Gmj080305/Tdk/README.md

# Tdk

contains all important files i created/used for my 6 weeks internship at TDK Electronics Nashik
Current Projects:
1] new avenues for film capacitors due to new tech advancements
2] implementing ESL measurement on an assembly line
