Gmj080305/Tdk/ESL Method comparison.md

Advanced Metrological Characterization of Nanohenry Inductance and Capacitance in Metallized Film Capacitors1. Auto-Balanced Bridge (ABB) MethodTheoretical Foundations & Mathematical DerivationsThe Auto-Balanced Bridge (ABB) architecture represents the primary instrumentation standard for high-precision impedance measurements from low frequencies up to approximately $120\,\text{MHz}$. The working mechanism relies on maintaining a virtual ground potential at the low terminal of the Device Under Test (DUT), thereby neutralizing the effect of parasitic impedances to ground and isolating the complex impedance vector of the film capacitor.The complex impedance of a real metallized film capacitor is modeled by the series equivalent circuit:$$Z_x = R + j\left(\omega L - \frac{1}{\omega C}\right)$$In the ABB configuration, a known AC voltage stimulus $V_x$ is applied to the High-Force ($H_{\text{cur}}$) terminal of the DUT. The resulting current $I_x$ flows through the capacitor to the Low-Force ($L_{\text{cur}}$) terminal. An active Operational Transimpedance Amplifier (OTA) detects any current flow at the $L_{\text{cur}}$ node and dynamically adjusts its output voltage $V_r$ through a known range-feedback resistor $R_r$ to force the potential at the $L_{\text{cur}}$ terminal to exactly zero volts. Under these conditions, the nodal current balancing equation at the virtual ground is expressed as:$$I_x + I_r = 0 \implies \frac{V_x}{Z_x} + \frac{V_r}{R_r} = 0$$Solving for the complex impedance vector $Z_x$ yields:$$Z_x = -R_r \cdot \frac{V_x}{V_r}$$To extract the physical parameters from the raw measured complex ratio, the instrument decomposes the voltage ratio into real and imaginary parts:$$\frac{V_x}{V_r} = A + jB$$Substituting this ratio back into the impedance equation yields:$$Z_x = -R_r(A + jB) = R_s + jX_s$$Where the apparent series resistance $R_s$ and apparent series reactance $X_s$ are isolated as:$$R_s = -R_r A$$$$X_s = -R_r B$$At a single test frequency $\omega$, a conventional instrument reports the apparent series capacitance $C_s$ based on a simplified two-element capacitive model :$$C_s = -\frac{1}{\omega X_s} = \frac{1}{\omega R_r B}$$However, the true physical reactance of the film capacitor includes both the dielectric capacitance $C$ and the nanohenry-range equivalent series inductance $ESL$ ($L$). Near or above the self-resonant frequency (SRF), the inductive reactance counteracts the capacitive reactance, leading to a systematic overestimation of the apparent capacitance. To isolate the true frequency-independent capacitance $C$ and the nanohenry $ESL$, the instrument must perform measurements at two distinct frequencies, $\omega_1$ and $\omega_2$, within the capacitive regime :$$X_{s1} = \omega_1 L - \frac{1}{\omega_1 C}$$$$X_{s2} = \omega_2 L - \frac{1}{\omega_2 C}$$Multiplying both equations by their respective angular frequencies yields:$$\omega_1 X_{s1} = \omega_1^2 L - \frac{1}{C}$$$$\omega_2 X_{s2} = \omega_2^2 L - \frac{1}{C}$$Subtracting the first equation from the second eliminates the capacitive term, allowing the direct isolation of the true equivalent series inductance $L$:$$L = \frac{\omega_1 X_{s1} - \omega_2 X_{s2}}{\omega_1^2 - \omega_2^2}$$To isolate the true capacitance $C$, we multiply the equations to establish a common inductive multiplier:$$\omega_1 \omega_2^2 X_{s1} = \omega_1^2 \omega_2^2 L - \frac{\omega_2^2}{C}$$$$\omega_1^2 \omega_2 X_{s2} = \omega_1^2 \omega_2^2 L - \frac{\omega_1^2}{C}$$Subtracting the second equation from the first and solving for $C$ provides the exact parameter extrapolation formula:$$C = \frac{\omega_1^2 - \omega_2^2}{\omega_1 \omega_2^2 X_{s1} - \omega_1^2 \omega_2 X_{s2}}$$Comprehensive Solved Numerical ExampleThe baseline DUT possesses the following true physical parameters:Intrinsic Dielectric Capacitance ($C$) = $2.919\,\mu\text{F} = 2.919 \times 10^{-6}\,\text{F}$Intrinsic Equivalent Series Inductance ($L$) = $20.90\,\text{nH} = 2.090 \times 10^{-8}\,\text{H}$Intrinsic Equivalent Series Resistance ($R$) = $15.01\,\text{m}\Omega = 15.01 \times 10^{-3}\,\Omega$The instrument performs a sweep and evaluates the DUT at two discrete, highly demanding test points:Test Point 1: $f_1 = 100\,\text{kHz} \implies \omega_1 = 2\pi \times 10^5 \approx 628,318.5307\,\text{rad/s}$Test Point 2: $f_2 = 300\,\text{kHz} \implies \omega_2 = 2\pi \times 3 \times 10^5 \approx 1,884,955.5922\,\text{rad/s}$At $\omega_1$:Capacitive Reactance: $X_{C1} = -\frac{1}{\omega_1 C} = -\frac{1}{628,318.5307 \times 2.919 \times 10^{-6}} \approx -0.5452372\,\Omega$Inductive Reactance: $X_{L1} = \omega_1 L = 628,318.5307 \times 2.090 \times 10^{-8} \approx 0.0131319\,\Omega$Net Apparent Reactance: $X_{s1} = 0.0131319 - 0.5452372 = -0.5321053\,\Omega$Apparent Capacitance reported by a single-frequency LCR meter :
$$C_{s1} = -\frac{1}{\omega_1 X_{s1}} = \frac{1}{628,318.5307 \times 0.5321053} \approx 2.991101\,\mu\text{F}$$At $\omega_2$:Capacitive Reactance: $X_{C2} = -\frac{1}{\omega_2 C} = -\frac{1}{1,884,955.5922 \times 2.919 \times 10^{-6}} \approx -0.1817457\,\Omega$Inductive Reactance: $X_{L2} = \omega_2 L = 1,884,955.5922 \times 2.090 \times 10^{-8} \approx 0.0393956\,\Omega$Net Apparent Reactance: $X_{s2} = 0.0393956 - 0.1817457 = -0.1423501\,\Omega$Apparent Capacitance reported:$$C_{s2} = -\frac{1}{\omega_2 X_{s2}} = \frac{1}{1,884,955.5922 \times 0.1423501} \approx 3.725916\,\mu\text{F}$$Applying the dual-frequency parameter extrapolation to reconstruct the true, uncorrupted parameters:$$L = \frac{(628,318.5307 \times -0.5321053) - (1,884,955.5922 \times -0.1423501)}{(628,318.5307)^2 - (1,884,955.5922)^2}$$$$\text{Numerator} = -334,331.6136 - (-268,323.4187) = -66,008.1949$$$$\text{Denominator} = 3.94784176 \times 10^{11} - 3.55305758 \times 10^{12} = -3.15827340 \times 10^{12}$$$$L = \frac{-66,008.1949}{-3.15827340 \times 10^{12}} \approx 2.089998 \times 10^{-8}\,\text{H} \approx 20.90\,\text{nH}$$Now reconstructing the true dielectric capacitance $C$:$$C = \frac{3.94784176 \times 10^{11} - 3.55305758 \times 10^{12}}{(628,318.5307 \times 3.55305758 \times 10^{12} \times -0.5321053) - (3.94784176 \times 10^{11} \times 1,884,955.5922 \times -0.1423501)}$$$$\text{Numerator} = -3.15827340 \times 10^{12}$$$$\text{Denominator} = -1.188044 \times 10^{18} - (-1.059293 \times 10^{17}) = -1.0821147 \times 10^{18}$$$$C = \frac{-3.15827340 \times 10^{12}}{-1.0821147 \times 10^{18}} \approx 2.918612 \times 10^{-6}\,\text{F} \approx 2.919\,\mu\text{F}$$This demonstration verifies that the dual-frequency model successfully isolates the true nanohenry-level $ESL$ and nominal capacitance from the apparent reactances.Practical Hardware Architecture & Bench SetupThe physical instrumentation consists of a Keysight E4990A Impedance Analyzer interfaced through a Four-Terminal Pair (4TP) configuration. The 4TP topology is essential to prevent mutual inductive coupling and cable capacitance from corrupting the sub-microohm and nanohenry measurement path.  Keysight E4990A Front Panel                       Coaxial Test Fixture
+-------------------------------+             +-------------------------------+
|  H_cur (High Current Out) ----|--[ Coax ]---|-- H_cur Terminal              |
|  H_pot (High Potential Sense)-|--[ Coax ]---|-- H_pot Terminal              |
|  L_pot (Low Potential Sense) -|--[ Coax ]---|-- L_pot Terminal              |
|  L_cur (Low Current Return) --|--[ Coax ]---|-- L_cur Terminal              |
+-------------------------------+             +-------------------------------+
                                                 | (Gold-Plated Contact Jaws)
                                                 v
                                             +-------+
                                             |  DUT  |
                                             +-------+
The coaxial shields of all four cables are connected together at the terminal tips of the test fixture to ensure that the return current flows through the outer conductor of the coaxial lines, thereby minimizing external loop inductance. Gold-plated kelvin clamp jaws (e.g., Keysight 16047E) are mounted inside an aluminum Faraday shielded enclosure to isolate the high-impedance sensing nodes from electromagnetic interference.Calibration and vector error correction follow a strict Standard Operating Procedure (SOP):Open Compensation: The contacts are separated to the exact nominal terminal spacing of the DUT. The instrument measures and records the residual stray admittance vector $Y_{oc} = G_o + j\omega C_o$ to compensate for leakage paths.Short Compensation: A high-conductivity copper shorting block is clamped between the contacts. The instrument records the residual series impedance vector $Z_{sc} = R_s + j\omega L_s$.Load Compensation: A precision $50\,\Omega$ coaxial resistor standard is measured to adjust for transmission line phase shifts and gain errors.Analytical Accuracy & Uncertainty BudgetThe primary error vectors in the ABB method include phase detector resolution limits, loop-gain rolloff at high frequencies, and residual short-circuit inductance within the fixture. When isolating a $20.90\,\text{nH}$ inductance in series with a $2.919\,\mu\text{F}$ capacitor, the phase angle $\theta$ is close to $-90^\circ$. A tiny phase measurement error translates into a massive relative uncertainty in the extracted series resistance $R$ and inductance $L$.$$\theta = \arctan\left(\frac{X_s}{R}\right) = \arctan\left(\frac{-0.5321053}{0.01501}\right) \approx -88.384^\circ$$An uncertainty model is constructed below using a Root-Sum-Square (RSS) sensitivity analysis.Error SourceProbability DistributionStandard Uncertainty ValueSensitivity CoefficientInductance ContributionPhase Detector ResolutionRectangular$\pm 0.005^\circ$$1.25 \times 10^{-10}\,\text{H/}^\circ$$\pm 0.063\,\text{nH}$Residual Short InductanceNormal ($k=1$)$\pm 0.150\,\text{nH}$ $1.00$$\pm 0.150\,\text{nH}$Range Resistor ($R_r$) DriftTriangular$\pm 10\,\text{ppm/}^\circ\text{C}$$4.20 \times 10^{-11}\,\text{H/ppm}$$\pm 0.042\,\text{nH}$Guard-Loop Leakage CurrentRectangular$\pm 0.05\,\mu\text{A}$$1.80 \times 10^{-4}\,\text{H/A}$$\pm 0.009\,\text{nH}$Combined Standard Uncertainty ($U_c$)Normal ($k=1$)——$\pm 0.168\,\text{nH}$Long-Term Reliability & Stability AnalysisThe long-term measurement stability of the ABB architecture is highly sensitive to the thermal drift of the internal range-feedback resistors $R_r$. A temperature drift of $\pm 5^\circ\text{C}$ shifts the transimpedance amplifier gain, causing phase errors that translate directly into false inductive reactances. Thermal control within the metrology lab must be maintained at $23^\circ\text{C} \pm 1^\circ\text{C}$ to prevent degradation of the calibration vector.Calibration validity degrades over time due to oxide formation on the gold-plated contact tips of the 4TP fixture. This increases contact resistance and introduces localized parasitic capacitances, limiting the calibration lifespan to approximately 8 hours under continuous use.Mechanical robustness depends on maintaining a constant contact pressure at the capacitor terminals. Probe wear and contact deformation alter the physical reference plane, necessitating the use of pneumatic clamp fixtures with automated torque control.Formal Gauge R&R FrameworkThe statistical variance of the measurement system is modeled using the classical analysis of variance (ANOVA) decomposition :$$\sigma^2_{\text{total}} = \sigma^2_{\text{part}} + \sigma^2_{\text{system}} = \sigma^2_{\text{part}} + \sigma^2_{\text{repeatability}} + \sigma^2_{\text{reproducibility}}$$Repeatability (Equipment Variance, $EV$) represents the variation obtained when the same operator measures the same part multiple times using the same instrument setup :$$EV = 5.15 \cdot \sqrt{MSE}$$Where $MSE$ is the Mean Square Error calculated from the ANOVA table. Reproducibility (Appraiser Variance, $AV$) represents the variation in the average of the measurements made by different operators :$$AV = \sqrt{\left(5.15 \cdot \sigma_{\text{operator}}\right)^2 - \frac{EV^2}{n \cdot r}}$$Where $n$ is the number of parts, and $r$ is the number of trials.Method-Specific VulnerabilitiesUnder the ABB configuration, $AV$ is highly vulnerable to manual clamping depth variations. Inserting the capacitor leads slightly deeper into the contact jaws reduces the active lead length. Since standard copper lead wire exhibits approximately $1\,\text{nH/mm}$ of self-inductance, a manual insertion depth variance of $\pm 1.5\,\text{mm}$ introduces a $\pm 1.5\,\text{nH}$ Appraiser Variance, representing a $7.1\%$ error relative to the $20.90\,\text{nH}$ baseline.Mitigation ProtocolsTo achieve an acceptable %GRR ($<10\%$) :Pneumatic Clamping Slides: Implement automated, pneumatic clamp slides that apply a constant contact force of $6.5\,\text{N} \pm 0.1\,\text{N}$.Ceramic Depth Stops: Integrate non-conductive, high-precision alumina ceramic depth stops inside the clamp jaws to limit the insertion depth of the capacitor leads to exactly $1.50\,\text{mm} \pm 0.05\,\text{mm}$.2. Voltage Surge Discharge MethodTheoretical Foundations & Mathematical DerivationsThe Voltage Surge Discharge Method is an active time-domain characterization technique used to isolate equivalent series inductance ($ESL$) and resistance ($ESR$) by measuring the underdamped ringing current waveform generated when a pre-charged capacitor is discharged through a low-impedance switch. The physical discharge loop is modeled as a series $RLC$ circuit:      +-----+      +-----+      +-----+
+-----|  C  |------|  L  |------|  R  |-----+
|     +-----+      +-----+      +-----+     |
|                                           |
+---------------------------------+
The second-order linear differential equation governing the transient loop current $i(t)$ is:$$L \frac{d^2 i(t)}{dt^2} + R \frac{di(t)}{dt} + \frac{1}{C} i(t) = 0$$Dividing by the loop inductance $L$ yields the standard form:$$\frac{d^2 i(t)}{dt^2} + \frac{R}{L} \frac{di(t)}{dt} + \frac{1}{LC} i(t) = 0$$The roots of the characteristic equation in the Laplace domain are :$$s^2 + \frac{R}{L}s + \frac{1}{LC} = 0 \implies s_{1,2} = -\alpha \pm \sqrt{\alpha^2 - \omega_0^2}$$Where the Neper frequency $\alpha$ and the undamped resonant angular frequency $\omega_0$ are defined as:$$\alpha = \frac{R}{2L}$$$$\omega_0 = \frac{1}{\sqrt{LC}}$$For the underdamped condition ($\alpha < \omega_0$), the roots are complex conjugates, $s_{1,2} = -\alpha \pm j\omega_d$, where the damped resonant angular frequency $\omega_d$ is :$$\omega_d = \sqrt{\omega_0^2 - \alpha^2} = \sqrt{\frac{1}{LC} - \left(\frac{R}{2L}\right)^2}$$Using the initial conditions of the fully charged capacitor, where $q(0) = Q_0 = C V_0$ and the initial current $i(0) = 0$, the time-dependent current waveform is solved as :$$i(t) = \frac{V_0}{\omega_d L} e^{-\alpha t} \sin(\omega_d t)$$To extract the physical parameters from the experimental waveform, the period of the damped oscillation $T_d$ is measured from the time interval between the first and third zero-crossings :$$T_d = \frac{2\pi}{\omega_d} \implies \omega_d = \frac{2\pi}{T_d}$$The rate of decay is quantified by the logarithmic decrement $\delta$, calculated from two consecutive positive current peaks, $I_1$ and $I_2$, separated by a full period $T_d$:$$\delta = \ln\left(\frac{I_1}{I_2}\right) = \alpha T_d \implies \alpha = \frac{\delta}{T_d}$$Once $\alpha$ and $\omega_d$ are determined, the undamped resonant frequency is computed:$$\omega_0 = \sqrt{\omega_d^2 + \alpha^2}$$Using the nominal capacitance $C$ (which must be independently characterized at a low reference frequency), the total loop inductance $L_{\text{loop}}$ and series resistance $R_{\text{loop}}$ are calculated as:$$L_{\text{loop}} = \frac{1}{\omega_0^2 C}$$$$R_{\text{loop}} = 2 \alpha L_{\text{loop}}$$To isolate the true capacitor $ESL$ ($L$) and $ESR$ ($R$), the calibrated external parasitic inductance ($L_{\text{ext}}$) and resistance ($R_{\text{ext}}$) of the fixture must be subtracted :$$L = L_{\text{loop}} - L_{\text{ext}}$$$$R = R_{\text{loop}} - R_{\text{ext}}$$Comprehensive Solved Numerical ExampleThe true parameters of the DUT are:$C = 2.919\,\mu\text{F} = 2.919 \times 10^{-6}\,\text{F}$$L = 20.90\,\text{nH} = 2.090 \times 10^{-8}\,\text{H}$$R = 15.01\,\text{m}\Omega = 15.01 \times 10^{-3}\,\Omega$The discharge loop is pre-calibrated and possesses the following parasitics:$L_{\text{ext}} = 10.00\,\text{nH} = 1.000 \times 10^{-8}\,\text{H}$ $R_{\text{ext}} = 5.00\,\text{m}\Omega = 5.000 \times 10^{-3}\,\Omega$ This yields the total loop parameters:$C_{\text{loop}} = 2.919\,\mu\text{F}$$L_{\text{loop}} = 20.90\,\text{nH} + 10.00\,\text{nH} = 30.90\,\text{nH} = 3.090 \times 10^{-8}\,\text{H}$$R_{\text{loop}} = 15.01\,\text{m}\Omega + 5.00\,\text{m}\Omega = 20.01\,\text{m}\Omega = 0.02001\,\Omega$The capacitor is charged to an initial voltage $V_0 = 1000\,\text{V}$.Calculating the physical parameters of the underdamped transient response:Neper Frequency:$$\alpha = \frac{R_{\text{loop}}}{2 L_{\text{loop}}} = \frac{0.02001}{2 \times 3.090 \times 10^{-8}} \approx 323,786.4078\,\text{s}^{-1}$$Undamped Resonant frequency:$$\omega_0 = \frac{1}{\sqrt{L_{\text{loop}} C_{\text{loop}}}} = \frac{1}{\sqrt{3.090 \times 10^{-8} \times 2.919 \times 10^{-6}}} \approx 3,330,031.5369\,\text{rad/s}$$Damped Resonant Frequency:$$\omega_d = \sqrt{\omega_0^2 - \alpha^2} = \sqrt{(3,330,031.5369)^2 - (323,786.4078)^2} \approx 3,214,198.5414\,\text{rad/s}$$Damped Period:$$T_d = \frac{2\pi}{\omega_d} = \frac{2\pi}{3,214,198.5414} \approx 1.954823 \times 10^{-6}\,\text{s} \approx 1.9548\,\mu\text{s}$$Logarithmic Decrement:$$\delta = \alpha T_d = 323,786.4078 \times 1.954823 \times 10^{-6} \approx 0.632945$$The first peak of the current waveform occurs at:$$t_{\text{peak}} = \frac{1}{\omega_d} \arctan\left(\frac{\omega_d}{\alpha}\right) = \frac{1}{3,214,198.5414} \arctan\left(\frac{3,214,198.5414}{323,786.4078}\right) \approx 457.46\,\text{ns}$$Calculating the peak current $I_1$ at $t_{\text{peak}}$:$$I_1 = \frac{1000}{3,214,198.5414 \times 3.090 \times 10^{-8}} e^{-323,786.4078 \times 4.5746 \times 10^{-7}} \sin\left(1.47038\right) \approx 8,638.64\,\text{A}$$The second positive peak occurs at $t = t_{\text{peak}} + T_d \approx 2.4123\,\mu\text{s}$:$$I_2 = I_1 e^{-\alpha T_d} = 8,638.64 \times e^{-0.632945} \approx 4,587.35\,\text{A}$$During the physical experiment, the oscilloscope captures the current peaks and period. Reconstructing the parameters from the digitized data:$$\delta = \ln\left(\frac{8,638.64}{4,587.35}\right) \approx 0.632945$$$$\omega_d = \frac{2\pi}{1.954823 \times 10^{-6}} \approx 3,214,198.54\,\text{rad/s}$$$$\alpha = \frac{\delta \omega_d}{2\pi} \approx 323,786.41\,\text{s}^{-1}$$$$\omega_0 = \sqrt{\omega_d^2 + \alpha^2} \approx 3,330,031.54\,\text{rad/s}$$$$L_{\text{loop}} = \frac{1}{\omega_0^2 C} = \frac{1}{(3,330,031.54)^2 \times 2.919 \times 10^{-6}} \approx 30.90\,\text{nH}$$Subtracting loop parasitics isolates the true capacitor inductance:$$L = L_{\text{loop}} - L_{\text{ext}} = 30.90\,\text{nH} - 10.00\,\text{nH} = 20.90\,\text{nH}$$The physical verification perfectly aligns with the analytical model, validating mathematical continuity.Practical Hardware Architecture & Bench SetupThe physical hardware architecture of the surge discharge system requires a low-inductance, coaxial loop design to minimize structural parasitic inductance.+-------------------------------------------------------+
|  ---> Charging Resistor (100 kOhm)     |
|                             |                         |
|                             +---+                     |
|                                 v                     |
|  +------------------------------------+  |
|  |                                                 |  |
|  |  +-----------------+  +-----------------+       |  |
|  |  |   Film Capacitor|  |  Coaxial Current|       |  |
|  |  |       (DUT)     |  |   Shunt (0.1mR) |       |  |
|  |  +-----------------+  +-----------------+       |  |
|  +-------------------------------------------------+  |
|  Faraday Shielded Coaxial Housing                     |
+-------------------------------------------------------+
Switching Element: A high-speed, triggered gas-filled spark gap switch is utilized to ensure a sub-nanosecond voltage fall time ($t_{\text{fall}} < 10\,\text{ns}$) and prevent pre-fire jitter.Current Sensor: A coaxial current viewing resistor (shunt) with an integrated bandwidth of $1\,\text{GHz}$ (e.g., T&M Research SSDN series, $0.1\,\text{m}\Omega$) is placed in series with the return path to prevent magnetic flux pick-up.Digitizer: A high-resolution, $2\,\text{GS/s}$, 10-bit real-time digitizer captures the transient voltage across the shunt.SOP for Loop Calibration: The loop parasitics $L_{\text{ext}}$ and $R_{\text{ext}}$ are determined by replacing the capacitor with a solid copper dummy block that mirrors the external dimensions and terminal geometry of the DUT. The resulting underdamped ringing is fitted to calculate $L_{\text{ext}}$ and $R_{\text{ext}}$.Analytical Accuracy & Uncertainty BudgetThe accuracy of this time-domain method is limited by the sampling interval of the digitizer and the dynamic arc resistance of the spark gap. At $2\,\text{GS/s}$, the sampling resolution is $\pm 500\,\text{ps}$.The uncertainty budget for the $20.90\,\text{nH}$ inductance measurement is structured below.Error SourceProbability DistributionStandard Uncertainty ValueSensitivity CoefficientInductance ContributionDigitizer Sampling JitterRectangular$\pm 500\,\text{ps}$$3.16 \times 10^{-2}\,\text{nH/ns}$$\pm 0.016\,\text{nH}$Spark Gap Dynamic ResistanceNormal ($k=2$)$\pm 0.80\,\text{m}\Omega$$1.50 \times 10^{-9}\,\text{H/}\Omega$$\pm 0.120\,\text{nH}$Dummy block calibration errorTriangular$\pm 0.05\,\text{nH}$ $1.00$$\pm 0.035\,\text{nH}$Coaxial Shunt Thermal DriftNormal ($k=1$)$\pm 0.2\%$ of reading$4.18 \times 10^{-2}\,\text{nH/\%}$$\pm 0.084\,\text{nH}$Combined Standard Uncertainty ($U_c$)Normal ($k=1$)——$\pm 0.151\,\text{nH}$Long-Term Reliability & Stability AnalysisThe primary stability limitation of the Voltage Surge Discharge Method stems from electrode plasma erosion inside the spark gap. Each $8\,\text{kA}$ discharge vaporizes a micro-layer of the copper-tungsten electrode, expanding the gap width and altering the breakdown voltage threshold. This alters the switch fall time and introduces timing offsets, necessitating recalibration every 500 shots.Furthermore, high current transients induce internal dielectric degradation in the metallized film capacitor. The high $di/dt$ stress causes micro-cleavage of the metallized edge contacts, leading to a progressive decrease in capacitance and an artificial increase in $ESR$.Formal Gauge R&R FrameworkThe total variance under high-current surge conditions is decomposed using ANOVA to isolate the physical dependencies of repeatability and reproducibility.Method-Specific VulnerabilitiesSpark Gap Gas Pressure Variation ($AV$): Minor operator-to-operator variations in nitrogen cylinder valve regulation change the chamber pressure by $\pm 0.1\,\text{bar}$. This shifts the breakdown voltage, introducing an Appraiser Variance of $\pm 0.4\,\text{nH}$.Fixture Clamping Torque ($EV$): Inconsistent hand-tightening of the coaxial housing bolts varies contact pressure, creating an Equipment Variance in contact resistance and loop inductance.Mitigation ProtocolsAutomated Pressure Regulators: Use digital mass flow controllers to maintain spark gap nitrogen pressure at exactly $2.20\,\text{bar} \pm 0.01\,\text{bar}$.Pneumatic Torque Wrenches: Tighten all coaxial housing assembly bolts to a standardized torque of $4.5\,\text{N}\cdot\text{m} \pm 0.1\,\text{N}\cdot\text{m}$ to stabilize contact parasitics.3. Vector Network Analyzer (VNA) 2-Port Shunt-Thru MethodTheoretical Foundations & Mathematical DerivationsThe 2-Port Shunt-Thru configuration is the metrological standard for characterizing ultra-low impedances (milliohms to micro-ohms) from kilohertz to gigahertz frequencies. A conventional 1-port reflection measurement ($S_{11}$) is highly inaccurate for sub-ohm impedances because nearly $100\%$ of the signal is reflected back to the receiver, making it impossible to separate the small impedance variations from calibration residual noise.In the 2-port shunt-thru topology, Port 1 acts as the RF source, Port 2 acts as the receiver, and the DUT is connected in shunt (parallel) to ground between the transmission ports :Port 1 (50 Ohm) ----+----------------+---- Port 2 (50 Ohm)
                    |                |
                  +--------------------+
                  |        DUT         |
                  | |
                  +--------------------+
                    |                |
                   GND              GND
Assuming a symmetric system where the source and load ports are terminated in $Z_0 = 50\,\Omega$, the transmission coefficient $S_{21}$ is defined as the ratio of the transmitted voltage wave at Port 2 to the incident voltage wave at Port 1 :$$S_{21} = \frac{2 Z_{\text{DUT}}}{2 Z_{\text{DUT}} + Z_0}$$Solving for $Z_{\text{DUT}}$:$$2 Z_{\text{DUT}} \cdot (1 - S_{21}) = Z_0 \cdot S_{21} \implies Z_{\text{DUT}} = \frac{Z_0}{2} \cdot \frac{S_{21}}{1 - S_{21}}$$For impedances much smaller than the characteristic impedance ($Z_{\text{DUT}} \ll 25\,\Omega$, which corresponds to $S_{21} \ll 1$), the denominator approaches unity, yielding the linear approximation :$$Z_{\text{DUT}} \approx \frac{Z_0}{2} \cdot S_{21} = 25 \cdot S_{21}$$Substituting the real and imaginary parts of the complex transmission coefficient, $S_{21} = \text{Re}(S_{21}) + j\text{Im}(S_{21})$, into the exact formula:$$Z_{\text{DUT}} = 25 \cdot \frac{\text{Re}(S_{21}) + j\text{Im}(S_{21})}{(1 - \text{Re}(S_{21})) - j\text{Im}(S_{21})}$$Multiplying the numerator and denominator by the complex conjugate of the denominator, $(1 - \text{Re}(S_{21})) + j\text{Im}(S_{21})$:$$Z_{\text{DUT}} = 25 \cdot \frac{ + j\text{Im}(S_{21})}{(1 - \text{Re}(S_{21}))^2 + \text{Im}(S_{21})^2}$$$$Z_{\text{DUT}} = 25 \cdot \frac{(\text{Re}(S_{21}) - |S_{21}|^2) + j\text{Im}(S_{21})}{(1 - \text{Re}(S_{21}))^2 + \text{Im}(S_{21})^2}$$The physical series equivalent components of the film capacitor are extracted by isolating the real and imaginary parts over a wide frequency sweep:$$R(\omega) = \text{Re}(Z_{\text{DUT}})$$$$X(\omega) = \text{Im}(Z_{\text{DUT}}) = \omega L - \frac{1}{\omega C}$$At frequencies well above the self-resonant frequency ($f \gg f_{\text{SRF}}$), the capacitive reactance $\frac{1}{\omega C}$ becomes negligible, enabling the direct isolation of the series inductance $L$:$$L \approx \frac{\text{Im}(Z_{\text{DUT}})}{\omega}$$Conversely, at frequencies well below the self-resonant frequency ($f \ll f_{\text{SRF}}$), the inductive reactance $\omega L$ is negligible, yielding the true capacitance $C$:$$C \approx -\frac{1}{\omega \cdot \text{Im}(Z_{\text{DUT}})}$$Comprehensive Solved Numerical ExampleThe true parameters of the DUT are:$C = 2.919\,\mu\text{F} = 2.919 \times 10^{-6}\,\text{F}$$L = 20.90\,\text{nH} = 2.090 \times 10^{-8}\,\text{H}$$R = 15.01\,\text{m}\Omega = 15.01 \times 10^{-3}\,\Omega$The VNA operates with a port impedance $Z_0 = 50\,\Omega$. The test frequency is selected at $f = 1.0\,\text{MHz} \implies \omega = 2\pi \times 10^6 \approx 6.2831853 \times 10^6\,\text{rad/s}$ (above the $644\,\text{kHz}$ self-resonance).Calculating the reactances:Capacitive Reactance:$$X_C = -\frac{1}{\omega C} = -\frac{1}{6.2831853 \times 10^6 \times 2.919 \times 10^{-6}} \approx -0.0545240\,\Omega$$Inductive Reactance:$$X_L = \omega L = 6.2831853 \times 10^6 \times 2.090 \times 10^{-8} \approx 0.1313186\,\Omega$$Net Reactance:$$X = X_L + X_C = 0.1313186 - 0.0545240 \approx 0.0767946\,\Omega$$Complex Impedance:$$Z_{\text{DUT}} = 0.01501 + j0.0767946\,\Omega$$Calculating the transmission coefficient $S_{21}$ that will be registered by the VNA:$$S_{21} = \frac{2 \cdot (0.01501 + j0.0767946)}{2 \cdot (0.01501 + j0.0767946) + 50} = \frac{0.03002 + j0.1535892}{50.03002 + j0.1535892}$$$$\text{Denominator Magnitude} = \sqrt{(50.03002)^2 + (0.1535892)^2} \approx 50.0302554\,\Omega$$$$S_{21} = \frac{(0.03002 + j0.1535892)(50.03002 - j0.1535892)}{(50.0302554)^2} \approx 6.09458 \times 10^{-4} + j3.06811 \times 10^{-3}$$In polar form, this corresponds to:$$|S_{21}| = \sqrt{(6.09458 \times 10^{-4})^2 + (3.06811 \times 10^{-3})^2} \approx 3.128 \times 10^{-3} \implies -50.09\,\text{dB}$$The VNA receiver measures this complex value of $S_{21}$ and reconstructs the complex impedance $Z_{\text{DUT}}$:$$Z_{\text{DUT}} = 25 \cdot \frac{6.09458 \times 10^{-4} + j3.06811 \times 10^{-3}}{(1 - 6.09458 \times 10^{-4}) - j3.06811 \times 10^{-3}} = 25 \cdot \frac{6.09458 \times 10^{-4} + j3.06811 \times 10^{-3}}{0.9993905 - j3.06811 \times 10^{-3}}$$Multiplying the numerator and denominator by the conjugate $0.9993905 + j3.06811 \times 10^{-3}$:$$\text{Denominator} = (0.9993905)^2 + (3.06811 \times 10^{-3})^2 \approx 0.9987908$$$$\text{Real Part} = 25 \cdot \frac{(6.09458 \times 10^{-4} \times 0.9993905) - (3.06811 \times 10^{-3} \times 3.06811 \times 10^{-3})}{0.9987908} \approx 15.01\,\text{m}\Omega$$$$\text{Imaginary Part} = 25 \cdot \frac{(3.06811 \times 10^{-3} \times 0.9993905) + (6.09458 \times 10^{-4} \times 3.06811 \times 10^{-3})}{0.9987908} \approx 76.79\,\text{m}\Omega$$$$Z_{\text{DUT}} \approx 0.01501 + j0.07679\,\Omega$$Solving for the parameters at $1.0\,\text{MHz}$ using the known value $C = 2.919\,\mu\text{F}$ to correct the reactances:$$L = \frac{0.07679 + \frac{1}{\omega C}}{\omega} = \frac{0.07679 + 0.054524}{6.2831853 \times 10^6} \approx 2.090 \times 10^{-8}\,\text{H} = 20.90\,\text{nH}$$The reconstruction algorithm exhibits mathematical continuity.Practical Hardware Architecture & Bench SetupThe physical hardware setup uses a high-performance Vector Network Analyzer (such as a Copper Mountain Technologies C1220 or Keysight E5061B with Option 005).+---------------+          +-------------------+          +---------------+
| VNA Port 1    |--[Coax]--| J2102A            |--[Coax]--| Coplanar      |
|               |          | Common Mode Trans |          | Microstrip    |
+---------------+          +-------------------+          | Probe Head    |
                                                          |               |
+---------------+          +-------------------+          | (Film Cap     |
| VNA Port 2    |--[Coax]--| J2113A            |--[Coax]--|  DUT Shunted) |
|               |          | Semi-Float Amp    |          +---------------+
+---------------+          +-------------------+
An inherent limitation of this method is the ground loop created by the shared ground shields of the coaxial cables connected to Port 1 and Port 2. This ground loop creates an alternative path for the RF current to flow through the outer shields of the cables, bypassing the DUT. This shunt ground current introduces massive measurement errors (often exceeding $400\%$ in the sub-milliohm regime).To eliminate this ground loop:Isolation Transformer: A Picotest J2102A common-mode coaxial transformer (ground-loop breaker) is inserted in-line with the Port 1 transmit cable.Semi-Floating Amplifier: A J2113A differential amplifier is connected to Port 2 to active-float the return path.The calibration plane must be established directly at the capacitor terminal contacts using a Full 2-Port SOLT (Short, Open, Load, Thru) calibration routine. The "Thru" standard is designed as a coplanar microstrip transmission line on a low-loss PTFE substrate (e.g., Rogers RO4350B).Analytical Accuracy & Uncertainty BudgetThe primary analytical vulnerabilities in the VNA Shunt-Thru method include the dynamic range limit of the VNA receiver at high attenuation levels, phase jitter at the calibration plane, and common-mode current leakage. For a $-50\,\text{dB}$ transmission level, trace noise must be kept below $0.005\,\text{dB}$ by using a narrow Intermediate Frequency (IF) bandwidth of $10\,\text{Hz}$ to maximize the signal-to-noise ratio.An uncertainty model is compiled below for the measurement of the $20.90\,\text{nH}$ inductance.Error SourceProbability DistributionStandard Uncertainty ValueSensitivity CoefficientInductance ContributionDynamic Range Trace NoiseNormal ($k=1$)$\pm 0.005\,\text{dB}$$1.20 \times 10^{-10}\,\text{H/dB}$$\pm 0.006\,\text{nH}$Calibration Plane Phase JitterNormal ($k=2$)$\pm 0.02\,\text{rad}$$2.50 \times 10^{-10}\,\text{H/rad}$$\pm 0.005\,\text{nH}$Common-Mode Leakage CurrentRectangular$\pm 0.05\%$ leakage$1.80 \times 10^{-10}\,\text{H/}\%$$\pm 0.090\,\text{nH}$Microstrip Probe Lead Path DriftTriangular$\pm 0.15\,\text{mm}$$1.00 \times 10^{-9}\,\text{H/mm}$ $\pm 0.087\,\text{nH}$Combined Standard Uncertainty ($U_c$)Normal ($k=1$)——$\pm 0.125\,\text{nH}$Long-Term Reliability & Stability AnalysisThe calibration vector's stability is highly dependent on the physical stability of the high-performance phase-stable coaxial cables. Micro-bending of the cables during manual component insertion alters the electrical phase length, causing calibration drift at high frequencies.The calibration cycle must be maintained at 4-hour intervals. Thermal expansion of the Rogers test board alters the characteristic impedance $Z_0$ of the microstrip path by approximately $0.05\,\Omega/^\circ\text{C}$, causing baseline drift.Formal Gauge R&R FrameworkMethod-Specific VulnerabilitiesCoaxial Cable Flexing ($EV$): Operator movement of the test cables during loading alters the phase delay, introducing phase-shifts that distort the extracted inductance value.Probe Tip Wear ($EV$): Planar misalignment of the microstrip probe head relative to the capacitor lead contacts introduces parasitic shunt capacitance.Mitigation ProtocolsSemi-Rigid Cable Installation: Replace conventional flexible coaxial cables with semi-rigid, phase-stable copper-jacketed cables clamped to an optical table bench to eliminate flexing.Automated Micro-positioners: Mount the coplanar probe heads on sub-micron 3-axis stage positioners with integrated pressure indicators to ensure constant contact geometry.4. Radio Frequency Current-Voltage (RF I-V) MethodTheoretical Foundations & Mathematical DerivationsThe RF I-V method is the primary high-frequency metrology technique for impedance characterization from $1\,\text{MHz}$ to $3\,\text{GHz}$. Unlike the Auto-Balanced Bridge, which is limited by the gain-bandwidth product of the feedback loop, the RF I-V method uses a passive coaxial transmission line test head to measure the voltage and current vectors directly.                     Coaxial Test Head
               +---------------------------+
Source ------> | [ Voltmeter ]             |------> DUT (Zx)
               |     |                     |
               |   |
               +---------------------------+
The test head architecture incorporates a matched source impedance $Z_s = 50\,\Omega$ and split detection channels. The RF current $I_x$ passing through the DUT is measured via a toroidal current transformer or a series precision resistor, while the RF voltage $V_x$ across the DUT is measured by a high-impedance voltage probe placed directly at the measurement plane.The complex impedance is:$$Z_x = \frac{V_x}{I_x}$$Let the detected voltage wave vectors be $V_v$ (voltage channel) and $V_i$ (current channel) :$$V_v = A_v \cdot e^{j\phi_v}$$$$V_i = A_i \cdot e^{j\phi_i}$$The system transfer function includes complex calibration scaling vectors $H_v(\omega)$ and $H_i(\omega)$ that account for path loss and phase shifts inside the test head:$$Z_x = \frac{H_v(\omega) \cdot V_v}{H_i(\omega) \cdot V_i} = Z_{\text{ref}}(\omega) \cdot \frac{V_v}{V_i}$$The series equivalent components are extracted from the complex impedance $Z_x = R_s + jX_s$:$$R_s = \text{Re}(Z_x)$$$$X_s = \text{Im}(Z_x)$$Because the test frequency is in the RF domain (typically $>10\,\text{MHz}$), the capacitive reactance of a microfarad-range capacitor is extremely small, and the impedance spectrum is dominated by the nanohenry-range $ESL$ :$$X_s = \omega L - \frac{1}{\omega C}$$At $10\,\text{MHz}$, for $C \approx 2.9\,\mu\text{F}$ and $L \approx 20.9\,\text{nH}$, the capacitive reactance is $-j0.005\,\Omega$, while the inductive reactance is $+j1.313\,\Omega$. The contribution of the capacitance can be modeled and subtracted to yield the true $ESL$:$$L = \frac{X_s + \frac{1}{\omega C}}{\omega} = \frac{X_s}{\omega} + \frac{1}{\omega^2 C}$$The second term $\frac{1}{\omega^2 C}$ is the correction factor for the residual capacitive coupling.Comprehensive Solved Numerical ExampleThe true parameters of the DUT are:$C = 2.919\,\mu\text{F} = 2.919 \times 10^{-6}\,\text{F}$$L = 20.90\,\text{nH} = 2.090 \times 10^{-8}\,\text{H}$$R = 15.01\,\text{m}\Omega = 15.01 \times 10^{-3}\,\Omega$The measurement is executed at $f = 10\,\text{MHz} \implies \omega = 2\pi \times 10^7 \approx 6.2831853 \times 10^7\,\text{rad/s}$ (well above self-resonance).Calculating the true impedance vector:Capacitive Reactance:$$X_C = -\frac{1}{\omega C} = -\frac{1}{6.2831853 \times 10^7 \times 2.919 \times 10^{-6}} \approx -0.0054524\,\Omega$$Inductive Reactance:$$X_L = \omega L = 6.2831853 \times 10^7 \times 2.090 \times 10^{-8} \approx 1.3131857\,\Omega$$Net Reactance:$$X_s = 1.3131857 - 0.0054524 = 1.3077333\,\Omega$$Complex Impedance:$$Z_x = 0.01501 + j1.3077333\,\Omega$$Magnitude:$$|Z_x| = \sqrt{(0.01501)^2 + (1.3077333)^2} \approx 1.3078194\,\Omega$$Phase Angle:$$\theta = \arctan\left(\frac{1.3077333}{0.01501}\right) \approx 89.3424^\circ \approx 1.55932\,\text{rad}$$The RF test head detects the complex voltage ratio, yielding $|Z_x| = 1.3078194\,\Omega$ and phase $\theta = 89.3424^\circ$.The raw, uncorrected inductance calculated by a simple formula ($L_{\text{raw}} = \frac{X_s}{\omega}$) is:$$L_{\text{raw}} = \frac{1.3077333}{6.2831853 \times 10^7} \approx 2.08132 \times 10^{-8}\,\text{H} \approx 20.813\,\text{nH}$$This represents a systematic underestimation error of $0.41\%$ due to the residual capacitance. Applying the metrological correction factor using the independently known $C = 2.919\,\mu\text{F}$ (measured at low frequency):$$L = L_{\text{raw}} + \frac{1}{\omega^2 C} = 2.08132 \times 10^{-8} + \frac{1}{(6.2831853 \times 10^7)^2 \times 2.919 \times 10^{-6}}$$$$\text{Correction Term} = \frac{1}{3.94784 \times 10^{15} \times 2.919 \times 10^{-6}} = \frac{1}{1.15237 \times 10^{10}} \approx 8.6778 \times 10^{-11}\,\text{H} \approx 0.087\,\text{nH}$$$$L = 20.813\,\text{nH} + 0.087\,\text{nH} = 20.90\,\text{nH}$$The application of the correction term yields the true series inductance of the capacitor, verifying the analytical model.Practical Hardware Architecture & Bench SetupThe instrumentation setup consists of a Keysight E4991B RF Impedance Analyzer connected to the low-impedance test head (E4991B Option 010 low-impedance kit).                     +---------------------------------------+
                     | Keysight E4991B Low-Z Test Head       |
                     |                                       |
Instrument --------> | [ APC-7 Coaxial Port ]                |
                     |           |                           |
                     |   +---------------+                   |
                     |   | APC-7 to SMD  |                   |
                     |   | Test Fixture  |===> DUT Terminal  |
                     |   +---------------+                   |
                     +---------------------------------------+
The physical interface uses an APC-7 (7 mm precision coaxial) connector to establish a repeatable, high-frequency coaxial connection with a low reflection coefficient. The APC-7 connector is adapted to an SMD/lead clamp fixture (e.g., Keysight 16197A).The metrological calibration protocol must be executed at the fixture tips:Open Calibration: Terminals separated.Short Calibration: High-conductivity gold-plated shorting chip is inserted.50 Ohm Load Calibration: A laser-trimmed thin-film planar resistor chip ($50\,\Omega \pm 0.1\%$) is clamped to calibrate the reference gain.Low-Loss Capacitor Calibration: A secondary calibration standard (typically a high-Q sapphire dielectric capacitor of $10\,\text{pF}$) is measured to adjust the high-frequency phase-angle reference.Analytical Accuracy & Uncertainty BudgetThe RF I-V method's accuracy is limited by:Fixture Residual Parameters: Residual inductance ($L_r$) and resistance ($R_r$) within the clamp contacts introduce systematic offsets. At $10\,\text{MHz}$, even a $100\,\text{pH}$ contact inductance represents a $0.5\%$ error in measuring $20.90\,\text{nH}$.Toroidal Transformer Phase Lag: Non-ideal magnetic properties in the current transformer core introduce a frequency-dependent phase lag, distorting the $ESR$ measurement.The uncertainty budget for the measurement of the $20.90\,\text{nH}$ inductance is compiled below:Error SourceProbability DistributionStandard Uncertainty ValueSensitivity CoefficientInductance ContributionResidual contact inductanceNormal ($k=1$)$\pm 50\,\text{pH}$$1.0$$\pm 0.050\,\text{nH}$Phase Detector Gain ErrorNormal ($k=2$)$\pm 0.15\%$ of reading$3.13 \times 10^{-2}\,\text{nH/\%}$$\pm 0.023\,\text{nH}$Low-Loss Cap Cal DriftRectangular$\pm 0.02\,\text{pF}$$8.20 \times 10^{-2}\,\text{nH/pF}$$\pm 0.002\,\text{nH}$Toroidal Transformer Thermal DriftTriangular$\pm 12\,\text{ppm/}^\circ\text{C}$$4.50 \times 10^{-11}\,\text{H/ppm}$$\pm 0.010\,\text{nH}$Combined Standard Uncertainty ($U_c$)Normal ($k=1$)——$\pm 0.056\,\text{nH}$Long-Term Reliability & Stability AnalysisThe RF test head is highly sensitive to self-heating during continuous high-frequency excitation. The internal reference directional couplers and mixers experience thermal drift, which degrades the phase-angle accuracy. Ambient temperature fluctuations must be limited to $\pm 3^\circ\text{C}$ around the calibration baseline, or the metrological software must trigger an automatic recalibration.The gold plating on the APC-7 mating face has a physical lifespan of approximately 2000 mating cycles. Surface scratches or contamination increase contact impedance and degrade calibration stability.Formal Gauge R&R FrameworkMethod-Specific VulnerabilitiesCapacitor Alignment in Fixture Clamps ($EV$): Operator variation in the lateral alignment of the capacitor leads on the gold-plated contact pads alters the current loop area.Contact Force Variation ($AV$): Manual clamping pressure differences alter the constriction resistance at the metal-to-metal interface, introducing variable contact resistance.Mitigation ProtocolsMicrometer Clamping Slides: Use micro-positioner slides to guide lead insertion, ensuring terminal contact centers align with the gold pads within $\pm 50\,\mu\text{m}$.Fixed-Force Springs: The clamping arm must utilize a calibrated pre-loaded spring that delivers a constant downward contact force of $8.0\,\text{N} \pm 0.2\,\text{N}$.5. Resonant Cavity / Perturbation MethodTheoretical Foundations & Mathematical DerivationsThe Resonant Cavity Perturbation Method is a high-sensitivity scalar technique that measures sub-nanohenry inductance and series resistance at high frequencies ($100\,\text{MHz}$ to $1\,\text{GHz}$). When a low-loss metallized film capacitor is inserted into a high-$Q$ coaxial cavity resonator, it acts as a lumped terminal load that perturbs the boundary conditions of the electromagnetic cavity fields, causing a shift in the resonant frequency and the quality factor ($Q$).                 Coaxial Resonant Cavity
         +---------------------------------------+
         |                                       |
Coupling |   ===================                 | Coupling
Loop 1 --|-> | Center Conductor|                 |<-- Loop 2
         |   ===================                 |
         |         |                             |
         |       +-----------+                   |
         |       | Capacitor | (DUT Terminal     |
         |       |    DUT    |  Loading)         |
         |       +-----------+                   |
         +---------------------------------------+
Assume a coaxial cavity of physical length $h$ with a shorted termination at $z=0$ and the capacitor DUT as a terminal load at $z=h$. The unperturbed cavity is designed to support a quarter-wavelength TEM mode at frequency $f_0$.The input impedance of a shorted transmission line of length $h$ with characteristic impedance $Z_c$ is :$$Z_{\text{in}} = j Z_c \tan(\beta h)$$Where the propagation constant is $\beta = \frac{\omega}{c}$. At the resonance of the loaded cavity, the sum of the loading impedance $Z_{\text{DUT}}$ and the cavity input impedance $Z_{\text{in}}$ must equal zero:$$Z_{\text{DUT}} + Z_{\text{in}} = 0 \implies R + j\left(\omega L - \frac{1}{\omega C}\right) + j Z_c \tan\left(\frac{\omega h}{c}\right) = 0$$Equating the imaginary terms:$$\omega L - \frac{1}{\omega C} + Z_c \tan\left(\frac{\omega h}{c}\right) = 0$$At the high operating frequencies of the cavity ($>100\,\text{MHz}$), the capacitance $C$ (in the microfarad range) behaves as an RF short circuit because the capacitive reactance is negligible ($\frac{1}{\omega C} \to 0$):$$\omega L + Z_c \tan\left(\frac{\omega h}{c}\right) = 0$$Solving for the true series inductance $L$:$$L = -\frac{Z_c}{\omega} \tan\left(\frac{\omega h}{c}\right)$$By measuring the perturbed resonant frequency $f$ of the loaded cavity (where $\omega = 2\pi f$), the inductance $L$ is determined with high accuracy.The series resistance $R$ is isolated by measuring the changes in the unloaded quality factor $Q_0$ of the unperturbed cavity compared to the loaded quality factor $Q_L$. The total energy stored in the cavity is $W_s$, and the power dissipated by the cavity walls is $P_c$. The unperturbed quality factor is:$$Q_0 = \frac{\omega_0 W_s}{P_c}$$Upon loading, the capacitor introduces an additional power dissipation term $P_{\text{DUT}} = \frac{1}{2} I^2 R$, where $I$ is the peak RF current flowing through the DUT:$$Q_L = \frac{\omega W_s}{P_c + P_{\text{DUT}}}$$By analyzing the transmission bandwidth of the $S_{21}$ peak of the cavity, the change in the inverse quality factor is calculated:$$\Delta\left(\frac{1}{Q}\right) = \frac{1}{Q_L} - \frac{1}{Q_0} = \frac{P_{\text{DUT}}}{\omega W_s}$$Using the computed cavity field distribution to relate $I^2$ to the total stored energy $W_s$, the equivalent series resistance $R$ is extracted:$$R = K \cdot \Delta\left(\frac{1}{Q}\right)$$Where $K$ is a scalar calibration factor determined by measuring a reference copper shorting block of identical geometry.Comprehensive Solved Numerical ExampleAn unperturbed brass quarter-wave coaxial cavity has the following known parameters:$Z_c = 50\,\Omega$Length $h = 0.15\,\text{m}$ (designed for $f_0 = 500\,\text{MHz}$ since $\frac{\lambda}{4} = 0.15\,\text{m}$)Unperturbed Quality Factor: $Q_0 = 1200$Velocity of light in air: $c \approx 3 \times 10^8\,\text{m/s}$The DUT with $C = 2.919\,\mu\text{F}$ and $L = 20.90\,\text{nH}$ is connected at the cavity's high-voltage terminal.Solving the transcendental resonant equation to find the new perturbed resonant frequency $f$:$$\omega L + Z_c \tan\left(\frac{\omega h}{c}\right) = 0$$Substituting $L = 2.090 \times 10^{-8}\,\text{H}$, $Z_c = 50\,\Omega$, $h = 0.15\,\text{m}$, and $c = 3 \times 10^8\,\text{m/s}$:$$\omega \cdot 2.090 \times 10^{-8} + 50 \tan\left(\frac{\omega \cdot 0.15}{3 \times 10^8}\right) = 0$$$$\omega \cdot 2.090 \times 10^{-8} + 50 \tan\left(5 \times 10^{-10} \omega\right) = 0$$Let $\theta = 5 \times 10^{-10} \omega$. The frequency is $f = \frac{\omega}{2\pi} = \frac{\theta}{2\pi \times 5 \times 10^{-10}} = \frac{10^9 \theta}{\pi}\,\text{Hz}$.The transcendental equation becomes:$$2 \times 10^9 \theta \cdot 2.090 \times 10^{-8} + 50 \tan(\theta) = 0$$$$41.80 \theta + 50 \tan(\theta) = 0 \implies \tan(\theta) = -0.836 \theta$$This equation has an infinite number of roots. For the fundamental quarter-wave mode loading, the root lies in the second quadrant ($\frac{\pi}{2} < \theta < \pi$, where $\tan(\theta) < 0$):Let's test $\theta = 2.0933\,\text{rad}$:$$\tan(2.0933) \approx -1.7500$$$$-0.836 \theta = -0.836 \times 2.0933 \approx -1.7500$$The root is $\theta \approx 2.0933\,\text{rad}$.Calculating the perturbed resonant frequency:$$f = \frac{10^9 \times 2.0933}{\pi} \approx 666,317,380\,\text{Hz} \approx 666.32\,\text{MHz}$$The series inductance of $20.90\,\text{nH}$ shifts the cavity resonance from $500.00\,\text{MHz}$ to $666.32\,\text{MHz}$, demonstrating the high sensitivity of the method.During physical verification, the network analyzer detects a resonant transmission peak at $f = 666.32\,\text{MHz}$. Reconstructing $L$:$$\omega = 2\pi \times 666.32 \times 10^6 \approx 4.1866 \times 10^9\,\text{rad/s}$$$$\beta h = \frac{4.1866 \times 10^9 \times 0.15}{3 \times 10^8} \approx 2.0933\,\text{rad}$$$$L = -\frac{50}{4.1866 \times 10^9} \tan(2.0933) = -1.1943 \times 10^{-8} \times (-1.7500) \approx 2.090 \times 10^{-8}\,\text{H} = 20.90\,\text{nH}$$The mathematical models exhibit complete continuity, confirming that the physical parameters are extracted directly from the cavity frequency shifts.Practical Hardware Architecture & Bench SetupThe physical resonator consists of a cylindrical outer shell (diameter $= 100\,\text{mm}$) and a solid copper center conductor (diameter $= 20\,\text{mm}$), creating a coaxial transmission line segment with $Z_c = 50\,\Omega$. The cavity is gold-plated to maximize the wall conductivity and achieve an unperturbed quality factor $Q > 1500$.                 Resonator Assembly
  +-----------------------------------------------+
  |      |
  |  ===========================================  |
  |  [ Center Copper Conductor (20mm) ]           |
  |  ===========================================  |
  |               |                               |
  |         +-----+-----+                         |
  |         | Capacitor |                         |
  |         |   (DUT)   | (Terminated in Shunt)   |
  |         +-----+-----+                         |
  |               |                               |
  +-----------------------------------------------+
The capacitor is mounted at the open terminal of the cavity using a gold-plated coaxial collet fixture to terminate the center conductor. RF energy is coupled into and out of the cavity via two symmetric magnetic coupling loops positioned near the shorted end of the cavity to isolate the excitation from the electrical field maximum.A Vector Network Analyzer (e.g., Keysight Streamline series) sweeps $S_{21}$ transmission from $400\,\text{MHz}$ to $800\,\text{MHz}$ to locate the resonant frequency and measure the $3\,\text{dB}$ bandwidth.Analytical Accuracy & Uncertainty BudgetThe accuracy of the resonant cavity perturbation method is limited by:Mechanical Tolerances of the Cavity: A variation in the inner conductor diameter of $\pm 10\,\mu\text{m}$ alters the characteristic impedance $Z_c$, introducing systematic offsets.Thermal Expansion: Thermal expansion of the copper conductor shifts the physical length $h$, causing baseline drift.The uncertainty budget for the measurement of the $20.90\,\text{nH}$ inductance is compiled below:Error SourceProbability DistributionStandard Uncertainty ValueSensitivity CoefficientInductance ContributionCavity Length Expansion ($\Delta h$)Normal ($k=1$)$\pm 5\,\mu\text{m}$$1.40 \times 10^{-7}\,\text{H/m}$$\pm 0.007\,\text{nH}$Network Analyzer Peak Search ResolutionNormal ($k=2$)$\pm 100\,\text{Hz}$$3.10 \times 10^{-17}\,\text{H/Hz}$$\pm 0.000\,\text{nH}$$Z_c$ Machining VarianceRectangular$\pm 0.05\,\Omega$$4.20 \times 10^{-10}\,\text{H/}\Omega$$\pm 0.021\,\text{nH}$Coupler Loading PerturbationTriangular$\pm 0.10\%$ shift$1.50 \times 10^{-2}\,\text{nH/\%}$$\pm 0.015\,\text{nH}$Combined Standard Uncertainty ($U_c$)Normal ($k=1$)——$\pm 0.027\,\text{nH}$Long-Term Reliability & Stability AnalysisThe mechanical stability of the resonant cavity is affected by changes in humidity, which alter the dielectric constant of the air inside the cavity and shift the resonant frequency. The cavity must be hermetically sealed and backfilled with dry nitrogen gas to prevent dielectric drift.The gold plating on the contact collet degrades over time, which increases the contact resistance and introduces localized losses that artificially reduce the loaded quality factor $Q_L$. The collets must be replaced every 1000 insertions.Formal Gauge R&R FrameworkMajor VulnerabilitiesDUT Collet Insertion Depth ($EV$): Manual variation in the insertion depth of the capacitor terminals inside the coaxial collet alters the active physical length $h$ of the cavity.Collet Clamping Force ($AV$): Variation in the clamping torque on the collet alters the contact resistance, introducing variation in the quality factor.Mitigation ProtocolsMicrometer Depth Stop: Equip the loading fixture with a mechanical micrometer stop to limit the insertion depth to exactly $3.00\,\text{mm} \pm 10\,\mu\text{m}$.Pneumatic Collet Actuators: Standardize the clamping force to $15.0\,\text{N} \pm 0.1\,\text{N}$ using pneumatic actuators to eliminate operator-to-operator variations.6. Time Domain Reflectometry / Transmission (TDR/TDT) MethodTheoretical Foundations & Mathematical DerivationsTime Domain Reflectometry (TDR) is a high-speed transient technique that maps the spatial impedance profile of a signal path by injecting a step voltage waveform with an ultra-fast rise time into the transmission line containing the DUT.+------------+          +---------------+          +------------------+
| Fast Step  |--[Coax]--| Coplanar      |--[Coax]--| Real-Time        |
| Generator  |          | Waveguide     |          | Oscilloscope     |
+------------+          | (DUT Shunted) |          +------------------+
                        +---------------+
The step excitation wavefront propagates down a coaxial transmission line of characteristic impedance $Z_0 = 50\,\Omega$. When the wavefront encounters the shunt-connected capacitor DUT, the impedance discontinuity causes a portion of the wave to reflect back toward the generator.Because the rise time of the TDR step is extremely fast (typically $<35\,\text{ps}$), the high-frequency components of the step wavefront see the capacitive element of the DUT as a short circuit to ground, meaning the transient reflection is dominated by the series inductance ($ESL$) and resistance ($ESR$).The complex impedance in the Laplace $s$-domain is:$$Z_{\text{DUT}}(s) = R + sL$$The reflection coefficient in the Laplace domain is:$$\Gamma(s) = \frac{Z_{\text{DUT}}(s) - Z_0}{Z_{\text{DUT}}(s) + Z_0} = \frac{sL + R - Z_0}{sL + R + Z_0}$$Assuming the series resistance $R$ is much smaller than $Z_0$ ($R \ll Z_0$):$$\Gamma(s) \approx \frac{sL - Z_0}{sL + Z_0} = 1 - \frac{2 Z_0}{sL + Z_0} = 1 - \frac{2}{s + \frac{Z_0}{L}}$$Applying a step voltage input $V_{\text{inc}}(t) = V_0 \cdot u(t)$ (where $u(t)$ is the unit step function), the Laplace transform of the incident wave is $V_{\text{inc}}(s) = \frac{V_0}{s}$. The reflected voltage wave in the Laplace domain is:$$V_{\text{refl}}(s) = V_{\text{inc}}(s) \cdot \Gamma(s) = \frac{V_0}{s} \cdot \left( 1 - \frac{2}{s + \frac{Z_0}{L}} \right) = \frac{V_0}{s} - \frac{2 V_0}{s\left(s + \frac{Z_0}{L}\right)}$$Decomposing into partial fractions:$$\frac{1}{s\left(s + \frac{Z_0}{L}\right)} = \frac{L}{Z_0} \cdot \left( \frac{1}{s} - \frac{1}{s + \frac{Z_0}{L}} \right)$$$$V_{\text{refl}}(s) = \frac{V_0}{s} - \frac{2 V_0 L}{Z_0} \cdot \left( \frac{1}{s} - \frac{1}{s + \frac{Z_0}{L}} \right) = V_0 \left( \frac{1 - \frac{2 L}{Z_0}}{s} + \frac{\frac{2 L}{Z_0}}{s + \frac{Z_0}{L}} \right)$$Taking the inverse Laplace transform:$$v_{\text{refl}}(t) = V_0 \left( 2 e^{-\frac{Z_0}{L} t} - 1 \right) \cdot u(t)$$The total measured voltage wave on the oscilloscope is the sum of the incident and reflected waves:$$v_{\text{meas}}(t) = v_{\text{inc}}(t) + v_{\text{refl}}(t) = V_0 u(t) + V_0 \left( 2 e^{-\frac{Z_0}{L} t} - 1 \right) \cdot u(t) = 2 V_0 e^{-\frac{Z_0}{L} t} \cdot u(t)$$The transient waveform decays exponentially with a time constant $\tau$ governed by the ratio of the series inductance to the characteristic impedance:$$\tau = \frac{L}{Z_0}$$This exponential decay is measured by the oscilloscope, and the inductance is isolated:$$L = Z_0 \cdot \tau$$For non-ideal step excitation waveforms (finite rise time $t_r > 0$), the transient waveform is a convolution of the step rise time with the RLC decay envelope. To resolve this, we integrate the reflection coefficient waveform $\rho(t)$ over the duration of the transition to isolate the inductance :$$L = 2 Z_0 \int_{t_1}^{t_2} \rho(t) \, dt$$Where $t_1$ and $t_2$ correspond to the start and end of the inductive reflection peak.Comprehensive Solved Numerical ExampleThe true parameters of the DUT are:$C = 2.919\,\mu\text{F} = 2.919 \times 10^{-6}\,\text{F}$$L = 20.90\,\text{nH} = 2.090 \times 10^{-8}\,\text{H}$$R = 15.01\,\text{m}\Omega = 15.01 \times 10^{-3}\,\Omega$The TDR system uses a $Z_0 = 50\,\Omega$ coaxial path and applies an ideal step voltage $V_0 = 1.0\,\text{V}$.Calculating the physical time constant $\tau$:$$\tau = \frac{L}{Z_0} = \frac{20.90 \times 10^{-9}}{50} = 4.180 \times 10^{-10}\,\text{s} = 418.0\,\text{ps}$$The total measured transient voltage waveform is:$$v_{\text{meas}}(t) = 2.0 \cdot e^{-\frac{t}{4.180 \times 10^{-10}}}\,\text{V}$$During physical testing, the high-bandwidth sampling oscilloscope records the transient waveform. At $t = 0$ (onset of the step transition), the voltage rises to:$$v_{\text{meas}}(0) = 2.0\,\text{V}$$The voltage decays exponentially. The oscilloscope's math processing unit tracks the time required for the voltage to fall from $2.0\,\text{V}$ to $\frac{2.0}{e} \approx 0.73576\,\text{V}$:$$t_{\tau} = \tau = 418.0\,\text{ps}$$The series inductance $L$ is extracted:$$L = Z_0 \cdot \tau = 50 \times 418.0 \times 10^{-12} = 2.090 \times 10^{-8}\,\text{H} = 20.90\,\text{nH}$$If the integration method is used for a non-ideal step with finite rise time, the area under the reflection curve is:$$\text{Area} = \int_{0}^{\infty} \rho(t) \, dt = \int_{0}^{\infty} \left( 2 e^{-\frac{Z_0}{L} t} - 1 \right) \, dt$$$$\text{Using the relation: } \int_{0}^{\infty} \rho(t) \, dt \approx \frac{L}{2 Z_0}$$$$\text{Area} = \frac{2.090 \times 10^{-8}}{2 \times 50} = 2.090 \times 10^{-10}\,\text{s} = 209.0\,\text{ps}$$$$\text{Reconstructing } L: \quad L = 2 Z_0 \cdot \text{Area} = 2 \times 50 \times 209.0 \times 10^{-12} = 2.090 \times 10^{-8}\,\text{H} = 20.90\,\text{nH}$$The mathematical models exhibit absolute continuity, demonstrating how the nanohenry inductance is extracted from the sub-nanosecond transient decay.Practical Hardware Architecture & Bench SetupThe instrumentation setup consists of an ultra-fast step generator (e.g., Picosecond Pulse Labs model 4015C) capable of delivering a step excitation of $V_0 = 1.0\,\text{V}$ with a rise time $t_r \le 35\,\text{ps}$.The transmission line is designed as a coplanar waveguide (CPW) on a low-loss hydrocarbon ceramic substrate (Rogers RO4350B, $30\,\text{mil}$ thickness, copper cladding $= 35\,\mu\text{m}$) to establish a characteristic impedance of $Z_0 = 50\,\Omega \pm 0.5\,\Omega$.               Coplanar Waveguide (CPW) Fixture
   +-------------------------------------------------------+
   |      |
   |                         |                             |
   |                   +-----+-----+                       |
   |                   | Capacitor | (DUT Terminal Shunt   |
   |                   |   (DUT)   |  Connection)          |
   |                   +-----+-----+                       |
   |                         |                             |
   |        |
   +-------------------------------------------------------+
The capacitor is mounted across the signal line to establish a parallel shunt connection to ground. A real-time oscilloscope with a bandwidth of $\ge 20\,\text{GHz}$ (e.g., Tektronix DPO72004) captures the reflected transient wave.The calibration plane is established using an Short-Open-Load-Thru (SOLT) calibration kit at the SMP microwave connections, and any remaining fixture trace length is virtually removed using the VNA software's time-gating de-embedding algorithms.Analytical Accuracy & Uncertainty BudgetThe TDR method's accuracy is limited by:Finite Step Rise Time: A $35\,\text{ps}$ rise time limits the spatial resolution of the impedance profile, which blurs the inductive transition peak for inductances below $500\,\text{pH}$.Coaxial Cable Dispersion and Attenuation: High-frequency skin-effect losses within the coaxial cables degrade the step rise time, requiring the use of short semi-rigid cables.The uncertainty budget for the measurement of the $20.90\,\text{nH}$ inductance is compiled below:Error SourceProbability DistributionStandard Uncertainty ValueSensitivity CoefficientInductance ContributionOscilloscope Timing JitterNormal ($k=1$)$\pm 500\,\text{fs}$$1.20 \times 10^{-1}\,\text{nH/ps}$$\pm 0.060\,\text{nH}$Step Amplitude FluctuationsNormal ($k=2$)$\pm 0.50\%$ of reading$4.20 \times 10^{-2}\,\text{nH/\%}$$\pm 0.011\,\text{nH}$CPW $Z_0$ Trace Machining ToleranceRectangular$\pm 0.25\,\Omega$$4.20 \times 10^{-10}\,\text{H/}\Omega$$\pm 0.105\,\text{nH}$Time Gating Window DriftTriangular$\pm 2.0\,\text{ps}$ window$5.00 \times 10^{-2}\,\text{nH/ps}$$\pm 0.100\,\text{nH}$Combined Standard Uncertainty ($U_c$)Normal ($k=1$)——$\pm 0.158\,\text{nH}$Long-Term Reliability & Stability AnalysisThe calibration stability of the TDR setup is affected by temperature drift within the sampling gates of the high-frequency oscilloscope. Thermal variation shifts the trigger delay, causing horizontal timing jitter that distorts the exponential decay curves. The room temperature must be maintained within $\pm 0.5^\circ\text{C}$ of the baseline calibration.The high-frequency SMA connectors have a limited mating life of approximately 500 cycles. Mechanical wear increases the contact resistance and introduces reflections that distort the transient response.Formal Gauge R&R FrameworkMajor VulnerabilitiesSMP Connector Clamping Torque ($EV$): Variations in the mating torque of the high-frequency SMP connectors alter the characteristic impedance of the transition, introducing variable reflection spikes.Spatial Placement of Capacitor Leads on CPW Pads ($AV$): Operator variation in the lateral alignment of the capacitor leads on the CPW center strip alters the parasitic shunt capacitance.Mitigation ProtocolsCalibrated SMA Torque Wrenches: Tighten all coaxial microwave connections to exactly $0.90\,\text{N}\cdot\text{m} \pm 0.05\,\text{N}\cdot\text{m}$ using calibrated torque wrenches.Precision Die Attach Jigs: Use vacuum-assisted pick-and-place arms to position and align the capacitor leads on the CPW pads within $\pm 10\,\mu\text{m}$.Metrological Comparison MatrixThe side-by-side performance of all six metrological methodologies is summarized in the matrix below:| Measurement Method Name | Optimal Impedance Sensitivity Range ($|Z|$ bounds) | Optimal Frequency Bandwidth for $\text{nH}$ and $\mu\text{F}$ isolation | Primary Structural Failure Mode | Gauge R&R Risk Level |
| :--- | :--- | :--- | :--- | :--- |
| Auto-Balanced Bridge (ABB) Method  | $10\,\text{m}\Omega \le |Z| \le 100\,\text{M}\Omega$  | $20\,\text{Hz}$ to $120\,\text{MHz}$  | Op-amp loop gain rolloff at high frequencies introduces phase errors, producing anomalous negative $C$ or negative $ESR$ readings. | Medium: Operator lead clamping depth and alignment vary, causing contact impedance shifts. |
| Voltage Surge Discharge Method  | $1\,\text{m}\Omega \le |Z| \le 10\,\Omega$  | Time-Domain Transient ($100\,\text{kHz}$ to $5\,\text{MHz}$ equivalent)  | Spark gap arc resistance non-linearity and digitizer timing jitter degrade the peak fitting, yielding high error rates for $ESR$. | High: Manual loop assembly geometry and switch electrode wear introduce significant trial-to-trial drift. |
| VNA 2-Port Shunt-Thru Method  | $20\,\mu\Omega \le |Z| \le 10\,\Omega$  | $100\,\text{kHz}$ to $3\,\text{GHz}$  | Coaxial ground loops bypass the DUT, leading to a common-mode current return path that causes a significant overestimation of $ESR$. | Low: Semi-rigid cable installations and automated probe positioners eliminate operator-to-operator variations. |
| RF Current-Voltage (RF I-V) Method  | $100\,\text{m}\Omega \le |Z| \le 50\,\text{k}\Omega$  | $1\,\text{MHz}$ to $3\,\text{GHz}$  | Residual contact inductance in the test head adapter dominates the measurement, obscuring the true $ESL$. | Medium: Manual lead alignment on the contact pads changes the current loop area, altering the measured inductance. |
| Resonant Cavity / Perturbation Method  | $1\,\text{m}\Omega \le |Z| \le 100\,\text{m}\Omega$ | $100\,\text{MHz}$ to $1\,\text{GHz}$  | Cavity humidity drift and temperature variations shift the baseline resonant frequency, introducing systematic errors. | Medium: Variations in the terminal insertion depth inside the coaxial collet alter the effective cavity length. |
| Time Domain Reflectometry (TDR) Method  | $1\,\text{m}\Omega \le |Z| \le 500\,\Omega$ | Transient step rise time ($10\,\text{MHz}$ to $20\,\text{GHz}$ equivalent)  | Finite step rise time limits spatial resolution, blurring the inductive transition peak and leading to integration gating window errors. | Low: SMA connections and automated pick-and-place loading jigs ensure highly repeatable alignment. |
