Gmj080305/Tdk/Impedance analyser analysis.md

Diagnostic Analysis of Impedance Spectroscopy Anomalies in Film Capacitor Qualification Using the Keysight E4990AAnalytical and Mathematical Diagnostics of Single-Frequency Parameter ExtractionMathematical Derivation of Single-Frequency Parameter ExtractionWhen evaluating physical passive components, the standard approach is to model the device under test ($\text{DUT}$) as a lumped element network. For a metallized film capacitor, the physical component is represented as a three-element series network comprising its intrinsic capacitance ($C$), its equivalent series inductance ($\text{ESL}$, denoted as $L$), and its equivalent series resistance ($\text{ESR}$, denoted as $R$). The complex impedance ($Z$) of this series $R-L-C$ network as a function of the angular frequency ($\omega = 2\pi f$) is expressed mathematically as :$$Z = R + j\left(\omega L - \frac{1}{\omega C}\right)$$Impedance analyzers such as the Keysight E4990A utilize the auto-balancing bridge ($\text{ABB}$) technique to measure the complex voltage and current vectors across the terminal interface. The instrument registers the polar parameters of magnitude ($|Z|$) and phase angle ($\theta$). Under standard single-frequency spot measurement configurations (such as $C_s$ or $L_s$), the instrument's firmware translates this measured vector into a simplified, two-element series model ($R_s-C_s$ or $R_s-L_s$).If the instrument is configured to extract series capacitance ($C_s$), it mathematically assumes the complex impedance is defined strictly by a two-element series capacitive model :$$Z = R_s - j\frac{1}{\omega C_s}$$By equating the imaginary (reactive) components of the physical series $R-L-C$ network and the assumed series $R_s-C_s$ model, the operational relationship is defined as:$$-\frac{1}{\omega C_s} = \omega L - \frac{1}{\omega C}$$To isolate the instrument-reported apparent series capacitance ($C_s$), both sides of the equation are multiplied by $-\omega$:$$\frac{1}{C_s} = \frac{1}{C} - \omega^2 L$$By finding a common denominator for the right-hand side of the expression:$$\frac{1}{C_s} = \frac{1 - \omega^2 L C}{C}$$Taking the reciprocal of both sides yields the exact formula utilized by the instrument to calculate and report $C_s$ :$$C_s = \frac{C}{1 - \omega^2 L C}$$Conversely, if the instrument is configured to extract series inductance ($L_s$), it assumes the complex impedance is represented strictly by a series inductive model :$$Z = R_s + j\omega L_s$$By equating the imaginary components of the physical series $R-L-C$ network and the assumed series $R_s-L_s$ model:$$\omega L_s = \omega L - \frac{1}{\omega C}$$Dividing both sides by the angular frequency ($\omega$) yields the exact formula utilized by the instrument to calculate and report $L_s$ :$$L_s = L - \frac{1}{\omega^2 C}$$These two derived relationships demonstrate that the single-frequency spot parameters reported on the instrument display are mathematically dependent on the measurement frequency, the core capacitance, and the parasitic inductance.Empirical Validation and Theoretical Parameter Mapping of Film Capacitor SeriesTo validate these derivations, they are mapped directly to the raw dataset collected from the qualification of the TDK B32926, TDK B81123, and TDK B32922 capacitor series. The broadband-fitted values of $L$, $C$, and $R$ represent the true physical parameters of the capacitors, whereas the reported single-frequency measurements represent the apparent values calculated by the E4990A's simplified firmware algorithms.TDK B32926 Mapping AnalysisThe broadband-fitted parameters for the TDK B32926 series are $L = 20.9\,\text{nH}$, $C = 2.919\,\mu\text{F}$, and $R = 15.01\,\text{m}\Omega$. Using these values, the theoretical values of apparent series capacitance ($C_{s,\text{theo}}$) and apparent series inductance ($L_{s,\text{theo}}$) are calculated across the frequency spectrum.At $f = 1\,\text{kHz}$:$$\omega^2 L C = \left(2\pi \times 10^3\right)^2 \times \left(20.9 \times 10^{-9}\right) \times \left(2.919 \times 10^{-6}\right) \approx 2.41 \times 10^{-6}$$$$C_{s,\text{theo}} = \frac{2.919 \times 10^{-6}}{1 - 2.41 \times 10^{-6}} \approx 2.919\,\mu\text{F}$$$$L_{s,\text{theo}} = 20.9 \times 10^{-9} - \frac{1}{\left(2\pi \times 10^3\right)^2 \times \left(2.919 \times 10^{-6}\right)} \approx -8.682\,\text{mH}$$The raw measured values are $C = 2.82\,\mu\text{F}$ and $\text{ESL} = -9\,\text{mH}$, matching the mathematical projection.At $f = 100\,\text{kHz}$:$$\omega^2 L C = \left(2\pi \times 10^5\right)^2 \times \left(20.9 \times 10^{-9}\right) \times \left(2.919 \times 10^{-6}\right) \approx 0.0241$$$$C_{s,\text{theo}} = \frac{2.919 \times 10^{-6}}{1 - 0.0241} \approx 2.991\,\mu\text{F}$$$$L_{s,\text{theo}} = 20.9 \times 10^{-9} - \frac{1}{\left(2\pi \times 10^5\right)^2 \times \left(2.919 \times 10^{-6}\right)} \approx -847.26\,\text{nH}$$The raw measured values are $C = 2.9\,\mu\text{F}$ and $\text{ESL} = -875\,\text{nH}$, tracking the physical baseline.At $f = 500\,\text{kHz}$:$$\omega^2 L C = \left(2\pi \times 5 \times 10^5\right)^2 \times \left(20.9 \times 10^{-9}\right) \times \left(2.919 \times 10^{-6}\right) \approx 0.6023$$$$C_{s,\text{theo}} = \frac{2.919 \times 10^{-6}}{1 - 0.6023} \approx 7.34\,\mu\text{F}$$$$L_{s,\text{theo}} = 20.9 \times 10^{-9} - \frac{1}{\left(2\pi \times 5 \times 10^5\right)^2 \times \left(2.919 \times 10^{-6}\right)} \approx -13.82\,\text{nH}$$The raw measured values are $C = 6.6\,\mu\text{F}$ and $\text{ESL} = -13\,\text{nH}$. The high capacitance value is a mathematical artifact of operating near resonance.At $f = 1\,\text{MHz}$:$$\omega^2 L C = \left(2\pi \times 10^6\right)^2 \times \left(20.9 \times 10^{-9}\right) \times \left(2.919 \times 10^{-6}\right) \approx 2.4093$$$$C_{s,\text{theo}} = \frac{2.919 \times 10^{-6}}{1 - 2.4093} \approx -2.071\,\mu\text{F}$$$$L_{s,\text{theo}} = 20.9 \times 10^{-9} - \frac{1}{\left(2\pi \times 10^6\right)^2 \times \left(2.919 \times 10^{-6}\right)} \approx 12.217\,\text{nH}$$The raw measured values are $C = -1.9\,\mu\text{F}$ and $\text{ESL} = 12.083\,\text{nH}$, demonstrating the negative capacitance transition past resonance.At $f = 10\,\text{MHz}$:$$\omega^2 L C = \left(2\pi \times 10^7\right)^2 \times \left(20.9 \times 10^{-9}\right) \times \left(2.919 \times 10^{-6}\right) \approx 240.93$$$$C_{s,\text{theo}} = \frac{2.919 \times 10^{-6}}{1 - 240.93} \approx -12.16\,\text{nF}$$$$L_{s,\text{theo}} = 20.9 \times 10^{-9} - \frac{1}{\left(2\pi \times 10^7\right)^2 \times \left(2.919 \times 10^{-6}\right)} \approx 20.81\,\text{nH}$$The raw measured values are $C = -14.10\,\text{nF}$ and $\text{ESL} = 17.8\,\text{nH}$. The inductance value asymptotically approaches the physical $\text{ESL}$ value of $20.9\,\text{nH}$.The empirical datasets for the TDK B81123 and TDK B32922 series show a similar alignment with these mathematical models. At $1\,\text{kHz}$, the TDK B81123 capacitor yields an apparent $\text{ESL}$ value of $-5.37\,\text{H}$, which is mathematically verified by evaluating $L_s = 14.912\,\text{nH} - 1/\left(\omega^2 \times 4.794\,\text{nF}\right) = -5.283\,\text{H}$.For the TDK B32922 series, the nominal core parameters of $L = 6.355\,\text{nH}$, $C = 198.27\,\text{nF}$, and $R = 46.14\,\text{m}\Omega$ resolve an apparent series inductance of $-126\,\text{nH}$ at $1\,\text{MHz}$, aligning with the theoretical derivation of $6.355\,\text{nH} - 127.73\,\text{nH} = -121.38\,\text{nH}$.The complete mapping of the raw data collected for all three qualified capacitor series is summarized in the tables below:Table 1: TDK B32926 Series Diagnostic MappingFrequency (f)Measured C (Cs)Theoretical CsMeasured ESL (Ls)Theoretical LsMeasured ESR$1\,\text{kHz}$$2.82\,\mu\text{F}$$2.919\,\mu\text{F}$$-9\,\text{mH}$$-8.682\,\text{mH}$$19.1\,\text{m}\Omega$$100\,\text{kHz}$$2.9\,\mu\text{F}$$2.992\,\mu\text{F}$$-875\,\text{nH}$$-847.26\,\text{nH}$$8.7\,\text{m}\Omega$$500\,\text{kHz}$$6.6\,\mu\text{F}$$7.341\,\mu\text{F}$$-13\,\text{nH}$$-13.82\,\text{nH}$$14.3\,\text{m}\Omega$$1\,\text{MHz}$$-1.9\,\mu\text{F}$$-2.071\,\mu\text{F}$$12.083\,\text{nH}$$12.217\,\text{nH}$$19.7\,\text{m}\Omega$$10\,\text{MHz}$$-14.10\,\text{nF}$$-12.16\,\text{nF}$$17.8\,\text{nH}$$20.814\,\text{nH}$$90.8\,\text{m}\Omega$Table 2: TDK B81123 Series Diagnostic MappingFrequency (f)Measured C (Cs)Theoretical CsMeasured ESL (Ls)Theoretical LsMeasured ESR$1\,\text{kHz}$$4.7\,\text{nF}$$4.794\,\text{nF}$$-5.37\,\text{H}$$-5.283\,\text{H}$$5.2\,\Omega$$100\,\text{kHz}$$4.7\,\text{nF}$$4.794\,\text{nF}$$-537\,\mu\text{H}$$-528.32\,\mu\text{H}$$124\,\text{m}\Omega$$500\,\text{kHz}$$4.7\,\text{nF}$$4.794\,\text{nF}$$-21\,\mu\text{H}$$-21.13\,\mu\text{H}$$48\,\text{m}\Omega$$1\,\text{MHz}$$4.7\,\text{nF}$$4.794\,\text{nF}$$-5\,\mu\text{H}$$-5.283\,\mu\text{H}$$37\,\text{m}\Omega$$10\,\text{MHz}$$6.6\,\text{nF}$$6.674\,\text{nF}$$-38\,\text{nH}$$-37.89\,\text{nH}$$69\,\text{m}\Omega$$20\,\text{MHz}$$-29.8\,\text{nF}$$-37.45\,\text{nF}$$1.7\,\text{nH}$$1.714\,\text{nH}$$105\,\text{m}\Omega$Table 3: TDK B32922 Series Diagnostic MappingFrequency (f)Measured C (Cs)Theoretical CsMeasured ESL (Ls)Theoretical LsMeasured ESR$1\,\text{kHz}$$190\,\text{nF}$$198.27\,\text{nF}$$-133\,\text{mH}$$-127.73\,\text{mH}$$564\,\text{m}\Omega$$100\,\text{kHz}$$190\,\text{nF}$$198.27\,\text{nF}$$-13\,\mu\text{H}$$-12.77\,\mu\text{H}$$31\,\text{m}\Omega$$500\,\text{kHz}$$190\,\text{nF}$$198.27\,\text{nF}$$-528\,\text{nH}$$-510.9\,\text{nH}$$29\,\text{m}\Omega$$1\,\text{MHz}$$200\,\text{nF}$$208.66\,\text{nF}$$-126\,\text{nH}$$-121.38\,\text{nH}$$37\,\text{m}\Omega$$10\,\text{MHz}$$-48\,\text{nF}$$-49.81\,\text{nF}$$4.9\,\text{nH}$$5.078\,\text{nH}$$69\,\text{m}\Omega$$20\,\text{MHz}$$-11\,\text{nF}$$-10.48\,\text{nF}$$5.7\,\text{nH}$$6.036\,\text{nH}$$132\,\text{m}\Omega$Physical Interpretation of Self-Resonance and Phase Transition MechanismsThe self-resonant frequency ($\text{SRF}$, or $f_0$) is the boundary where the inductive reactance of the $\text{ESL}$ ($X_L = \omega L$) exactly cancels the capacitive reactance of the core capacitance ($X_C = \frac{1}{\omega C}$). At this frequency, the net imaginary component of the series network impedance drops to zero ($X = 0$), and the phase angle ($\theta$) is exactly $0^\circ$. This boundary condition is modeled as:$$f_0 = \frac{1}{2\pi \sqrt{L C}}$$Using the broadband-fitted parameters, the theoretical $\text{SRF}$ values for the four capacitor models in the study are calculated and summarized in Table 4:Table 4: Broadband Fit Parameters and Self-Resonant FrequenciesComponent ModelCore Capacitance (C)Parasitic Inductance (L)Series Resistance (R)Calculated SRF (f0)TDK B32926$2.919\,\mu\text{F}$$20.900\,\text{nH}$$15.01\,\text{m}\Omega$$644.38\,\text{kHz}$TDK B32924$1.399\,\mu\text{F}$$42.690\,\text{nH}$$33.49\,\text{m}\Omega$$651.13\,\text{kHz}$TDK B32922$198.270\,\text{nF}$$6.355\,\text{nH}$$46.14\,\text{m}\Omega$$4.48\,\text{MHz}$TDK B81123$4.794\,\text{nF}$$14.912\,\text{nH}$$97.00\,\text{m}\Omega$$18.82\,\text{MHz}$The physical transitions of the capacitors across these resonant boundaries explain the measured parameters:Sub-Resonant Capacitive Domain ($f < f_0$): Below the self-resonant frequency, capacitive reactance dominates ($X_C > X_L$). The overall reactance is negative, and the phase angle remains in the negative quadrant ($\theta \in [-90^\circ, 0^\circ]$). As the test frequency approaches $f_0$, the inductive reactance partially cancels the capacitive reactance, reducing the net reactance. When calculated through the two-element capacitor model, this reduced reactance is interpreted as an inflated capacitance value ($C_s \to \infty$). This explains why the apparent capacitance of the TDK B32926 increases to $6.6\,\mu\text{F}$ at $500\,\text{kHz}$, which is near its $644.38\,\text{kHz}$ resonant frequency.Super-Resonant Inductive Domain ($f > f_0$): Above the resonant boundary, inductive reactance dominates ($X_L > X_C$). The net reactance is positive, and the phase angle shifts into the positive quadrant ($\theta \in [0^\circ, +90^\circ]$). When the instrument maps this positive reactance to a capacitive model, the resulting value is negative ($C_s < 0$). This transition is seen in the TDK B32926, which reports $-1.9\,\mu\text{F}$ at $1\,\text{MHz}$ and $-14.10\,\text{nF}$ at $10\,\text{MHz}$, as well as the TDK B81123, which transitions to $-29.8\,\text{nF}$ at $20\,\text{MHz}$ after crossing its $18.82\,\text{MHz}$ resonance boundary.Physical and Mathematical Modeling of Negative ResistanceDuring validation checks of the short-circuit ($\text{SC}$) copper plate standard, the E4990A reported negative equivalent series resistance ($\text{ESR}$) values (ranging from $-300\,\mu\Omega$ at low frequencies to $-2.2\,\text{m}\Omega$ at $20\,\text{MHz}$). A negative real resistance is physically impossible for a passive, linear system, as it would violate the conservation of energy by generating power ($P = I^2 R < 0$). The physical source of this negative real resistance can be modeled through the propagation of phase angle sensitivity and calibration standard overcorrection.       Impedance Vector in Super-Low Impedance / Highly Reactive Domain
       
                             +jX (Inductive Reactance)
                               |
                               |  * True Impedance Vector Z_true
                               | /| (Phase angle θ_true ~ 89.99°)
                               |/ |
       -R <--------------------|--+--------------------> +R (Real ESR)
        \  Phase Error Δθ      |  |
         \ (Rotates vector     |  |
          \ into 2nd quadrant) |  |
           *                   |  |
         Z_measured            |
                             -jX (Capacitive Reactance)
The real part of the complex impedance is extracted from the vector magnitude and phase angle :$$\text{ESR} = |Z|\cos\theta$$For a highly conductive standard such as a thick copper plate, the true physical resistance $R$ is in the micro-ohm range, and the inductance is in the pico-henry range. As the test frequency scales, the inductive reactance ($X_L = \omega L$) begins to dominate, pushing the true phase angle ($\theta$) extremely close to $+90^\circ$.The mathematical sensitivity of the extracted resistance with respect to phase angle errors is determined by taking the partial derivative:$$\frac{\partial R}{\partial \theta} = \frac{\partial}{\partial \theta} \left(|Z|\cos\theta\right) = -|Z|\sin\theta$$Near $\theta \approx 90^\circ$, the term $\sin\theta \approx 1$. This indicates that the sensitivity of the resistance measurement to phase errors is maximized when the device is highly reactive. A minute phase measurement error ($\Delta \theta$) translates directly into a systematic offset in the calculated resistance:$$R_{\text{measured}} = |Z|\cos\left(\theta_{\text{true}} + \Delta \theta\right)$$Using trigonometric expansion, this relationship is expressed as:$$R_{\text{measured}} = |Z|\left(\cos\theta_{\text{true}}\cos\Delta\theta - \sin\theta_{\text{true}}\sin\Delta\theta\right)$$Because the true impedance vector is highly reactive ($\theta_{\text{true}} = 90^\circ - \delta$, where $\delta$ is the loss angle $\delta = R_{\text{true}}/|Z| \ll 1$), we substitute this into the expansion:$$\cos\theta_{\text{true}} = \cos\left(90^\circ - \delta\right) = \sin\delta \approx \delta$$$$\sin\theta_{\text{true}} = \sin\left(90^\circ - \delta\right) = \cos\delta \approx 1$$For a small phase measurement error ($\Delta\theta \ll 1$), the approximations $\cos\Delta\theta \approx 1$ and $\sin\Delta\theta \approx \Delta\theta$ are applied. This simplifies the measured resistance formula to:$$R_{\text{measured}} \approx |Z|\left(\delta - \Delta \theta\right) = |Z|\left(\frac{R_{\text{true}}}{|Z|} - \Delta\theta\right) = R_{\text{true}} - |Z|\Delta \theta$$This equation demonstrates that if the instrument's phase measurement error ($\Delta\theta$) is positive, the reported resistance is shifted downward. If the reactive magnitude of the component is large relative to its true resistance ($|Z|\Delta\theta > R_{\text{true}}$), the calculated resistance is forced into negative values.This phase sensitivity error is further compounded by contact resistance overcorrection during the baseline short calibration. The calibration algorithm compensates for the residual path resistance of the fixture using the relationship:$$R_{\text{corrected}} = R_{\text{raw}} - R_{\text{short\_cal}}$$During the baseline $\text{SHORT}$ calibration, the contacts are shorted using a calibration bar. However, if there is finite contact resistance or oxidation on the calibration bar, the instrument registers a non-zero residual resistance $R_{\text{short\_cal}}$ (e.g., $20\text{ m}\Omega$). When the actual measurement is executed on the highly polished, large-surface-area copper plate, the achieved contact resistance is lower than the contact resistance established during calibration ($R_{\text{raw}} < R_{\text{short\_cal}}$). Consequently, the subtraction overcorrects the path loss, forcing $R_{\text{corrected}}$ into negative values (specifically, $-300\text{ }\mu\Omega$ across the sub-megahertz range).At $20\,\text{MHz}$, the measured $\text{ESL}$ of the copper plate is $12.6\,\text{pH}$. The reactive magnitude is $|Z| \approx 2\pi f L = 2\pi \left(2 \times 10^7\right)\left(12.6 \times 10^{-12}\right) \approx 1.583\,\text{m}\Omega$. If a minute phase error of $\Delta\theta \approx +0.13^\circ$ ($2.27\,\text{mrad}$) occurs due to cable temperature variation or transimpedance stage propagation delay, the systematic offset is calculated as :$$\text{Offset} = -|Z|\Delta\theta \approx -\left(1.583 \times 10^{-3}\right) \times \left(2.27 \times 10^{-3}\right) \approx -3.59\,\mu\Omega$$While this phase offset is small, the combination of calibration standard overcorrection ($R_{\text{short\_cal}}$) and phase shift is the primary source of the negative resistance measurements.Instrumental and Algorithmic Limitations of the Keysight E4990ALimitations of Two-Element Approximation in Multi-Element NetworksThe primary operational limitation of the Keysight E4990A under standard LCR mode is its reliance on a two-element lumped parameter calculation. The instrument's internal firmware converts the measured complex voltage and current ratio into a simplified vector containing one real and one imaginary component ($R + jX$ or $G + jB$).This algorithmic reduction is based on the assumption that the component behaves as a single passive element with minor losses. However, physical metallized film capacitors are multi-element distributed networks. As the operating frequency increases, parameters such as the dielectric loss factor ($\tan\delta$), skin-effect-driven electrode resistance, parallel leakage paths, and the loop inductance of the terminal leads interact.When the E4990A attempts to map this multi-element reality to a two-element $R_s-C_s$ or $R_s-L_s$ configuration near or beyond the self-resonant frequency, the calculation is forced to utilize mathematical simplifications. The instrument does not dynamically adjust its model topology to account for the transitioning reactance. It executes the fixed algebraic extraction, outputting physically impossible values (such as negative capacitance and negative inductance). This creates a high risk of misinterpretation during component qualification.Auto-Balancing Bridge (ABB) Vector Impedance LimitsThe auto-balancing bridge ($\text{ABB}$) architecture of the E4990A utilizes a precision transimpedance amplifier configuration to maintain a virtual ground at the low-potential measurement node ($\text{L}_p$). This feedback loop balances the current flowing through the $\text{DUT}$ with the current flowing through an internal range reference resistor ($R_{\text{ref}}$).                     Simplified Auto-Balancing Bridge (ABB) Block Diagram
                     
                          +------------------------+
                          |   Vector Modulator /   |
                          |    Phase Detector      |
                          +-----------+------------+
                                      | (Active Feedback Control)
                                      v
       OSC1 ----> [ H_c ]             |
                    |                 |
                                |
                    |                 v
       Virtual -> [ L_c ] -------> <---- R_ref
       Ground       |
                  [ L_p ] ------> Voltmeters & ADCs (V1, V2)
At the extreme boundaries of the vector impedance plane, the performance limits of this architecture become apparent:Low-Impedance Boundary ($|Z| \to 0\,\Omega$): When measuring the equivalent series resistance ($\text{ESR}$) of high-capacitance film capacitors or short-circuit validation plates, the impedance drop across the $\text{DUT}$ is extremely small. The voltage signal at the high-potential sensing node ($\text{H}_p$) drops toward the noise floor of the instrument's input amplifiers.Highly Reactive Phase Boundary ($\theta \to \pm 90^\circ$): For low-loss capacitors, the phase angle is close to $-90^\circ$. The real part of the vector, representing the component loss, is overshadowed by the dominant imaginary part. For example, at a quality factor $Q = \frac{1}{D} = 1000$, the resistive component represents only $0.1\%$ of the total impedance magnitude.Under these conditions, resolving the $\text{ESR}$ requires measuring the phase angle with micro-degree precision. Any phase measurement jitter, digitizer non-linearity, or thermal noise in the reference clock paths translates directly to phase noise.Because $\cos\left(90^\circ - \phi\right) \approx \phi$ (for small angles in radians), a phase measurement error of just $0.05^\circ$ ($872\,\mu\text{rad}$) in the transimpedance feedback loop will cause the resolved $\text{ESR}$ to deviate by up to $100\%$, often projecting the vector past $+90^\circ$ or $-90^\circ$, resulting in negative loss readings.If the voltage drive level is set too high (exceeding $500\,\text{mVrms}$) during low-impedance testing or SHORT compensation, the feedback amplifier of the transimpedance stage can saturate. This causes the active feedback loop to lose control of the virtual ground potential, triggering a "Bridge Unbalanced" error on the display and invalidating the active measurement data.Test Fixture Parasitics and Interface-Induced High-Frequency SkewConnecting a physical test fixture (such as the Keysight 16047E lead-type fixture) to the E4990A introduces parasitic residuals that are electrically in series with the $\text{DUT}$. The 16047E is rated for measurements up to $120\,\text{MHz}$ and features a four-terminal-pair ($\text{4TP}$) BNC interface to minimize electromagnetic coupling. However, the physical geometry of the terminal contacts and the internal bus bars introduces parasitic residuals :Table 5: Typical Parasitic Residuals of standard 4TP Fixtures (e.g., 16047E)Residual ParameterPhysical OriginTypical Value RangeImpact on HF MeasurementResidual Inductance ($L_{\text{res}}$)Contact bus bars and terminal leads$10\,\text{nH}$ to $30\,\text{nH}$Downward shift of apparent SRFStray Capacitance ($C_{\text{stray}}$)Clamping jaw proximity and insulation$0.5\,\text{pF}$ to $2.0\,\text{pF}$Shunt path leakage at high frequenciesResidual Resistance ($R_{\text{res}}$)Contact interface and lead connections$5\,\text{m}\Omega$ to $20\,\text{m}\Omega$Artificially inflated ESR readings              Equivalent Circuit Model of Fixture Parasitic Interface
              
       E4990A Port Plane                     Component Insertion Plane
       
       [ H_p ] ---+-----------------[ L_res ]---------+--- [ Lead_H ]
                  |                                   |
               [C_stray]                           (Contact Resist)
                  |                                   |
       [ L_p ] ---+-----------------------------------+--- [ Lead_L ]
When high-frequency sweeps are executed without compensating for these interface parasitics, the E4990A measures the composite impedance of the fixture and the component. For example, a lead wire length of just $10\,\text{mm}$ adds approximately $10\,\text{nH}$ of series inductance. At $10\,\text{MHz}$, this residual inductance introduces $+j0.63\,\Omega$ of inductive reactance, which is large enough to shift the apparent resonant frequency of a microfarad-range capacitor downward, skewing high-frequency data.Procedural Guidelines and Corporate Best PracticesStandard Operating Procedure (SOP) for Capacitor QualificationTo ensure repeatable results during qualification trials, the engineering division must enforce the following protocol:        Standard Operating Procedure (SOP) Flowchart
        
    +--------------------------------------------+
    | 1. Environmental Stabilization              |
    |    - Warm-up E4990A for >= 90 minutes      |
    |    - Maintain temperature: 23°C ± 5°C     |
    +---------------------f----------------------+
                          |
                          v
    +--------------------------------------------+
    | 2. Instrument Setup                        |
    |    - Select direct-connect fixture (NONE)  |
    |    - Set OSC Level to 500 mVrms            |
    |    - Set Sweep: Log scale (100 Hz-120 MHz) |
    +---------------------f----------------------+
                          |
                          v
    +--------------------------------------------+
    | 3. High-Precision Compensation             |
    |    - Open: Position contacts at DUT width  |
    |    - Short: Clean contacts, secure bar     |
    |    - Load: Set standard values > 3 MHz     |
    +---------------------f----------------------+
                          |
                          v
    +--------------------------------------------+
    | 4. Data Extraction & Fitting               |
    |    - Run continuous frequency sweep        |
    |    - Execute Equivalent Circuit Analysis   |
    |    - Extract frequency-independent R, L, C |
    +--------------------------------------------+
Step 1: Thermal and Environmental StabilizationEnsure that the laboratory environment is maintained at $23\text{ }^\circ\text{C} \pm 5\text{ }^\circ\text{C}$. Power on the E4990A and allow a minimum warm-up period of 90 minutes. This stabilizes the internal oscillator circuits, phase detectors, and the transimpedance amplifier stage, minimizing thermal drift.Step 2: Instrument Parameter ConfigurationConfigure the instrument to use the direct-connect terminal setting (NONE) when using the 16047E fixture. Set the oscillator level to exactly $500\,\text{mVrms}$. Using an excitation level $> 500\,\text{mVrms}$ during SHORT calibration or low-impedance testing can saturate the transimpedance feedback loop, leading to "Bridge Unbalanced" error flags. Enable the Auto Level Control ($\text{ALC}$) function to maintain a constant test signal level across the sweep. Define the test sweep with logarithmic spacing covering the range from $100\,\text{Hz}$ to the instrument's high-frequency limit.Step 3: High-Precision Fixture CompensationBefore mounting components, clean the clamping contacts of the 16047E fixture using high-purity isopropyl alcohol to minimize contact resistance. Access the Cal Compen menu and set the calibration points to User Freq. This forces the calibration algorithm to measure correction parameters at the exact sweep frequencies defined for the test, bypassing interpolation errors. Proceed with the Open/Short/Load compensation protocol:OPEN Compensation: Adjust the spacing of the clamping contacts to match the exact lead width of the capacitor under test. This ensures that the stray capacitive field during the calibration sweep matches the stray field present during testing. Run the OPEN compensation routine.SHORT Compensation: Insert the certified low-impedance shorting bar into the contact jaws and secure it with the clamping screws to ensure consistent contact pressure. Run the SHORT compensation routine.LOAD Compensation: For test sweeps extending above $3\,\text{MHz}$, load compensation is mandatory to correct for proportional phase errors and propagation delays. Insert a certified $100\,\Omega$ SMD resistor standard into the fixture contacts. Enter the certified calibration values of resistance ($R_{\text{load}}$) and residual inductance ($L_{\text{load}}$) into the E4990A's calibration register, then run the LOAD compensation sweep.Optimization of the Equivalent Circuit Analysis FunctionTo eliminate the frequency-dependent single-parameter artifacts (such as negative apparent capacitance or inductive expansion), the raw sweep data must be processed using the instrument's built-in Equivalent Circuit Analysis Function. This function fits the measured multi-frequency complex impedance sweep data ($Z(\omega)$) to a multi-element lumped parameter model using mathematical regression.Equivalent Circuit Parameter Fit Models (Keysight E4990A)

Model A: Three-Element Resonator Fit (Series R-L-C)
       +------[ L_s ]---[ C_s ]---+
       
Model B: Four-Element High-Leakage Capacitor Fit
       +------[ L_s ]---+---------------+
                               |               |
                               +----[ C_p ]----+
                               |               |
                               +--------+
The E4990A supports seven multi-parameter equivalent circuit models (Models A through G) to accommodate various component topologies. For standard, low-loss metallized film capacitors, Model A (a three-element series $R-L-C$ network) must be selected. If the component exhibits high dielectric leakage or is being characterized under high-temperature stress, Model B (a four-element parallel-series configuration incorporating a parallel leakage resistance $R_p$) should be utilized to isolate core dielectric losses from terminal losses.Once the model is selected, the fitting algorithm must be executed over the entire swept frequency range. The software performs regression fitting of the measured real ($R(\omega)$) and imaginary ($X(\omega)$) impedance components:$$Z_{\text{measured}}(\omega) \approx R_{\text{fit}} + j\left(\omega L_{\text{fit}} - \frac{1}{\omega C_{\text{fit}}}\right)$$This multi-frequency regression decouples the interactive reactive components. The resulting fitted values ($C_{\text{fit}}$, $L_{\text{fit}}$, $R_{\text{fit}}$) represent the physical construction of the capacitor. These values are frequency-independent and unaffected by resonance-induced sign-inversions or magnitude spikes.Advanced Calibration Verification RegimenTo ensure that phase errors are minimized and the instrument resolves micro-ohm and pico-henry impedances traceably, a calibration validation check must be performed prior to each qualification run:            Calibration Verification Flow & Tolerance Matrix
            
       +-------------------------------------------------------+
       | 1. Open Circuit Verification Check                    |
       |    - Spacing matching capacitor body width            |
       |    - Tolerance limits: C_fitted <= 15 fF              |
       |                      R_fitted >= 10 kΩ                |
       +---------------------------f---------------------------+
                                   |
                                   v
       +-------------------------------------------------------+
       | 2. Short Circuit Verification Check                   |
       |    - Polished copper plate standard                   |
       |    - Tolerance limits: R_measured >= 0.00 Ω           |
       |                      ESL_measured >= 0.00 pH          |
       +-------------------------------------------------------+
Step 1: Open Circuit Verification CheckAfter performing fixture compensation, measure the open-circuit impedance across the full frequency sweep. Run the equivalent circuit fitting routine on this open spectrum.The resulting fitted parameters must satisfy the following tolerance limits: the fitted residual capacitance ($C_{\text{fitted}}$) must be less than $15\,\text{fF}$, and the parallel resistance ($R_{\text{fitted}}$) must be greater than $10\,\text{k}\Omega$. If the registered open-circuit capacitance exceeds these limits, it indicates that the contact spacing was adjusted after calibration, requiring a recalibration.Step 2: Short Circuit Verification CheckMount the polished copper plate short-circuit standard in the clamping jaws. Run a frequency sweep and verify the measured $\text{ESR}$ and $\text{ESL}$ values.The verified values must remain non-negative ($\text{ESR} \ge 0.00\,\Omega$ and $\text{ESL} \ge 0.00\,\text{pH}$) across the entire sub-resonant sweep range. If the instrument reports negative resistance values or an inductive fit lower than $-54\,\text{pH}$ (the system's baseline correction limit), it indicates that the contact pressure during the short calibration was inconsistent or that thermal drift has occurred. Clean the terminal interfaces, ensure proper torque is applied to the clamping contacts, and perform the Short calibration again.The baseline verification values for both the open-circuit and short-circuit standards are summarized in Table 6:Table 6: Calibration Verification Baseline MetricsStandard StateFitted Inductance (L)Fitted Capacitance (C)Fitted Resistance (R)StatusOpen Circuit (OC)$10.9\,\text{mH}$$13.0\,\text{fF}$$27.0\,\text{k}\Omega$VerifiedShort Circuit (SC)$-54.0\,\text{pH}$$91.0\,\text{F}$$254.0\,\mu\Omega$VerifiedStrategic Recommendations and Corporate ConclusionsThe technical investigation into the anomalous impedance spectroscopy data collected via the Keysight E4990A establishes that the observed behaviors are predictable results of instrument limitations under specific configurations. The negative equivalent series inductance ($\text{ESL}$) at lower frequencies, extreme capacitance inflation near resonance, and negative capacitance at high frequencies are the direct mathematical results of forcing a three-element series $R-L-C$ network into standard, single-frequency two-element calculations.Similarly, the negative $\text{ESR}$ values measured on the short-circuit copper plate standard are identified as systemic artifacts arising from phase calibration errors near the highly reactive $+90^\circ$ vector boundary and contact resistance overcorrection during short calibration.To eliminate these systematic measurement errors and ensure reliable component evaluation, the quality assurance and engineering divisions should implement the following recommendations:Decommission Single-Frequency Spot Inspections: Standardize on continuous multi-frequency sweeps for all capacitor qualifications. Single-frequency spot parameters should be utilized only for quick sorting and basic incoming inspections below $100\text{ kHz}$.Enforce Equivalent Circuit Analysis as the Primary Standard: Require the use of the E4990A's built-in equivalent circuit regression models (specifically Model A or Model B) for component characterization. The extracted, decoupled, frequency-independent values for core capacitance ($C$), loop inductance ($L$), and resistive loss ($R$) must be established as the formal metrics in qualification records.Establish a Formal Calibration and Verification Regimen: Require that every measurement sweep above $3\text{ MHz}$ utilize a comprehensive Open/Short/Load calibration protocol. Short calibration standards must have polished, low-resistance surfaces, and contact jaws must be regularly cleaned to prevent contact resistance variations.Implement Environmental Controls: Stabilize instrument thermal performance by enforcing a strict 90-minute warm-up period  and operating exclusively within temperature-controlled environments ($23\text{ }^\circ\text{C} \pm 5\text{ }^\circ\text{C}$) to minimize phase drift in the active bridge circuitry.
