Gmj080305/Tdk/switches research/ai review.md

Advanced Solid-State Architectures for Pulsed Discharge: A Comparative Technical Analysis

1. The Strategic Paradigm Shift in Pulsed Power Engineering

The field of pulsed power engineering is witnessing a definitive industrial and academic transition from traditional vacuum-tube technologies, such as thyratrons and ignitrons, toward advanced solid-state semiconductor solutions. For decades, thyratrons were the only viable option for high-voltage, fast-switching applications; however, they impose significant operational burdens, including complex triggering requirements, high procurement costs, and the necessity for periodic maintenance. From a strategic perspective, the shift to solid-state architectures is driven by a requirement for superior reliability, environmental sustainability—specifically the elimination of mercury found in ignitrons—and drastically improved system longevity. As a Principal Architect, my focus is on the Total Cost of Ownership (TCO); while semiconductor systems may involve higher initial capital expenditure, the reduction in downtime and the elimination of gas depletion issues offer a far superior long-term ROI.

The following table contrasts these technological paradigms as applied to modern high-power discharge systems:

Conventional vs. Solid-State Switching

Parameter	Conventional (Thyratron/Ignitron/Spark-Gap)	Solid-State (Semiconductor Switches)
Maintenance Requirements	Frequent; requires complex biasing and gas monitoring	Minimal to none
Operational Lifetime	Limited by electrode wear or gas depletion	Extremely long; defined by thermal cycling limits
Environmental Impact	High (Mercury, hazardous gases, ozone)	Low (Environmentally friendly, RoHS compliant)
Mounting Flexibility	Often restricted to vertical/orientation-dependent	Highly flexible; vibration resistant
Reliability	Variable; prone to misfiring or spontaneous breakdown	High precision; deterministic behavior

The successful adoption of these solid-state solutions is not merely a matter of component swapping. Achieving operational reliability requires "in-depth know-how" regarding both the specific application circuit and the device's unique behavior under pulsed stress. Characterizing the semiconductor's response to high-energy discharge is the prerequisite for designing the sophisticated architectures that enable these results.

2. Taxonomy and Performance Metrics of High-Power Semiconductors

High-power semiconductors for pulsed applications are primarily classified into turn-on and turn-off devices. While Gate Turn-Off (GTO) thyristors and Integrated Gate-Bipolar Transistors (IGBTs) offer controllable turn-off, thyristor technology remains the gold standard for high-energy capacitor discharge. This is due to their unmatched peak current handling and robust "switch-on-only" physics, which aligns with the complete discharge requirements of magnetic forming and kicker magnets.

Overview of Semiconductor Device Technologies

Device Type	Max Forward Blocking Voltage	Max Peak Pulse Current	di/dt Capability	Switch-on/off Capability
Thyristor	≤ 8500 V	120 kA	1.5 kA/µs	Switch-on only
GTO-like Thyristor	4500 V	150 kA	50 kA/µs	Switch-on only
IGCT	≤ 6000 V	4 kA	2 kA/µs	Switch-on/off
IGBT (Wire bonded)	≤ 6500 V	1 kA	5 kA/µs	Switch-on/off

For high-speed applications requiring extreme current rise rates (di/dt), GTO-like structures are the preferred choice. These devices utilize highly interdigitated gate structures to maximize the active conduction area during the initial turn-on phase, preventing localized current crowding.

Comparative Metrics: Standard Thyristor vs. GTO-like Structures

* Wafer Size: Standard thyristors scale up to 120 mm to maximize energy handling, whereas GTO-like structures typically utilize 91 mm wafers to maintain gate control precision.
* Current Rise Rates: Standard thyristors are limited to < 1 kA/µs. GTO-like structures, through their interdigitated design, comfortably handle up to 50 kA/µs.
* Driver Requirements: Standard thyristors often rely on external, separate drivers. GTO-like structures frequently employ integrated driver units that minimize the inductive path, which is critical for achieving these high di/dt thresholds.

While these individual components are robust, maximizing their performance requires the deployment of advanced triggering methods capable of pushing COTS hardware into sub-nanosecond regimes.

3. Advanced Triggering Mechanisms: The Impact-Ionization Frontier

The "Impact-Ionization" (or shock-ionization) wave mode represents the technical frontier of high-speed solid-state switching. This mode allows architects to achieve sub-nanosecond switching speeds using Commercially Available Off-The-Shelf (COTS) components—effectively matching the performance of specialized vacuum-tube technology.

The physics of this mode centers on the initiation of an ionization front. To transition a semiconductor into this state, the triggering circuit must deliver a voltage pulse that exceeds twice the static breakdown voltage of the device, coupled with a slew rate exceeding 1 kV/ns. Under these extreme conditions, charge carriers are accelerated so rapidly that they generate electron-hole pairs throughout the crystal lattice in a cascading wavefront. This front propagates faster than the carrier drift velocity itself, allowing the device to conduct almost instantaneously.

This impact-wave approach is strategically superior to traditional opening switches, such as Drift Step Recovery Diodes (DSRDs) or Semiconductor Opening Switches (SOS):

* Availability: SOS/DSRD components suffer from limited commercial availability and specialized manufacturing.
* Latency: Traditional opening switches require "pumping" phases of several hundred nanoseconds. The impact-wave method eliminates these pre-charging delays, enabling immediate response times.
* System Efficiency: By utilizing the inherent physics of standard thyristors, the impact-wave approach avoids the complexity and bulk of plasma-generation based architectures.

To generate the high-slew-rate pulses required for this mode, modern designs utilize high-performance Wide-Bandgap (WBG) driver stages.

4. Component Spotlight: Isolated Gate Drivers and SiC Integration

Silicon Carbide (SiC) MOSFETs have become the foundational elements of high-speed pulsed power, providing the fast edge transitions required to initiate impact ionization. However, driving SiC at these power levels requires sophisticated isolation and protection to prevent catastrophic failure.

The ADuM4177 Isolated Gate Driver is specifically designed for these demanding SiC configurations. It provides 5.7 kV RMS galvanic isolation through monolithic transformer technology, addressing the high dU/dt immunity requirements of modern traction and pulse inverters.

Primary Protection and Capabilities:

* High Drive Strength: 40 A source and 30 A sink peak drive output to overcome SiC gate capacitance rapidly.
* Software-Defined Hardware: Unlike fixed-logic drivers, the ADuM4177 features SPI programmability. This allows for user-programmable operating modes, adjustable slew-rate control, and fault readback, providing the precision necessary for high-energy research environments.
* Integrated Protection: Features DESAT protection (7 V threshold), an external Miller Clamp to prevent parasitic turn-on, and comprehensive OVP/UVP for the secondary side supply rails.

The combination of high-speed CMOS and monolithic transformers ensures the driver can deliver the sub-nanosecond precision required to feed more complex amplification stages, such as the Marx generator.

5. Architectural Deep Dive: The 4-Stage Marx Generator

Solid-state Marx generators have evolved from bulky spark-gap designs into compact PCB-integrated systems using D2PAK thyristors. This evolution allows for high-voltage pulse generation in a remarkably small footprint. To manage the pulse sharpening required for impact ionization, we utilize Impedance Grading to minimize reflections and maintain current continuity.

Summary of Impedance Grading (4-Stage Marx)

Stage	Width (mm)	Length (mm)	Calculated Impedance (Ω)	Delay (ps)
SiC MOSFET Trace	10	120	3.5	780
First Marx Stage	30	60	7	125
Second Marx Stage	20	60	14	226
Third Marx Stage	13	60	24.5	345
Fourth Marx Stage	13	60	24.5	345

The strategic logic here is twofold. First, we intentionally introduce an impedance mismatch at the output of the SiC MOSFET stage to generate a positive reflection. This doubles the voltage available to trigger the first thyristor into impact-ionization mode. Second, we employ impedance grading in the subsequent stages to prevent further reflections and high-voltage spikes that would exceed the 1.2 kV rating of the D2PAK components.

Dielectric Analysis and Cost Optimization: In designing these high-speed boards, a critical architectural decision was the choice of dielectric material. We compared standard FR4 to high-frequency RO4350B. The results showed no significant rise-time improvement for this application (680 ps for FR4 vs. 768 ps for RO4350B). Consequently, FR4 was selected as the superior choice from a TCO perspective, providing the required bandwidth without the added cost of specialized high-frequency laminates. To manage the arcing risks associated with 11 kV amplitudes, we utilized capacitive sensor plates—integrated non-contact probes in the PCB layers—to maintain measurement safety without degrading signal integrity.

6. Case Studies in High-Energy Discharge Systems

Practical deployment in multi-megajoule systems validates the theoretical performance of modern solid-state architectures across diverse industrial scales.

1. 21 kV / 210 kA Reverse Conducting Switch: Developed for magnetic forming, this system employs 24 reverse-conducting 91 mm devices (N_s=8, N_p=3). Strategically, the architect chose to use 3 independent stacks in parallel rather than a single "hard parallel" connection. This modularity allows the system to operate a single stack for lower-power tasks and ensures better current sharing and redundancy. For low repetition rates (1 shot/min), air convection cooling is utilized.
2. 10 kV / 50 kJ Multichip Module (ISL Saint-Louis): This project achieved a 62% reduction in system size over a decade. This was realized by moving from discrete 26 mm thick devices (total height 106 mm) to a multichip housing. By integrating four 91 mm wafers into a single unit and optimizing copper pole pieces, the total height was reduced to 54 mm, drastically increasing energy density.
3. 15 kV / 260 kA Switch (200 MJ Rail Gun System): This application utilizes 120 mm thyristor wafers to manage a massive 113 MA²s action. Reliability here is managed through extreme mechanical constraints: the thyristors are assembled with 135 kN clamps on a 100 mm glass fiber epoxy base. Active powering of driver units via HV closed-loop cables is used to ensure simultaneous triggering of all 15 thyristors.

These cases illustrate that while air cooling suffices for low frequencies, water cooling becomes the architect’s preference for high-repetition rates to maintain a compact modular footprint.

7. Strategic Conclusions and Future Outlook

Solid-state switching technology is now the established "state of the art," providing a robust alternative to obsolete vacuum tubes in both high-energy physics and industrial forming. The economic argument is clear: the higher initial cost of solid-state switches is strategically offset by the elimination of periodic maintenance, increased reliability, and extreme temporal precision, leading to a lower Total Cost of Ownership.

The integration of COTS components and novel triggering modes, specifically impact-ionization, provides a viable roadmap for the future of pulsed power. By utilizing standard SiC MOSFETs and D2PAK thyristors in Marx configurations, we can achieve sub-nanosecond rise times for the next generation of particle accelerators. Continued collaboration between system designers and device manufacturers is essential to ensure that semiconductors are properly characterized for the unique, extreme stresses of pulsed-discharge environments.
