Gmj080305/Tdk/Gaurang_Joshi_TDK_Report.pdf

## ESL MEASUREMENT AND SWITCHING TECHNOLOGY ALTERNATIVES

### A PROJECT REPORT

SUBMITTED IN FULFILLMENT OF

## Summer Internship

AT

## TDK Electronics

Submitted by:

### Gaurang Mangesh Joshi

Under the Supervision of

### Kartik Sir

DC R&D

TDK Electronics

Nashik

MAY-JUNE, 2026

### ABSTRACT

The following report covers 2 projects: ESL Measurement & Switching Technologies and their progress during my 6 week summer internship.

Project 1 explains how the ’low voltage surge discharge method’ can be used to get accurate readings for 2 terminal capacitors and a proof of concept for how this method can be used for 4 terminal capacitors as well. The aim is to provide a reliable alternative to the Keysight Impedance Analyzer for lab testing of the ESL of film capacitors. Project 2 provides a literature review of available switching technologies available in the industry and shows why SiC MOSFET can be used as an alternative for mercury switches in capacitor charge-discharge circuit.

Keywords: ESL Measurement, SiC MOSFET.

i

### ACKNOWLEDGEMENT

I express my sincere gratitude to Kartik Sir, Pankaj Sir and Nilesh Sir for their invaluable guidance, constant encouragement, and insightful suggestions throughout these projects.

I am thankful to all DC R&D members for providing the necessary infrastructure and computa-tional resources and helping me complete my project.

Gaurang Mangesh Joshi

ii

# Contents

Abstract | i
Acknowledgement | ii
List of Figures | v
List of Tables | vi
List of Symbols, Abbreviations and Nomenclature | vii
1 Introduction | 1
2 Literature Review | 4
2.2.4 | Time Domain Reflectometry / Transmission (TDR/TDT) Method . . . | 11
3 Methodology | 14

iii

DC R&D, TDK | ESL Measurement
4 Experimental Setup | 21
5 Results and Analysis | 31
6 Conclusion | 38

iv

# List of Figures

3.1 [Equivalent Circuit of a Film Capacitor] | | 14
3.2 [A typical capacitor discharge waveform] | | 15
4.1 [Equivalent test circuit] | | 21
4.2 [Equivalent test circuit voltage waveform] | | 22
4.3 [Equivalent test circuit current waveform] | | 22
4.4 [Realistic simulation circuit of SiC switch for capacitor charge-discharge] . . . | 23
4.5 [Adjustable variables list] | | 24
4.6 [MOSFET Gate Drive] | | 24
4.7 [Closer look at the circuit] | | 25
4.8 [SiC Voltage Waveform] | | 25
4.9 [SiC Current Waveform] | | 26
4.10 [Piano setup front view] | | 27
4.11 [Piano setup top view] | | 27
4.12 [Resolution problem faced when LC ≪ Lfixture] | | 28
4.13 [How a clean discharge waveform should be for accurate readings] | | 28
4.14 [Initial damping waveform] | | 29
4.15 [zoomed in damping waveform] | | 29
4.16 [A sample schematic for Copper H Bridge] | | 30
4.17 [Copper bridge fixture schematic] | | 30

v

# List of Tables

2.1 ABB Method – Inductance Uncertainty Budget | | 6
2.2 Voltage Surge Discharge – Inductance Uncertainty Budget | | 8
2.3 Error Analysis and Gauge R&R for Constant Pulse Method | | 10
2.4 TDR Method – Inductance Uncertainty Budget | | 11
2.5 Comparison Matrix | | 12
2.6 Comparative Technical Analysis of Switching Technologies for Capacitor Dis-
charge | | 13
3.1 Key parameters of the chosen SiC switch | | 17
5.1 Readings for B32922 sample 1 | | 31
5.2 Readings for B32922 sample 2 | | 32
5.3 Statistics for B32922 | | 32
5.4 Readings for R&D sample 1 | | 33
5.5 Readings for R&D sample 2 | | 34
5.6 Statistics | | 34
5.7 Readings for R&D sample 1 | | 35
5.8 Readings for R&D sample 2 | | 36
5.9 Statistics | | 36
5.10 Capacitor Discharge readings with copper plate | | 37

vi

### LIST OF SYMBOLS, ABBREVIATIONS AND NOMENCLATURE

LIST OF SYMBOLS, ABBREVIATIONS AND NOMENCLATURE

Abbreviations

ABB | Auto-Balanced Bridge
ANOVA | Analysis of Variance
AV | Appraiser Variance (Reproducibility)
CPW | Coplanar Waveguide
DAQ | Data Acquisition System
DC | Direct Current
DUT | Device Under Test
EMI | Electromagnetic Interference
ESL | Equivalent Series Inductance
ESR | Equivalent Series Resistance
EV | Equipment Variance (Repeatability)
GaN HEMT Gallium Nitride High-Electron-Mobility Transistor
IR | Insulation Resistance
MOSFET | Metal-Oxide-Semiconductor Field-Effect Transistor
MSE | Mean Squared Error
MWR | Mercury-Wetted Relay
OTA | Operational Transimpedance Amplifier
RoHS | Restriction of Hazardous Substances
SCOMET | Special Chemicals, Organisms, Materials, Equipment and Technologies
SCR | Silicon Controlled Rectifier (Thyristor)
SiC | Silicon Carbide
SRF | Self-Resonant Frequency
TDR | Time Domain Reflectometry
TDT | Time Domain Transmission
WBG | Wide-Bandgap Semiconductor

vii

Symbols & Nomenclature

Zx | Complex impedance vector of the DUT
Rs
/ R | Apparent series resistance / Equivalent series resistance
Xs | Apparent series reactance
ω | Angular frequency
Cs | Apparent series capacitance
C | True frequency-independent capacitance
Vx | Applied AC voltage stimulus
Ix | AC current flowing through the DUT
Vr | Balance voltage across the active range resistor
Rr | Range feedback resistor value
θ | Impedance phase angle

σ

2 | Variance parameters (Total, System, Part, Repeatability, Reproducibility)
i(t) | Transient discharge current as a function of time
L / Lloop / Lfixture | Inductance (True ESL / Loop inductance / Fixture parasitic)
α | Neper frequency (damping factor)
ω0 | Undamped natural resonant frequency
ωd | Damped natural resonant frequency
s1,2 | Characteristic roots of the governing series RLC equation
V0 / Vop | Pre-charge target capacitor voltage / Operating voltage
Td | Ringing waveform damped oscillation period
δ | Logarithmic decrement of peak transient currents
I1,I2 | Current values at consecutive positive peaks
VC / V1,V2 | Voltage across capacitor core / Transient peak voltage markers
∆V | Voltage step drop at pulse initiation (t → 0 +)
di/dt | Current derivative (ramp rate)
Γ(s) | Laplace-domain reflection coefficient
Z0 | Coaxial path characteristic impedance (typically 50Ω)
τ | Reflection exponential decay time constant
ρ(t) | Time-domain reflection coefficient function
σ | Statistical standard deviation

viii

### CHAPTER 1

### INTRODUCTION

### 1.1 General

In high-power electronic systems, characterizing the Equivalent Series Inductance (ESL) of DC-link and snubber film capacitors is critical for managing voltage overshoot during rapid semiconductor switching transitions. As modern power systems transition to Wide-Bandgap (WBG) semiconductors, these capacitors must operate with extremely low parasitic values, typically in the single-to-double-digit nanohenry (nH) range. The importance of precision in this regime cannot be overstated; as even a small error(in 10⁻⁹
range), is often enough to overshadow the internal ESL of the device under test (DUT) . Furthermore, SCOMET List by the Directorate General of Foreign Trade has strict limits on inductance of capacitors (10nH or 50nH).This highlights the importance of a reliable ESL measurement method.

The switch element used to initiate the discharge transient is central to achieving this measurement fidelity. The field of pulsed power engineering is undergoing a definitive strategic shift from traditional mechanical switching technologies toward advanced solid-state semiconductor solutions — a transition essential for modern high-precision film capacitor testing. This demand is further reinforced by the urgent requirement for environmental sustainability, specifically the global regulatory phase-out of mercury switches mandated by the Minamata Convention and RoHS compliance.

### 1.2 Background

Capacitor inductance measurement is inherently complex due to ultra-low target values. Industry standards such as IEC 61071 define self-inductance as a black-box parameter measured under specific terminal conditions. Traditionally, measurements are performed using an Auto-Balanced Bridge (ABB) method with high-precision impedance analyzers (e.g., Keysight E4990A). The Low-Voltage Surge Discharge Method is a time-domain technique that extracts ESL by measuring the underdamped ringing current waveform produced when a pre-charged capacitor discharges through a low-impedance switch as described in the TDK/EPCOS report.

Historically, the switching element in such discharge setups relied on mercury-wetted relays (MWRs) which currently face environmental restrictions.

### 1.3 Motivation

This project was motivated by the need to bridge the gap between high-precision time con-suming laboratory characterization and high-volume time efficient reliable setup. Existing surge-discharge setups are highly sensitive to topology; requring constant fixture calibration. A small change can prove fatal, leading to invalid data. The industry is simultaneously facing a mandatory transition away from MWRs due to Minamata Convention toxicity regulations, creating an urgent need to validate solid-state switching alternatives. Adopting SiC MOSFET technology directly addresses the dual problem of environmental toxicity and measurement accuracy, enabling reduction in switching jitter and system footprint.

### 1.4 Objectives of the Project

The specific objectives of this project are:

1. Validate and standardize the low-voltage surge-discharge method for film capacitor ESL measurement to ensure a repeatable, traceable workflow for high volume R&D testing.
2. Design a high-precision metrology fixture, such as a laminated H-bridge busbar for increasing accuracy of 4 terminal capacitors.
3. Evaluate, characterize and provide a proof of concept to integrate Silicon Carbide (SiC) MOSFET switching technology .
4. Integrate project 1 & project 2 as a unified ESL Measuring setup.

### 1.5 Organization of the Dissertation

The remainder of this report is structured as follows:

- Chapter 2 presents a comprehensive literature review of multiple ESL measurement techniques and a comparative analysis of conventional and wide-bandgap switching technologies.
- Chapter 3 describes the proposed methodology, detailing the mathematical frameworks for transient RLC analysis.
- Chapter 4 covers the experimental setup, focusing on charge-discharge setup and the mechanical design of the H-bridge fixture

- Chapter 5 presents results and analysis of tests across variety of capacitors and it’s cross-validation.
- Chapter 6 concludes the report with key findings,practical recommendations and future metrology improvements.

### CHAPTER 2

### LITERATURE REVIEW

### 2.1 Introduction

This chapter surveys the existing literature relevant to this project, covering: (1) Laboratory metrology standards for nanohenry-scale inductance characterization, (2) Legacy and high-speed switching technologies for transient capacitor discharge.

### 2.2 ESL Measurement Methods

### 2.2.1 Auto-Balanced Bridge (ABB) Method

Theoretical Foundation:

The Auto-Balanced Bridge (ABB) architecture is the primary instrumentation standard for high-precision impedance measurements from low frequencies up to approximately 120MHz. The working mechanism relies on maintaining a virtual ground potential at the low terminal of the Device Under Test (DUT), thereby neutralising the effect of parasitic impedances to ground and isolating the complex impedance vector of the film capacitor.

The complex impedance of a real metallized film capacitor is modelled by the series equivalent circuit:
Zx = R+ j
ωL−

1

ωC

(2.1)

In the ABB configuration, a known AC voltage stimulus Vx is applied to the High-Force (Hcur) terminal of the DUT. The resulting current Ix flows through the capacitor to the Low-Force (Lcur) terminal. An active Operational Transimpedance Amplifier (OTA) detects any current flow at the Lcur node and dynamically adjusts its output voltage Vr

through a known range-feedback resistor Rr

to force the potential at the Lcur terminal to exactly zero volts. The nodal current-balancing equation at the virtual ground is:

Ix +Ir = 0 =⇒

Vx
Zx

+

Vr
Rr
= 0 | (2.2)

Solving for the complex impedance vector Zx:

Zx = −Rr

·

Vx
Vr

(2.3)

Decomposing the voltage ratio into real and imaginary parts, Vx Vr

= A+ jB, and substituting:

Zx = −Rr(A+ jB) = Rs + jXs | (2.4)

where the apparent series resistance and reactance are:

Rs = −RrA | (2.5)
Xs = −RrB | (2.6)

At a single test frequency ω, a conventional instrument reports the apparent series capacitance Cs based on a simplified two-element capacitive model:

Cs = −

1

ωXs

=

1
ωRrB

(2.7)

However, near or above the self-resonant frequency (SRF), the inductive reactance counteracts the capacitive reactance, leading to a systematic overestimation of Cs

. To isolate the true
frequency-independent capacitance C and the nanohenry-range ESL (L), measurements must be performed at two distinct frequencies ω1 and ω2 within the capacitive regime:

Xs1 = ω1L−

1

ω1C

(2.8)

Xs2 = ω2L−

1

ω2C

(2.9)

Multiplying both equations by their respective angular frequencies:

ω1Xs1 = ω

2
1L−

1
C

(2.10)

ω2Xs2 = ω

2
2L−

1
C

(2.11)

Subtracting to eliminate the capacitive term yields the true ESL:

L =

ω1Xs1 −ω2Xs2

ω

2
1 −ω

2
2

(2.12)

Solving for the true capacitance C:

C =

ω

2
1 −ω

2
2
ω1ω

2/2 Xs1 −ω

2
1ω2Xs2

(2.13)

Analysis:

The phase angle at ω1:

θ = arctan
Xs
R

= arctan
−0.5321053

0.01501
≈ −88.384◦
(2.14)

If this angle tips over −90o due to errors the ABB method reports negative/incorrect values.

Table 2.1: ABB Method – Inductance Uncertainty Budget

Error Source | Distribution | Std. Uncertainty | Sensitivity Coeff. | L Contribution
Phase Detector Resolution | Rectangular | ±0.005◦ | 1.25×10⁻¹⁰ H
| | | ◦−1 | ±0.063nH
Residual Short Inductance | Normal (k = 1) | ±0.150nH | 1.00 | ±0.150nH
Range Resistor Drift | Triangular | ±10ppm/
| | ◦C | 4.20×10⁻¹¹ H/ppm | ±0.042nH
Guard-Loop Leakage | Rectangular | ±0.05µA | 1.80×10⁻⁴ HA⁻¹ | ±0.009nH
Combined Uc | Normal (k = 1) | — | — | ±0.168nH

Formal Gauge R&R Framework:

The measurement system variance is modelled using ANOVA decomposition:

σ

2
total = σ

2
part +σ

2
system = σ

2
part +σ

2
repeatability +σ

2
reproducibility | (2.15)

Repeatability (Equipment Variance, EV):

EV = 5.15 ·

√
MSE | (2.16)

Reproducibility (Appraiser Variance, AV):

AV =

r

5.15 ·σoperator2 −

EV²
n ·r

(2.17)

### 2.2.2 Voltage Surge Discharge Method

Theoretical foundation:

The Voltage Surge Discharge Method is an active time-domain technique used to isolate ESL and ESR from the underdamped ringing current produced when a pre-charged capacitor discharges through a low-impedance switch. The discharge loop is modelled as a series RLC circuit governed by:

L

d

2
i(t)
dt²

+R

di(t)
dt

+

1
C
i(t) = 0 | (2.18)

Dividing by L:
d

2
i(t)
dt²

+

R
L

di(t)
dt

+

1
LC
i(t) = 0 | (2.19)

The characteristic roots are:

s1,2 = −α ±

q
α² −ω

2
0 | (2.20)

where:

α =

R
2L
(Neper frequency) | (2.21)

ω0 =

1
√
LC
(undamped resonant frequency) | (2.22)

For the underdamped condition (α < ω0), the damped resonant frequency is:

ωd =

q
ω

2
0 −α² =

s
1
LC

−

R
2L

2
(2.23)

With initial conditions q(0) = CV0 and i(0) = 0:

i(t) = V0

ωdL

e

−αt
sin(ωdt) | (2.24)

The damped period is measured from consecutive zero-crossings:

Td =

2π

ωd

=⇒ ωd =

2π
Td

(2.25)

The logarithmic decrement from two consecutive positive peaks I1, I2:

δ = ln
I1
I2
= αTd =⇒ α =

δ
Td

(2.26)

Then:

ω0 =

q
ω

2
d +α²
(2.27)

Lloop =

1

ω

2
0C

(2.28)

LC =

V1Lloop
VC

(2.29)

Analysis:

At very low values of ESL, V1 < < Vc making it susceptible to setup noise and measurement errors

Table 2.2: Voltage Surge Discharge – Inductance Uncertainty Budget

Error Source | Distribution | Std. Uncertainty | Sensitivity Coeff. | L Contribution
Digitizer Sampling Jitter | Rectangular | ±500ps | 3.16×10⁻² nHns⁻¹ | ±0.016nH
Switch Dynamic Resistance | Normal (k = 2) | ±0.80mΩ | 1.50×10⁻⁹ HΩ⁻¹ | ±0.120nH
Dummy Block Calibration Error | Triangular | ±0.05nH | 1.00 | ±0.035nH
Coaxial Shunt Thermal Drift | Normal (k = 1) | ±0.2% | 4.18×10⁻² nH%⁻¹ | ±0.084nH
Combined Uc | Normal (k = 1) | — | — | ±0.151nH

### 2.2.3 Constant Current Pulse(di/dt) Method

Theoretical foundation:

The terminal voltage of a capacitor under dynamic current is governed by:

V(t) = L

di
dt

+i ·RESR +

1
C

Z
i dt | (2.30)

Term Analysis at t → 0

+

1. Capacitance Term
1
C

R

i dt
: Pulse width < 2µs ⇒ negligible charge accumulation

⇒≈ 0

2. ESR Term (i·RESR): At ramp onset, i ≈ 0 ⇒ negligible
3. ESL Term
L

di

dt
:

di
dt

is massive ⇒ dominates

Equation simplifies to:

V(t)

t→0⁺ ≈ LESL

di
dt

(2.31)

Waveform Behavior:

For a linear current ramp:

i(t) = t

di(t)
dt

(2.32)

The voltage response exhibits:

- An instantaneous vertical jump ∆V at t = 0

+ (ESL-dominated)

- A slower linear slope for t > 0 (capacitor charging)
- By measuring the immediate vertical jump (∆V) and knowing the pre-set di/dt, the system

calculates the ESL in real time

ESL Extraction

LESL =

∆V
di
dt | (2.33)

Analysis:

Table 2.3: Error Analysis and Gauge R&R for Constant Pulse Method

Category | Parameter | Impact on Measurement Accuracy & Precision
Error Analysis | Transient Signal Detection (∆V) | Identifying the exact vertical jump (∆V) at t → 0 is critical.
| di/dt Linearity | Fluctuations in the current ramp—prevented by precision air-core inductors—introduce direct errors into the ESL = ∆V/(di/dt) calculation.
| Sampling Resolution | DAQ sampling at < 100 MS/s may miss the peak derivative.
Repeatability (Equipment) | Signal-to-Noise Ratio (SNR) | A 100 A pulse creates a massive, clean, multi-volt jump (∆V) immune to fac-tory EMI, ensuring consistent results.
| Switching Consistency | SiC MOSFETs provide incredibly sharp and repeatable nanosecond turn-on times.
| Mechanical Rigidity | Rigid pneumatic copper jaws main-tain identical geometry for every cycle, keeping fixture inductance (Lfixture) as a fixed constant.
Reproducibility | Kelvin Contact Jig | Pneumatic actuators ensure sensing probes touch terminals at the absolute closest point, removing risks of man-ual placement errors.
| System Calibration | Reproducibility across lines is main-tained via “golden-master” calibration to subtract the specific fixture constant of each machine.

### 2.2.4 Time Domain Reflectometry / Transmission (TDR/TDT) Method

Theoretical foundation:

TDR injects an ultra-fast voltage step into a 50 Ω coaxial path shunt-loaded by the DUT. The Laplace-domain reflection coefficient, assuming R ≪ Z0:

Γ(s) ≈

sL−Z0
sL+Z0

(2.34)

For a unit-step input Vinc(s) = V0 s

, the inverse Laplace transform yields:

vmeas(t) = 2V0 e

−

Z0
L

t
- u(t) | (2.35)

The inductance is extracted from the exponential time constant τ:

τ =

L
Z0
=⇒ L = Z0 · τ | (2.36)

For non-ideal (finite rise-time) step excitation, the integration method is used:

L = 2Z0

Z t2

t1

ρ(t)dt | (2.37)

Analysis:

Table 2.4: TDR Method – Inductance Uncertainty Budget

Error Source | Distribution | Std. Uncertainty | Sensitivity Coeff. | L Contribution
Oscilloscope Timing Jitter | Normal (k = 1) | ±500fs | 1.20×10⁻¹ nHps⁻¹ | ±0.060nH
Step Amplitude Fluctuations | Normal (k = 2) | ±0.50% | 4.20×10⁻² nH%⁻¹ | ±0.011nH
CPW Z0 Machining Tolerance | Rectangular | ±0.25Ω | 4.20×10⁻¹⁰ HΩ⁻¹ | ±0.105nH
Time Gating Window Drift | Triangular | ±2.0ps | 5.00×10⁻² nHps⁻¹ | ±0.100nH
Combined Uc | Normal (k = 1) | — | — | ±0.158nH

Table 2.5: Comparison Matrix

Method | Error distribution | Lfixture | ∆L | Rank
ABB | Normal(k=1) | YES | ±0.168nH | 3
TDR/TDT | Normal(k=1) | YES | ±0.158nH | 2
Constant di/dt Normal(k=1) | YES | ±0.167nH | 4
Proposed | Normal(k=1) | NO | ±0.151nH | 1

### 2.3 Switching Technologies

### 2.3.1 Thyristor:

Thyristors can block up to 8.5 kV and handle 120 kA. However, literature identifies them as "switch-on only" devices limited by a low current rise rate (di/dt) of less than 1.5 kA/µs and slow transition speeds.

### 2.3.2 Mercury-Wetted Relay (MWR):

Long prized for "bounce-free" picosecond contact closure, MWRs are now categorized as a "laboratory liability".Mechanical jitter and orientation sensitivity make them inherently unstable for automated production environments.

### 2.3.3 GaN eHEMT:

GaN offers unmatched package inductance (<1 nH) and sub-2 ns edges. However, GaN is practically limited by a severe voltage bottleneck (typically <600 V).

### 2.3.4 SiC MOSFET:

Successfully bridges the gap between high voltage (>1.2 kV) and nanosecond transition speeds. Using an optimized gate-boosting technique with GaN driver switches, SiC turn-on times are violently slashed to below 2 ns.

### 2.3.5 Spark Gap:

While capable of handling extreme voltages (>10 kV), spark gaps suffer from plasma-channel drift and stochastic misfiring. Literature highlights their poor repeatability (Gauge R&R) and the requirement for frequent maintenance due to electrode erosion.

### 2.3.6 Avalanche Transistor:

These provide fast 300–600 ps edges but are limited to very low voltages (<100 V) and exhibit high device-to-device variability.

Table 2.6: Comparative Technical Analysis of Switching Technologies for Capacitor Discharge

Technology | Transition Speed Max Voltage di/dt Capability Repeatability
Thyristor (SCR) | > 1000 ns | ≤ 8.5 kV | < 1.5 kA/µs | Poor
Mercury Relay (MWR) | 1–5 ns | > 1 kV | High (Jittery) | Poor–Fair
GaN eHEMT | < 2 ns | < 600 V | Ultra-High | Excellent
SiC MOSFET (Boosted) | 2–10 ns | > 1.2 kV | 38.7 kA/µs | Excellent
Spark Gap | 1–10 ns | > 10 kV | High (Drifting) | Poor
Avalanche Transistor | 300–600 ps | < 100 V | Moderate | Variable

### 2.4 Gap Analysis

The literature review reveals the following gaps that this project addresses:

1. Gap 1: Most methods need fixture compensation/calibration.
2. Gap 2: Switch alternative due to regulatory Phase-out of Mercury Switches.
3. Gap 3: Method is (2,4) terminal capacitor inclusive.

### CHAPTER 3

### METHODOLOGY

### 3.1 ESL Measurement

A film capacitor can be modeled as follows: 3.1

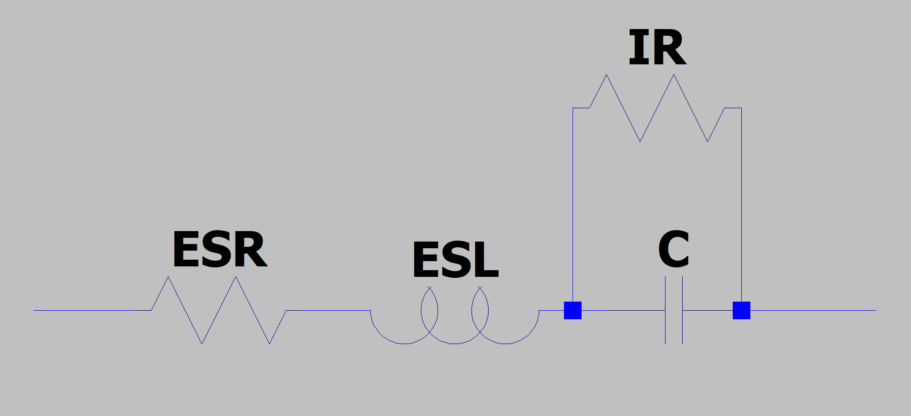
[picture p2: figure]

Figure 3.1: [Equivalent Circuit of a Film Capacitor]

where,

ESR stands for effective series resistance

ESL stands for effective serires inductance

IR stands for Insulation resistance

Since, IR is very high (>2G Ohm to pass IR test), we treat the capacitor as a series RLC circuit. Thus the voltage drop across the circuit is,

V = ESR.i+ESL

di
dt

+

1
C

Z
i.dt | (3.1)

Since it is a fast discharge, only inductance reacts instantaneously due to the di/dt term, while other elements follow a little later.Thus, finding ∆V at t ⇒ 0

+ gives the voltage drop due to

inductance only.

This method relies on analysis of discharge waveforms of a capacitor under test. An example waveform is shown below in Figure 3.2.

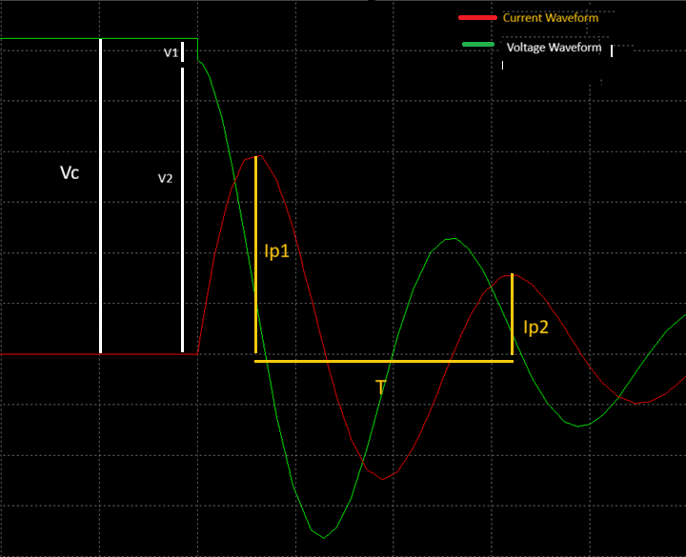
[picture p3: figure]

Figure 3.2: [A typical capacitor discharge waveform]

STEP 1: Damping Coefficient

e

αT =

I p1
I p2

(3.2)

α =

1
T

ln I p1
I p2

(3.3)

also

α =

R
2L

(3.4)

STEP 2: Resonance & Natural Frequencies

ωr =

2π
T

(3.5)

ω◦ =

q
ω²

r +α²
(3.6)
STEP 3: Loop Inductance

ω◦ =

1
√
LC

(3.7)

L =

1
ω²
◦C

(3.8)

STEP 4: Capacitor Inductance V1
VC

=

LC
L

(3.9)

LC = L

V1
VC

(3.10)

Direct Formula:

LC =

V1
VC

1
C

T

2
(4π

2 +ln² I p1
I p2

)

(3.11)

### 3.2 SiC Switch

### 3.2.1 Device Selection and Characterization

The Wolfspeed CAB450M12XM3 is a 1200 V, 450 A SiC MOSFET half-bridge power module. In this work, only the low-side switch of the half-bridge is utilized as the discharge trigger, with the high-side device left unpopulated or held off. Key device parameters governing switching performance are the gate threshold voltage VGS(th), gate charge Qg, and the internal gate resistance Rg(int). The total gate loop time constant is:

τg = (Rg(ext) +Rg(int))Ciss | (3.12)

where Ciss is the input capacitance and Rg(ext) is the externally programmable gate resistance.

Minimizing τg is the primary design lever for achieving fast turn-on and high di/dt at the load. The on-state current rise rate during discharge is governed by the circuit loop inductance Lloop and the DC-link voltage VDC:
di dt
=
VDC Lloop | (3.13)

### 3.2.2 Low-Inductance Power Loop Design

The power discharge loop — comprising the capacitor bank, busbar, SiC module, and return path — is designed as a laminated coplanar pair to minimize enclosed loop area. The parasitic inductance of a rectangular loop is estimated as:

LLoop =

µ◦

π

.l.ln 2h
w

(3.14)

where l is the length of the loop, h is the separation of the conductor, and w is the width of the conductor. Laminating the forward and return conductors with a thin dielectric spacer (h ⇒ minimum) is the primary technique to drive Lloop extremely low.

### 3.2.3 CAB450M12XM3 Datasheet

Table 3.1: Key parameters of the chosen SiC switch

Parameter | Symbol | min/typ/max
Drain-Source Voltage | VDS | – / – / 1200 V
Operational Gate-Source Voltage | VGS | -8 / (-4/+15) / +19 V
DC Continuous Drain Current | ID | – / 438 / 450 A
Pulsed Drain Current | IDM | – / 900 / – A
Power Dissipation | PD | – / 1670 / – W
Operational Virtual Junction Temperature | TV Jop | -40 / +25 / +175 ◦C
Reverse Recovery Time | tRR | – / 78 / – ns
Reverse Recovery Charge | QRR | – / 7.2 / – uC
Peak Reverse Recovery Current | IRRM | – / 169 / – A

### 3.3 Copper H-Brigde

### 3.3.1 Design Rationale

The central challenge in surge-discharge ESL measurement is ensuring that the fixture’s own parasitic inductance does not dominate the measurement. Standard clip-lead or coaxial fixtures routinely introduce stray inductances of 10–50 nH, which completely mask the single-digit nanohenry ESL of modern DC-link film capacitors. The metrology fixture designed in this work adopts a laminated H-bridge copper busbar geometry, in which the forward and return current paths are forced into extreme proximity. Since stray inductance scales directly with enclosed loop area, minimizing this area is the primary electromagnetic design objective:

Lstray ∝ Aloop | (3.15)

The H-bridge configuration additionally enforces precise Kelvin contact placement and accom-modates the DUT, DC supply, and SiC switch within a single low-inductance current loop.

### 3.3.2 Loop Inductance Minimization (Lloop)

The total parasitic loop inductance (Lloop) of a laminated two-plate assembly carrying equal and opposite currents is defined by the self-inductances (L1,L2) of the top and bottom plates and the mutual inductance (M) between them:

Lloop = L1 +L2 −2M | (3.16)

While extracting exact closed-form expressions for L and M for finite plates is complex due to fringing fields, the loop inductance can be derived exactly from first principles. Assuming the plates are wide (w ≫ d), the magnetic field between the plates is uniform. By Ampere’s Law,

the magnetic flux density B in the dielectric gap is:

B =

µ0µrI w | (3.17)

The total magnetic flux Φ linking the loop formed by the two plates over a length l and a dielectric separation d is the product of the flux density and the cross-sectional area of the gap (A = l · d):

Φ = B·A =

µ0µrI
w
(l · d) | (3.18)

Since inductance is defined as flux linkage per unit current (L = Φ/I), the equation simplifies to

the standard parallel-plate transmission line inductance:

Lloop =

µ0µr

·l · d w | (3.19)

Conclusion: This proof confirms that loop inductance is governed entirely by the geometric ratio of l/w and the dielectric gap d. By utilizing an ultra-thin dielectric (e.g., 2 mil or 0.050 mm

Kapton) and maximizing width w, the fixture’s parasitic inductance is mathematically forced into the sub-nanohenry regime.

### 3.3.3 Equivalent Inductance of Coupled Terminals (Leq)

In multi-terminal capacitors, same-polarity pins run in parallel and share a magnetic boundary. When two parallel conductors are magnetically coupled, their voltage-current relationships are:

v = L1

di1 dt
+M
di2 dt | (3.20)

v = M

di1
dt

+L2

di2
dt

(3.21)

Because the pins are connected in parallel, the total current is i = i1 +i2, and the voltage v across both branches is equal. Solving this system for the equivalent inductance (Leq = v/

di
dt) yields the
general coupled parallel inductance formula:

Leq =

L1L2 −M²
L1 +L2 −2M

(3.22)

For symmetrical capacitor terminals, L1 = L2 = Lpin. Substituting this into the general formula allows us to factor and simplify:

Leq =

L

2

pin −M²

2Lpin −2M

=

(Lpin −M)(Lpin +M)
2(Lpin −M)

(3.23)

Leq =

Lpin +M
2

(3.24)

Impact of Mutual Coupling:

Ideal uncoupled state (M → 0): Leq = Lpin/2. This is the naive assumption, yielding a perfect

50% reduction in inductance.

Tightly coupled state (M → Lpin): Leq → Lpin. Paralleling the pins provides negligible reduction

because shared magnetic flux dominates.

To correct this, the H-bridge plates act as a magnetic mirror. The opposing differential currents in the laminated plates generate a strong opposing magnetic field that induces eddy currents in the surrounding conductive environment. This produces an opposing flux (Φind) that cancels the mutual flux linking the pins:

ΦM,e f f ective = ΦM −Φind ⇒ Me f f ective → 0 | (3.25)

By forcing M → 0, the laminated fixture restores the theoretical factor-of-two inductance re-

duction, preventing the systematic overestimation of DUT ESL that occurs in standard open fixtures.

### 3.3.4 Vector Orthogonality and Flux Decoupling

To prevent the H-bridge plates from also suppressing the pins’ own self-inductance (Lpin) via the same eddy-current mechanism—which would falsely lower the measured ESL—the fixture enforces a 90◦
spatial rotation between the current paths.We can define the current density vectors mathematically. The pin current flows vertically along the z-axis, while the plate current flows horizontally in the xy-plane:
Jpin = Jz
ˆk | (3.26)

Jplate = Jx

ˆi+Jy

ˆj | (3.27)

The dot product of these two current densities is strictly zero:

Jpin · Jplate = 0

Because the currents are orthogonal, the magnetic fields they generate are also orthogonal to each other’s primary flux linkage loops. The magnetic flux circulating around the pins is parallel to the flat surfaces of the busbar plates. Consequently, the pins’ self-generated flux does not enter the inter-plate volume, preventing orthogonal flux compression. This orthogonality guarantees that only inter-pin mutual coupling (M) is cancelled, fully preserving the self-inductance contribution of the capacitor under test.

### CHAPTER 4

### EXPERIMENTAL SETUP

### 4.1 ESL Setup Circuit

The test circuit including the loop resistance and loop inductance, a switch is shown in Figure 4.1.

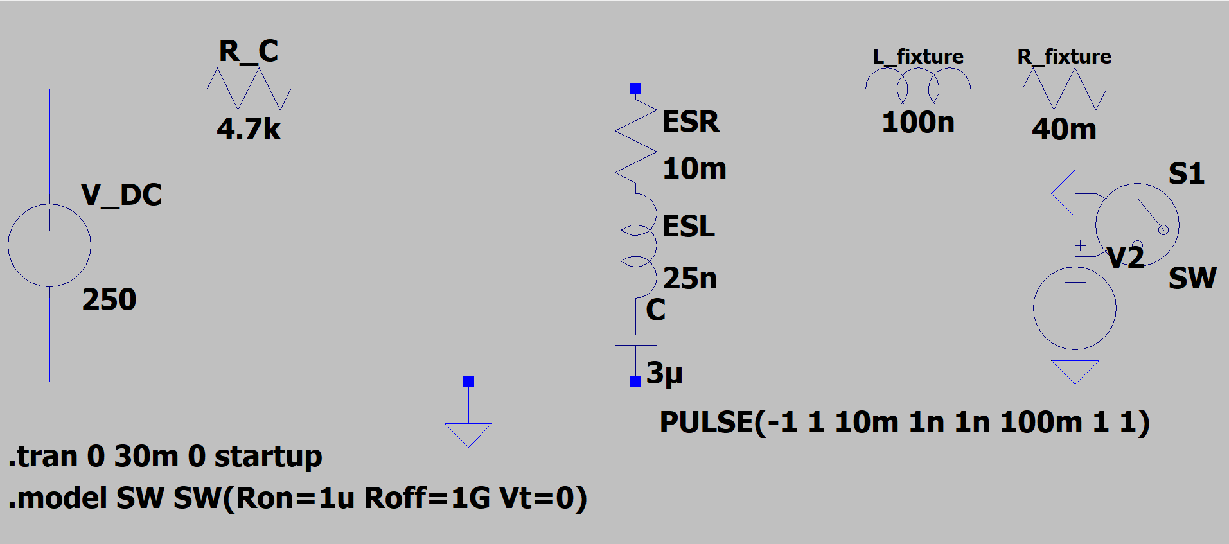
[picture p4: figure]

Figure 4.1: [Equivalent test circuit]

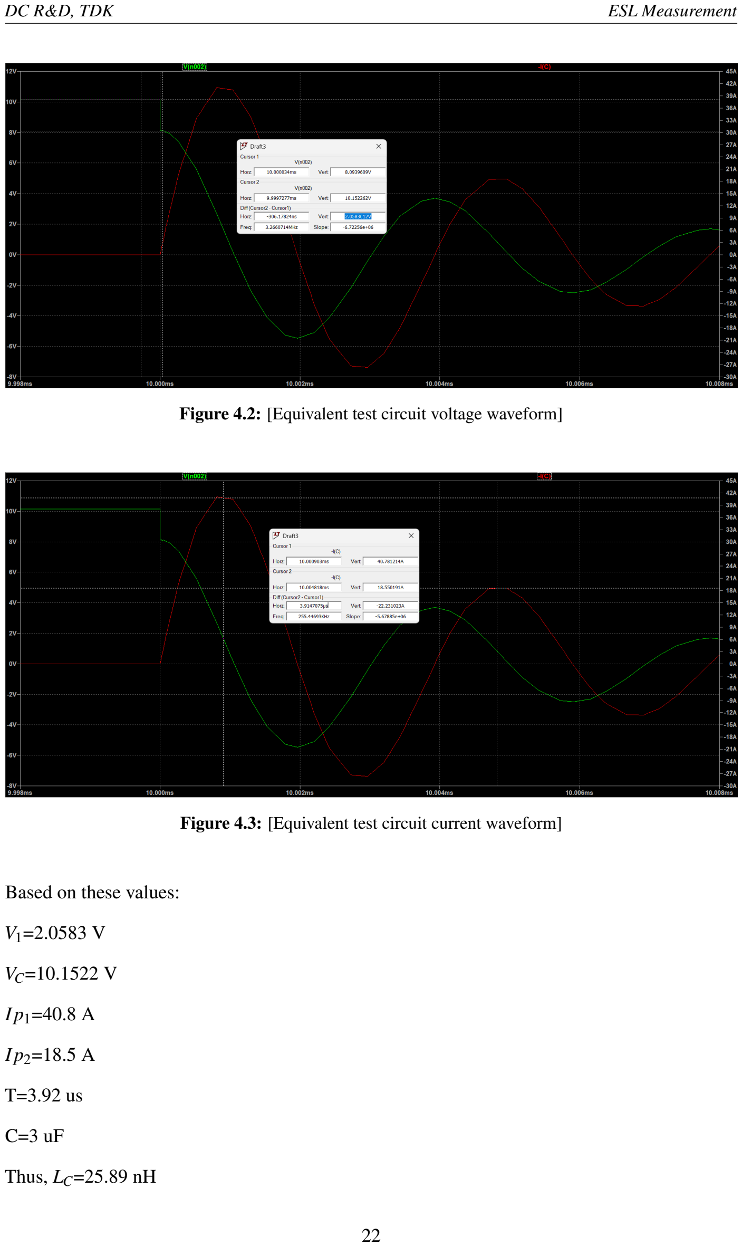
[picture p5: page 31]

Figure 4.2: [Equivalent test circuit voltage waveform]

Figure 4.3: [Equivalent test circuit current waveform]

Based on these values:

V1=2.0583 V

VC=10.1522 V

I p1=40.8 A

I p2=18.5 A

T=3.92 us

C=3 uF

Thus, LC=25.89 nH

### 4.2 ESL Circuit with Chosen SiC switch

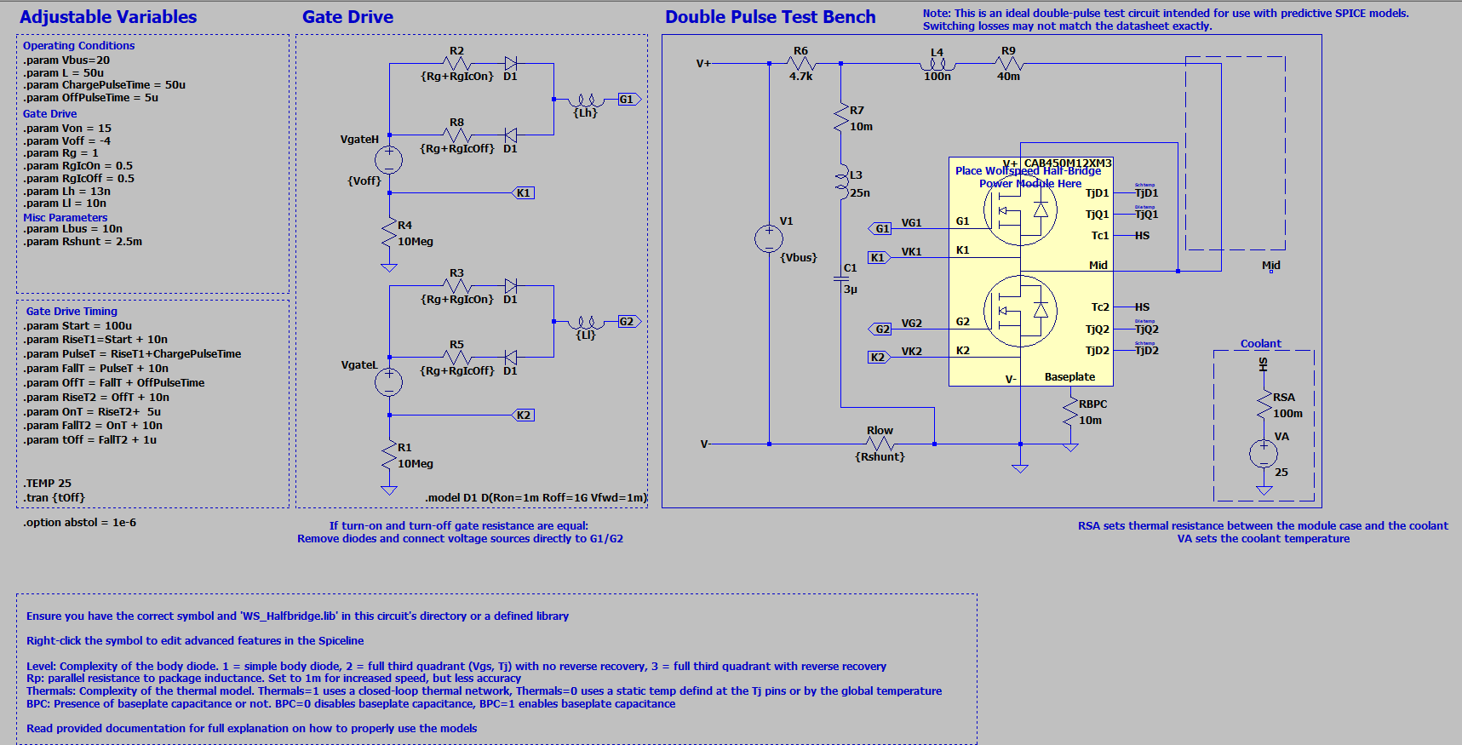
[picture p6: figure]

Figure 4.4: [Realistic simulation circuit of SiC switch for capacitor charge-discharge]

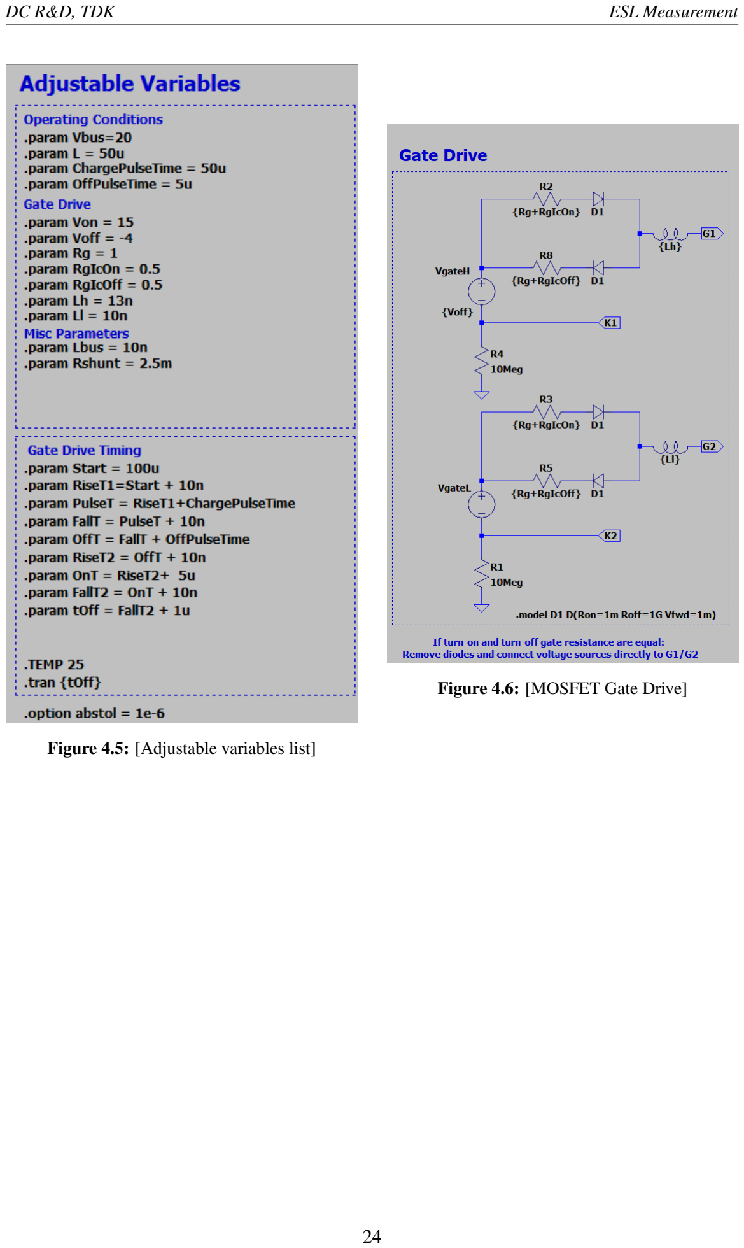
[picture p7: page 33]

Figure 4.5: [Adjustable variables list]

Figure 4.6: [MOSFET Gate Drive]

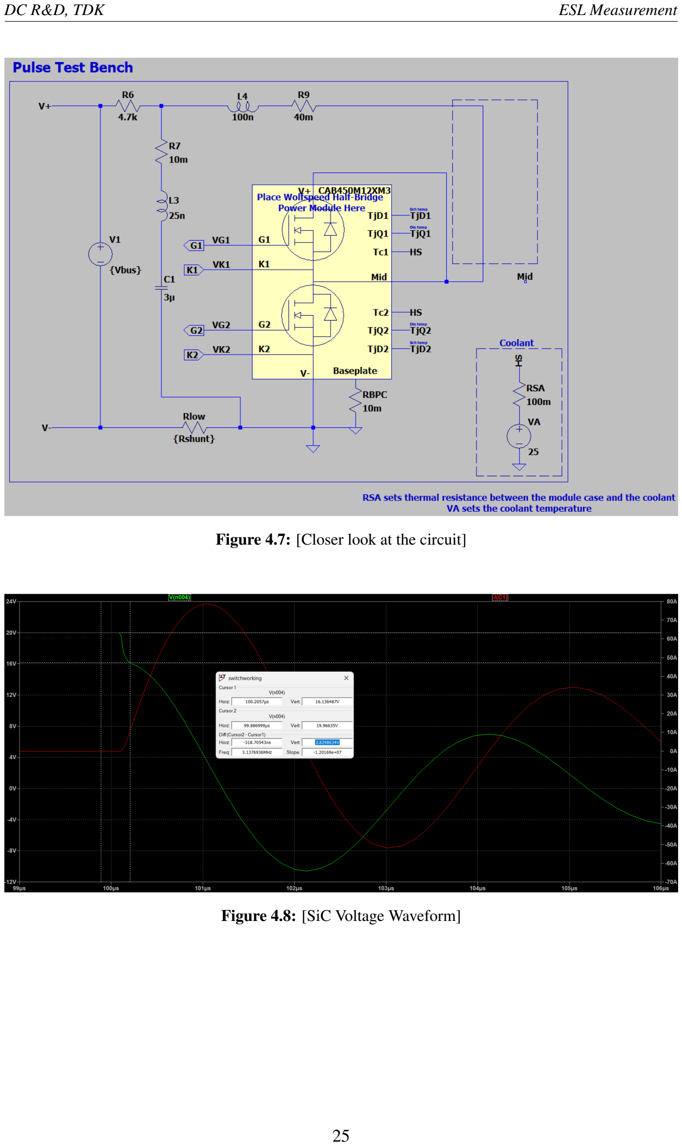
[picture p8: page 34]

Figure 4.7: [Closer look at the circuit]

Figure 4.8: [SiC Voltage Waveform]

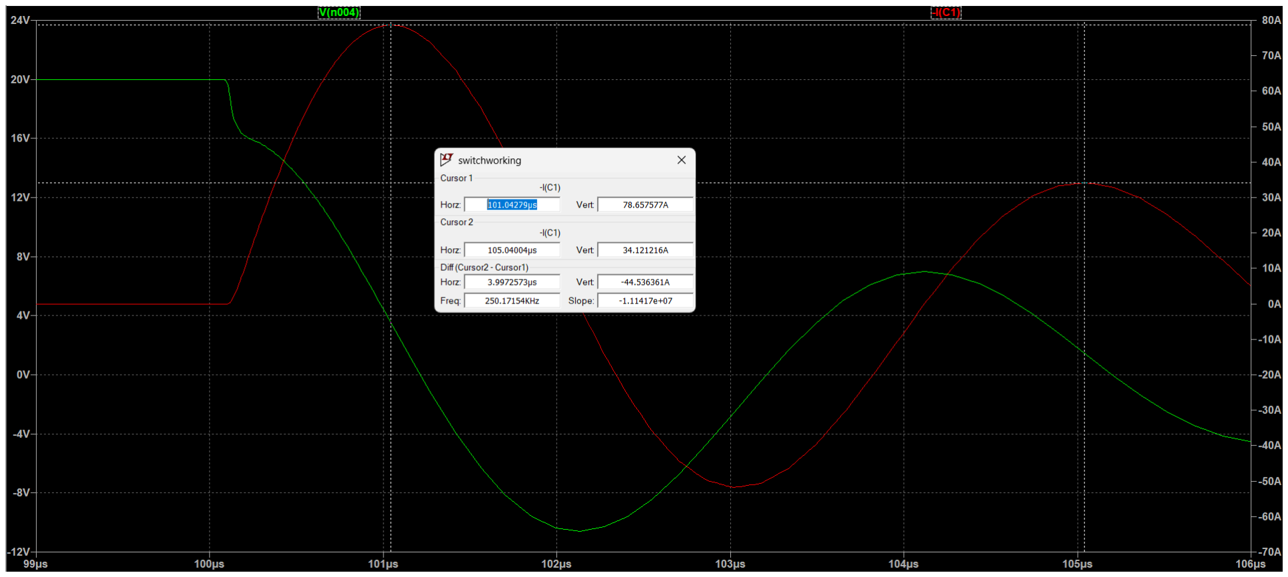
[picture p9: figure]

Figure 4.9: [SiC Current Waveform]

Based on these values:

V1=3.8 V

VC=19.96 V

I p1=78.65 A

I p2=34.1 A

T=4 us

C=3 uF

Thus, LC=25.27 nH

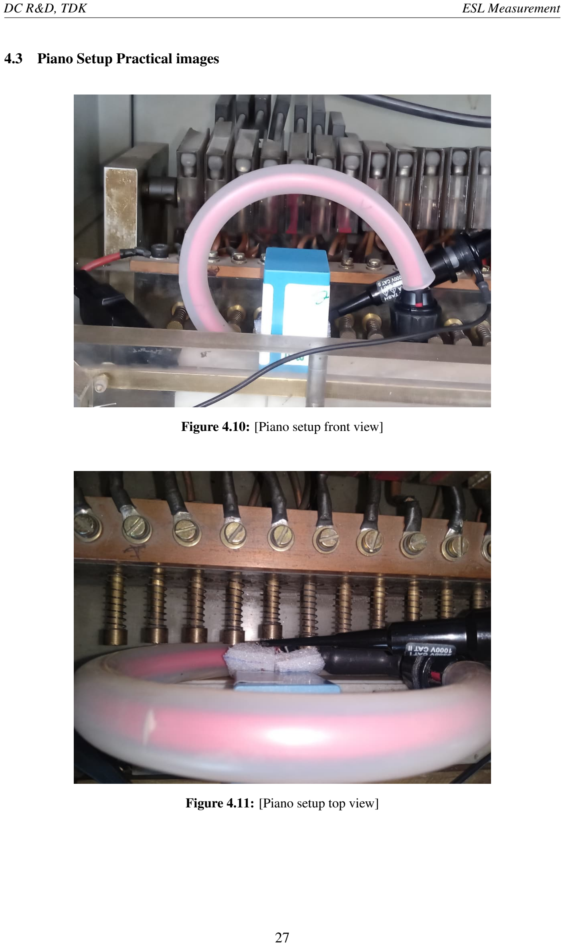
[picture p10: page 36]

### 4.3 Piano Setup Practical images

Figure 4.10: [Piano setup front view]

Figure 4.11: [Piano setup top view]

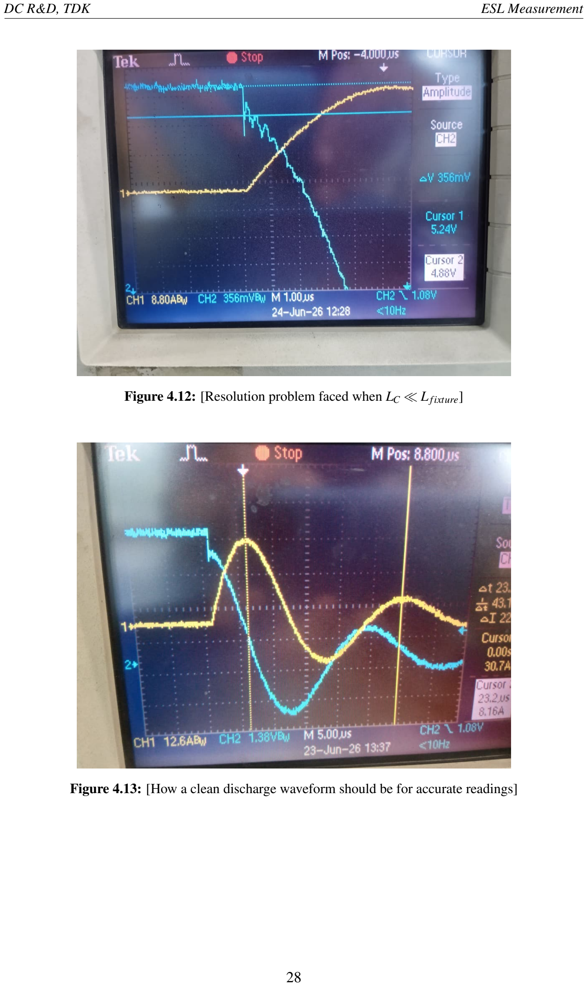
[picture p11: page 37]

Figure 4.12: [Resolution problem faced when LC ≪ Lfixture]

Figure 4.13: [How a clean discharge waveform should be for accurate readings]

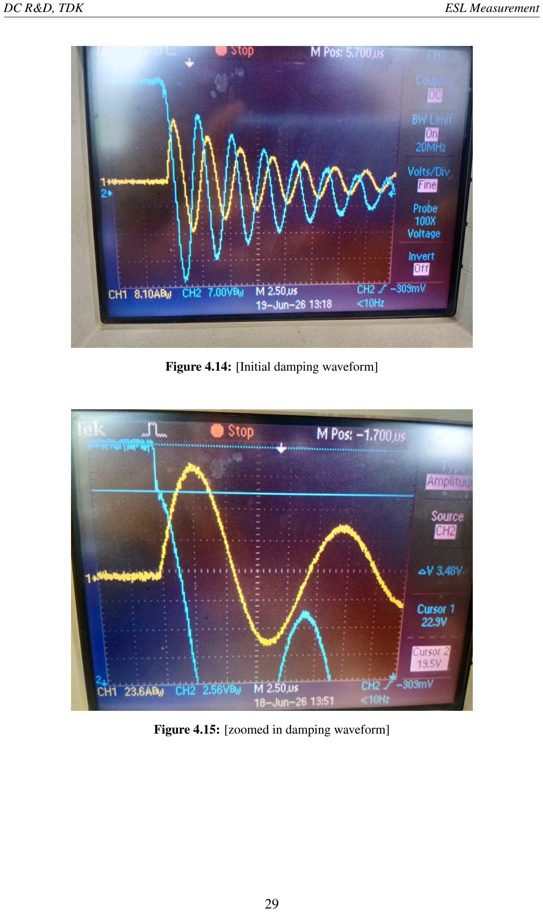
[picture p12: page 38]

Figure 4.14: [Initial damping waveform]

Figure 4.15: [zoomed in damping waveform]

### 4.4 Proposed test setup with copper bridge

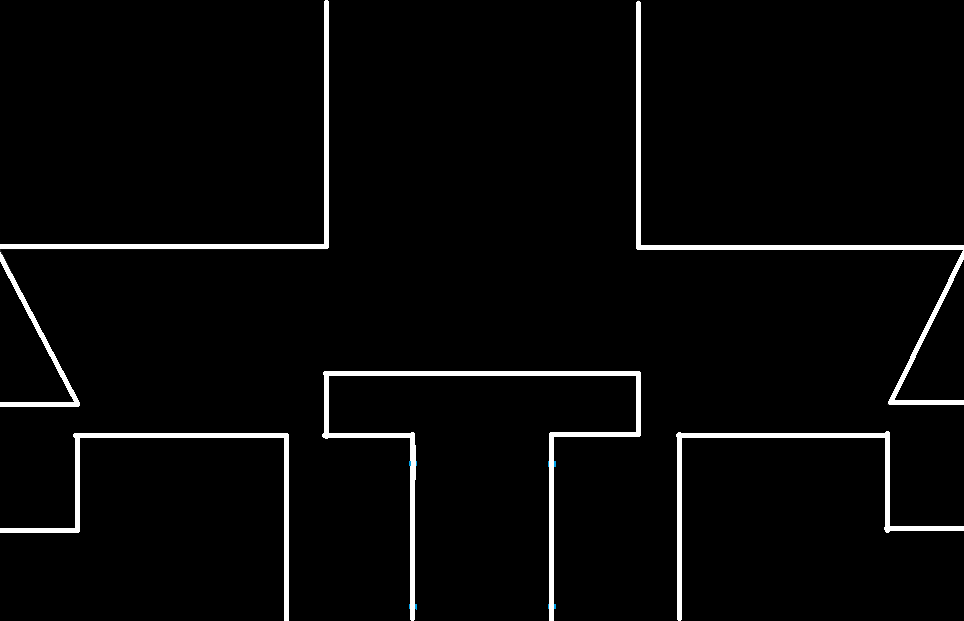
[picture p13: figure]

Figure 4.16: [A sample schematic for Copper H Bridge]

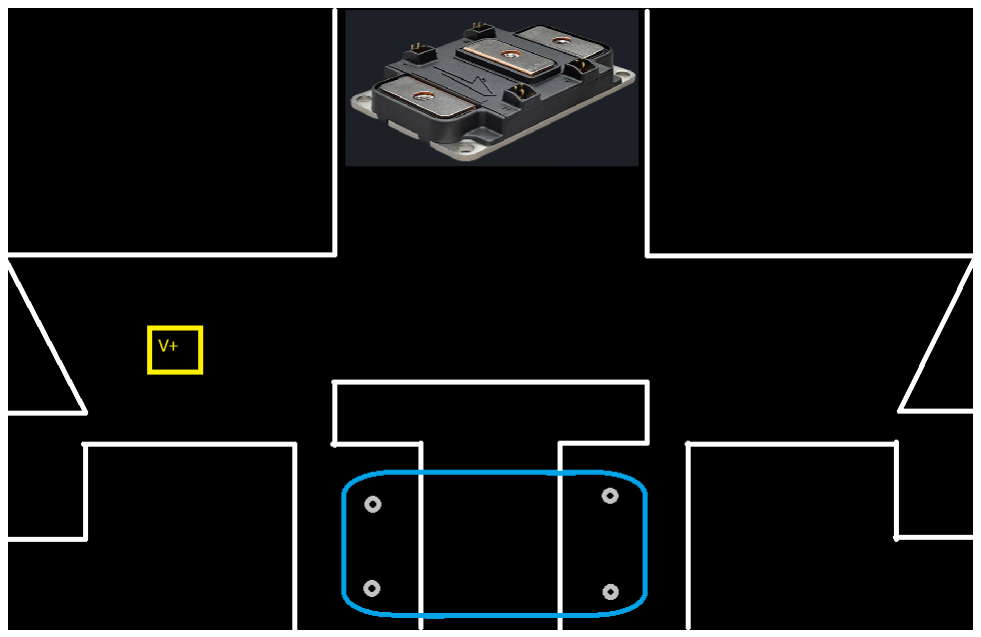
[picture p14: figure]

Figure 4.17: [Copper bridge fixture schematic]

The fixture consists of 2 parallel copper plates separated by a thin dielectric. The positive terminal pair of the capacitor is connected to the top plate and negative terminal pair to the bottom plate using two through holes. The DC power supply is given to the top plate thus making it the positive plate and bottom the reference ground. The switch is connected between the two plates which shorts the circuit to initiate capacitor discharge.

### CHAPTER 5

### RESULTS AND ANALYSIS

### 5.1 B32922 0.33 uF 2 terminal capacitor

### 5.1.1 Sample 1

Table 5.1: Readings for B32922 sample 1

Parameter | set 1 | set 2 | set 3 | set 4 | set 5
Vop | 242 | 259 | 290 | 273 | 245
Vc | 252 | 265 | 299 | 280 | 252
V1 | 11.8 | 13.4 | 13.9 | 13.6 | 12.2
V2 | 240 | 252 | 286 | 266 | 240
I1 (A) | 174 | 186 | 215 | 197 | 179
I2 (A) | 79.4 | 85.2 | 104 | 94.5 | 80.7
T (µs) | 2.52 | 2.5 | 2.52 | 2.5 | 2.52
C (µF) | 0.31483 | 0.31483 | 0.31483 | 0.31483 | 0.31483

a (10⁶
) | 0.311332325 0.312298306 0.288193499 0.293841755 0.316130066
ωr (M rad/s) 2.493327503 2.513274123 2.493327503 2.513274123 2.493327503

ω

2
0

6.313609853 6.414077049 6.299737529 6.402889794 6.316620255 ω0 (M rad/s) 2.512689765 2.532602821 2.509927794 2.530393209 2.513288733
1/L | 1.98771379 | 2.019343877 1.983346366 2.015821794 1.988661555
L (nH) | 503.090538 | 495.2103558 504.1983674 496.0755971 502.8507729
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

The theoretical value for a 4 terminal capacitor with d=1.2mm and l=42mm is (35.23 - 37.23)nH. We observe a higher reading due to noncompensated mutual inductance.

5.2.3 4 terminal with parallel copper plate

Table 5.10: Capacitor Discharge readings with copper plate

Parameter | set 1 | set 2 | set 3
Vop | 12 | 21 | 30
Vc | 5.24 | 8.18 | 11.5
V1 | 0.384 | 0.6 | 0.896
V2 | 4.86 | 7.58 | 10.6
I1 (A) | 30.3 | 48.8 | 68.9
I2 (A) | 9.15 | 15.5 | 21.6
T (µs) | 23.6 | 23.6 | 23.6
C (µF) | 28.70805 | 28.70805 | 28.70805

a (10⁶
) | 0.050737061 0.048597079 0.049151002
ωr (M rad/s) 0.266236666 0.266236666 0.266236666

ω

2
0

0.073456211 0.073243638 0.073297783 ω0 (M rad/s) 0.271028064 0.270635619 0.270735633
1/L | 2.108784591 2.102682026 2.104236421
L (nH) | 474.2068034 475.5830827 475.2317705
R (mΩ) | 48.11971899 46.22389712 46.71623526
Lc (nH) | 34.75103292 | 34.88384469 | 37.0267536

The theoretical value for a 4 terminal capacitor with d=1.2mm and l=42mm is (35.23 - 37.23)nH. We observe a similar reading, but there is a chance of overcompensation of mutual inductance and reduced values due to parallel geometry.

### CHAPTER 6

### CONCLUSION

This project successfully established a unified setup for measuring the Equivalent Series Inductance (ESL) of film capacitors by integrating the low-voltage surge discharge method with Silicon Carbide (SiC) MOSFET switching technology. The proposed system offers a robust, high-volume, and time-domain alternative to traditional impedance analyzers, simplifying instrumentation while maintaining high precision for nanohenry-scale ESL measurements in industrial R&D environments.

The principal findings and contributions of this work are:

- Validation of the Surge Discharge Method: The project standardized a calibration-free technique that extracts ESL by analyzing the underdamped ringing current waveform of a discharging capacitor. This approach achieved a combined measurement uncertainty of ±0.151 nH, outperforming traditional Auto-Balanced Bridge (ABB) and TDR methods.

For the B32922 0.33 µF 2-terminal capacitor, the experimental mean ESL was 23.66 nH (σ = 0.89 nH), which closely aligns with the theoretical expectation of 22.44–24.44 nH.

- Integration of SiC MOSFETs as a Sustainable Switch: To comply with the Minamata Convention’s phase-out of toxic mercury-wetted relays, the Wolfspeed CAB450M12XM3 SiC MOSFET was characterized as a sustainable, RoHS-compliant solid-state alternative. The SiC device provides a high blocking voltage capability (>1.2 kV), nanosecond transition speeds (2–10 ns), and a high current rise rate of 38.7 kA/µs. SPICE simula-tions confirmed that the SiC switch introduces minimal measurement error, yielding an inductance of 25.27 nH against an ideal 25.89 nH (a 2.4% deviation).
- Development of a Laminated Copper H-Bridge Fixture: Initial ESL measurements for 4-terminal capacitors were significantly overestimated (e.g., measuring 53.88–53.89 nH against a theoretical 35.23–37.23 nH) due to uncompensated mutual inductance between parallel pins. To mitigate this magnetic coupling, a high-precision laminated copper H-bridge fixture was proposed. By utilizing orthogonal flux decoupling, this fixture effectively cancels the mutual inductance, bringing the measured ESL within the theoretical target range.

Future Work

Future metrology improvements should focus on the following areas:

- Physical fabrication and experimental hardware validation of the proposed laminated copper H-bridge fixture and the complete SiC-based switching circuit.
- Automated waveform processing and parameter extraction to eliminate manual cursor errors and improve measurement repeatability for routine laboratory testing.
- Extending the methodology to reliably characterize capacitors with an ESL below 10 nH, where signal-to-noise ratio (SNR) constraints and shrinking V1/VC ratios heavily dominate

measurement uncertainty.

- Evaluating the system across a broader range of capacitor technologies and compensating for residual fixture parasitics through advanced calibration techniques.

Overall, the integration of advanced wide-bandgap switching with optimized fixtures ensures a compact and environmentally compliant system that can confidently maintain the strict inductance limits (10 nH to 50 nH) required by modern high-power systems and emerge as a reliable lab testing method.
