Gmj080305/Tdk/ESL_Method_comparison.pdf

## Advanced Metrological Characterization

## of Nanohenry Inductance and Capacitance

## in Metallized Film Capacitors

A Six-Method Comparative Analysis

Nanohenry Inductance & Capacitance in Metallized Film CapacitorsAdvanced Metrological Characterization

Contents

1 Auto-Balanced Bridge (ABB) Method | 2
2 Voltage Surge Discharge Method | 6
3 Vector Network Analyser (VNA) 2-Port Shunt-Thru Method | 8
4 Radio Frequency Current-Voltage (RF I-V) Method | 11
5 Resonant Cavity / Perturbation Method | 12
6 Time Domain Reflectometry / Transmission (TDR/TDT) Method | 14
7 Metrological Comparison Matrix | 15

Auto-Balanced Bridge (ABB) Method

Theoretical Foundations & Mathematical Derivations

The Auto-Balanced Bridge (ABB) architecture is the primary instrumentation standard for high-precision impedance measurements from low frequencies up to approximately 120 MHz. The working mechanism relies on maintaining a virtual ground potential at the low terminal of the Device Under Test (DUT), thereby neutralising the effect of parasitic impedances to ground and isolating the complex impedance vector of the film capacitor.

The complex impedance of a real metallized film capacitor is modelled by the series equivalent circuit:

Zx = R + j

ωL −

1

ωC
(1)

In the ABB configuration, a known AC voltage stimulus Vx is applied to the High-Force (Hcur) terminal of the DUT. The resulting current Ix flows through the capacitor to the Low-Force (Lcur) terminal. An active Operational Transimpedance Amplifier (OTA) detects any current flow at the Lcur node and dynamically adjusts its output voltage Vr through a known range-feedback resistor Rr to force the potential at the Lcur terminal to exactly zero volts. The nodal current-balancing equation at the virtual ground is:

Ix + Ir = 0 =⇒

Vx
Zx

+

Vr
Rr
= 0 | (2)

Solving for the complex impedance vector Zx:

Zx = −Rr ·

Vx
Vr

(3)

Decomposing the voltage ratio into real and imaginary parts, Vx Vr

= A + jB, and substi-tuting:
Zx = −Rr(A + jB) = Rs + jXs | (4)

where the apparent series resistance and reactance are:

Rs = −RrA | (5)
Xs = −RrB | (6)

At a single test frequency ω, a conventional instrument reports the apparent series capacitance Cs based on a simplified two-element capacitive model:

Cs = −

1
ωXs

=

1
ωRrB

(7)

However, near or above the self-resonant frequency (SRF), the inductive reactance coun-teracts the capacitive reactance, leading to a systematic overestimation of Cs. To isolate the true frequency-independent capacitance C and the nanohenry-range ESL (L), measurements must be performed at two distinct frequencies ω1 and ω2 within the capacitive regime:

Xs1 = ω1L −

1
ω1C

(8)

Xs2 = ω2L −

1
ω2C

(9)

Multiplying both equations by their respective angular frequencies:

ω1Xs1 = ω

2
1L −

1
C

(10)

ω2Xs2 = ω

2
2L −

1
C

(11)

Subtracting to eliminate the capacitive term yields the true ESL:

L =

ω1Xs1 − ω2Xs2
ω

2
1 − ω

2
2

(12)

Solving for the true capacitance C:

C =

ω

2
1 − ω

2
2
ω1ω

2
2Xs1 − ω

2
1ω2Xs2

(13)

Comprehensive Solved Numerical Example

The baseline DUT has the following true physical parameters:

C = 2.919 µF = 2.919 × 10⁻⁶ F L = 20.90 nH = 2.090 × 10⁻⁸ H R = 15.01 mΩ = 15.01 × 10⁻³ Ω

Two test points are evaluated:

f1 = 100 kHz | ⇒ ω1 = 2π × 10⁵ ≈ 628 318.5307 rad/s
f2 = 300 kHz | ⇒ ω2 = 2π × 3 × 10⁵ ≈ 1 884 955.5922 rad/s

At ω1:

XC1 = −

1
ω1C

= −

1
628318.5307 × 2.919 × 10⁻⁶

≈ −0.545 237 2 Ω

XL1 = ω1L = 628318.5307 × 2.090 × 10⁻⁸ ≈ 0.013 131 9 Ω

Xs1 = XL1 + XC1 = 0.0131319 − 0.5452372 = −0.532 105 3 Ω

Cs1 = −

1

ω1Xs1

=

1
628318.5307 × 0.5321053
≈ 2.991 101 µF | (14)

At ω2:

XC2 = −

1
ω2C

≈ −0.181 745 7 Ω

XL2 = ω2L ≈ 0.039 395 6 Ω
Xs2 = 0.0393956 − 0.1817457 = −0.142 350 1 Ω

Cs2 = −

1

ω2Xs2

≈ 3.725 916 µF | (15)

Dual-frequency parameter reconstruction:

Numerator = (628318.5307 × −0.5321053) − (1884955.5922 × −0.1423501)
= −334331.6136 − (−268323.4187) = −66008.1949 Denominator = (628318.5307)² − (1884955.5922)² = 3.94784 × 10¹¹ − 3.55306 × 10¹² = −3.15827 × 10¹²

L =

−66008.1949
−3.15827 × 10¹²
≈ 2.090 × 10⁻⁸ H = 20.90 nH ✓ | (16)

Reconstructing C:

Numerator = −3.15827 × 10¹²
Denominator = −1.188044 × 10¹⁸ − (−1.059293 × 10¹⁷) = −1.0821147 × 10¹⁸

C =

−3.15827 × 10¹²
−1.0821147 × 10¹⁸
≈ 2.918 612 × 10⁻⁶ F ≈ 2.919 µF ✓ | (17)

Practical Hardware Architecture & Bench Setup

The physical instrumentation consists of a Keysight E4990A Impedance Analyser inter-faced through a Four-Terminal Pair (4TP) configuration.

Keysight E4990A Front Panel | Coaxial Test Fixture
+ - - - - - - - - - - - - - - - - - - - - - - - - - - - - - - -+
+ - - - - - - - - - - - - - - - - - - - - - - - - - - - - - - -+
| H_cur ( High Current Out ) - - - - -| - - - - -| - - H_cur Terminal
| H_pot ( High Potential Sense ) - -| - - - - -| - - H_pot Terminal |
| L_pot ( Low Potential Sense ) - -| - - - - -| - - L_pot Terminal |
| L_cur ( Low Current Return ) - - -| - - - - -| - - L_cur Terminal |
+ - - - - - - - - - - - - - - - - - - - - - - - - - - - - - - -+
+ - - - - - - - - - - - - - - - - - - - - - - - - - - - - - - -+
| ( Gold - Plated Contact Jaws ) v
+ - - - - - - -+
| | DUT | |
+ - - - - - - -+

Calibration follows a strict SOP:

1. Open Compensation: Record residual stray admittance Yoc = Go + jωCo.
2. Short Compensation: Record residual series impedance Zsc = Rs + jωLs.
3. Load Compensation: Measure a precision 50 Ω coaxial resistor standard.

Analytical Accuracy & Uncertainty Budget

The phase angle at ω1:

θ = arctan
Xs
R

= arctan
−0.5321053

0.01501
≈ −88.384◦
(18)

Table 1: ABB Method – Inductance Uncertainty Budget

Error Source | Distribution | Std. Uncertainty | Sensitivity Coeff. | L Contri- bution
Phase Detector Resolution | Rectangular | ±0.005◦ | 1.25 × 10⁻¹⁰ H/
- ±0.063 nH
Residual Short Inductance | Normal (k = 1) | ±0.150 nH | 1.00 | ±0.150 nH
Range Resistor Drift | Triangular | ±10 ppm/
| | ◦C | 4.20 × 10⁻¹¹ H/ppm | ±0.042 nH
Guard-Loop Leakage | Rectangular | ±0.05 µA | 1.80 × 10⁻⁴ H/A | ±0.009 nH
Combined Uc | Normal (k = 1) | — | — | ±0.168 nH

Long-Term Reliability & Stability Analysis

Measurement stability is highly sensitive to thermal drift of the internal range-feedback resistors Rr. A drift of ±5

◦C shifts the transimpedance amplifier gain, causing phase errors that translate into false inductive reactances. Lab temperature must be maintained at 23 ◦C ± 1

◦C.

Calibration validity degrades through oxide formation on gold-plated contact tips, limiting the calibration lifespan to approximately 8 hours under continuous use.

Formal Gauge R&R Framework

The measurement system variance is modelled using ANOVA decomposition:

σ

2
total = σ

2
part + σ

2
system = σ

2
part + σ

2
repeatability + σ

2
reproducibility | (19)

Repeatability (Equipment Variance, EV ):

EV = 5.15 ·

√
MSE | (20)

Reproducibility (Appraiser Variance, AV ):

AV =

r
(5.15 · σoperator)

2 −

EV ²
n · r

(21)

Method-Specific Vulnerability: Manual clamping depth variance of ±1.5 mm introduces ±1.5 nH AV (7.1% relative error for the 20.90 nH baseline).

Mitigation Protocols:

- Pneumatic Clamping Slides: Constant contact force 6.5 N ± 0.1 N.
- Ceramic Depth Stops: Alumina ceramic stops limit insertion depth to 1.50 mm± 0.05 mm.

Voltage Surge Discharge Method

Theoretical Foundations & Mathematical Derivations

The Voltage Surge Discharge Method is an active time-domain technique used to isolate ESL and ESR from the underdamped ringing current produced when a pre-charged capacitor discharges through a low-impedance switch. The discharge loop is modelled as a series RLC circuit governed by:

L

d

2
i(t)
dt²

+ R

di(t)
dt +

1
C
i(t) = 0 | (22)

Dividing by L:
d

2
i(t)
dt²

+

R
L

di(t)
dt +

1
LC i(t) = 0 | (23)

The characteristic roots are: s1,2 = −α ±

q
α² − ω

2
0 | (24)

where:

α =

R
2L
(Neper frequency) | (25)

ω0 =

1
√
LC
(undamped resonant frequency) | (26)

For the underdamped condition (α < ω0), the damped resonant frequency is:

ωd =

q
ω

2
0 − α² =

s
1
LC −
R
2L

2
(27)

With initial conditions q(0) = CV0 and i(0) = 0:

i(t) = V0
ωdL

e

−αt sin(ωdt) | (28)

The damped period is measured from consecutive zero-crossings:

Td =

2π
ωd

=⇒ ωd =

2π
Td

(29)

The logarithmic decrement from two consecutive positive peaks I1, I2:

δ = ln
I1
I2
= αTd =⇒ α =

δ
Td

(30)

Then:

ω0 =

q
ω

2
d + α²
(31)

Lloop =

1
ω

2
0C

(32)

Rloop = 2αLloop | (33)

After subtracting calibrated external parasitics:

L = Lloop − Lext | (34)
R = Rloop − Rext | (35)

Comprehensive Solved Numerical Example

True DUT parameters: C = 2.919 µF, L = 20.90 nH, R = 15.01 mΩ.

Calibrated loop parasitics: Lext = 10.00 nH, Rext = 5.00 mΩ.

Total loop: Lloop = 30.90 nH, Rloop = 20.01 mΩ. Charge voltage V0 = 1000 V.

α =

0.02001
2 × 3.090 × 10⁻⁸
≈ 323 786.4078/s | (36)

ω0 =

1
√
3.090 × 10⁻⁸ × 2.919 × 10⁻⁶
≈ 3 330 031.5369 rad/s | (37)

ωd =

q
ω

2
0 − α² ≈ 3 214 198.5414 rad/s | (38)

Td =

2π
ωd
≈ 1.9548 µs | (39)
δ = αTd ≈ 0.632945 | (40)

First peak at:

tpeak =

1
ωd

arctanωd
α
≈ 457.46 ns | (41)
I1 ≈ 8638.64 A | (42)

I2 = I1e

−δ ≈ 4587.35 A | (43)

Reconstruction yields Lloop ≈ 30.90 nH, so:

L = 30.90 − 10.00 = 20.90 nH ✓ | (44)

Practical Hardware Architecture & Bench Setup

+ - - - - - - - - - - - - - - - - - - - - - - - - - - - - - - - - - - - - - - - - - - - - - - - - - - - - - - -+
| | --> Charging Resistor (100 kOhm ) | |
| | + | |
| | v | |
| | + - - - - - - - - - - - - - - - - - - - - - - - - - - - - - - - - - - - - - - - - - - - - - - - - - -+ | |

| | | | + - - - - - - - - - - - - - - - - -+ | + - - - - - - - - - - - - - - - - -+ | | | |
| | | | | | Film Capacitor | | | Coaxial Current | | | | |
| | | | | | ( DUT ) | | | | | Shunt (0.1 mR ) | | | | | |
| | | | + - - - - - - - - - - - - - - - - -+ | + - - - - - - - - - - - - - - - - -+ | | | |
| | + - - - - - - - - - - - - - - - - - - - - - - - - - - - - - - - - - - - - - - - - - - - - - - - - - -+ | |
| | Faraday Shielded Coaxial Housing | |
+ - - - - - - - - - - - - - - - - - - - - - - - - - - - - - - - - - - - - - - - - - - - - - - - - - - - - - - -+
- Switching Element: Gas-filled spark gap, fall time < 10 ns.
- Current Sensor: Coaxial current viewing resistor, 1 GHz bandwidth, 0.1 mΩ.
- Digitizer: 2 GS/s, 10-bit real-time digitizer.

Analytical Accuracy & Uncertainty Budget

Table 2: Voltage Surge Discharge – Inductance Uncertainty Budget

Error Source | Distribution | Std.
Uncertainty

Sensitivity
Coeff.

L Contri-bution

Digitizer Sampling
Jitter
Rectangular | ±500 ps | 3.16 ×
10⁻² nH/ns

±0.016 nH

Spark Gap Dynamic
Resistance

Normal
(k = 2)
±0.80 mΩ | 1.50 × 10⁻⁹ H/Ω | ±0.120 nH

Dummy Block
Calibration Error
Triangular | ±0.05 nH | 1.00 | ±0.035 nH

Coaxial Shunt Thermal
Drift

Normal
(k = 1)
| | | | | | ±0.2% | | 4.18 ×
10⁻² nH/%

±0.084 nH

Combined Uc | Normal
(k = 1)
— | — | ±0.151 nH

Formal Gauge R&R Framework

Vulnerabilities:

- Spark gap gas pressure variation ±0.1 bar introduces AV = ±0.4 nH.
- Inconsistent clamping torque varies contact resistance and loop inductance.

Mitigation:

- Digital mass flow controllers at 2.20 bar ± 0.01 bar.
- Pneumatic torque wrenches at 4.5 N m ± 0.1 N m.

Vector Network Analyser (VNA) 2-Port Shunt-Thru Method

Theoretical Foundations & Mathematical Derivations

The 2-Port Shunt-Thru configuration is the metrological standard for ultra-low impedances (µΩ to Ω) from kHz to GHz. The DUT is connected in shunt between the two 50 Ω VNA ports:

Port 1 (50 Ohm ) - - - -+ - - - - - - - - - - - - - - - -+ - - - - Port 2 (50 Ohm )

+ - - - - - - - - - - - - - - - - - - - -+
| | DUT | |
+ - - - - - - - - - - - - - - - - - - - -+
GND | GND

The transmission coefficient is:

S21 =

| | 2ZDUT
2ZDUT + Z0

(45)

Solving for ZDUT:

ZDUT =

Z0
2

·

S21
1 − S21

(46)

For ZDUT ≪ 25 Ω (S21 ≪ 1), the linear approximation holds:

ZDUT ≈

Z0
2
- S21 = 25 · S21 | (47)

With S21 = Re(S21) + j Im(S21), the exact formula after rationalising gives:

ZDUT = 25 ·

Re(S21) − |S21|

2

+ j Im(S21)
(1 − Re(S21))² + Im(S21)

2

(48)

Parameter extraction over a wide sweep:

R(ω) = Re(ZDUT) | (49)

X(ω) = Im(ZDUT) = ωL −

1
ωC | (50)

Above SRF (f ≫ fSRF): L ≈

Im(ZDUT)
ω

Below SRF (f ≪ fSRF): C ≈ −

1
ω · Im(ZDUT)

Comprehensive Solved Numerical Example

At f = 1.0 MHz (ω ≈ 6.2832 × 10⁶
rad/s), above the 644 kHz SRF:

XC = −

1
ωC

≈ −0.054 524 Ω

XL = ωL ≈ 0.131 319 Ω
X = 0.131319 − 0.054524 ≈ 0.076 795 Ω ZDUT = 0.01501 + j0.076795 Ω

Calculated S21:

S21 ≈ 6.09458 × 10⁻⁴ + j3.06811 × 10⁻³ | ⇒ | |S21| ≈ −50.09 dB | (51)

Reconstructed impedance:

Re(ZDUT) ≈ 15.01 mΩ | (52)
Im(ZDUT) ≈ 76.79 mΩ | (53)

Using known C to correct:

L =

0.07679 + 1
ωC
ω

=

0.07679 + 0.054524
6.2832 × 10⁶

≈ 2.090 × 10⁻⁸ H = 20.90 nH ✓ (54)

Practical Hardware Architecture & Bench Setup

+ - - - - - - - - - - - - - - -+ | + - - - - - - - - - - - - - - - - - - -+ | + - - - - - - - - - - - - - - -+
| VNA Port 1 | | - - - -| | J2102A | | - - - -| | Coplanar | |
| | | | | | Common Mode Xfmr | | | | Microstrip | |
+ - - - - - - - - - - - - - - -+ | + - - - - - - - - - - - - - - - - - - -+ | | | Probe Head | |
+ - - - - - - - - - - - - - - -+ | + - - - - - - - - - - - - - - - - - - -+ | | | ( Film Cap | |
| VNA Port 2 | | - - - -| | J2113A | | - - - -| | DUT Shunt ) | |
| | | | | | Semi - Float Amp | | | + - - - - - - - - - - - - - - -+
+ - - - - - - - - - - - - - - -+ | + - - - - - - - - - - - - - - - - - - -+

Ground-loop elimination requires:

- J2102A common-mode coaxial transformer on Port 1.
- J2113A differential amplifier on Port 2.
- Full 2-Port SOLT calibration at the capacitor terminal contacts.

Analytical Accuracy & Uncertainty Budget

IF bandwidth must be ≤ 10 Hz to keep trace noise below 0.005 dB at the −50 dB transmission level.

Table 3: VNA 2-Port Shunt-Thru – Inductance Uncertainty Budget

Error Source | Distribution | Std.
Uncertainty

Sensitivity
Coeff.

L Contri-bution

Dynamic Range Trace
Noise

Normal
(k = 1)
| | | ±0.005 dB | | 1.20 ×
10⁻¹⁰ H/dB

±0.006 nH

Calibration Plane
Phase Jitter

Normal
(k = 2)
| | | ±0.02 rad | | 2.50 ×
10⁻¹⁰ H/rad

±0.005 nH

Common-Mode
Leakage
Rectangular | ±0.05% | 1.80×10⁻¹⁰ H/% | ±0.090 nH

Microstrip Probe Lead
Drift
Triangular | ±0.15 mm | 1.00 ×
10⁻⁹ H/mm

±0.087 nH

Combined Uc | Normal
(k = 1)
— | — | ±0.125 nH

Formal Gauge R&R Framework

Vulnerabilities:

- Cable flexing during loading alters phase delay (EV ).
- Probe tip wear introduces parasitic shunt capacitance (EV ).

Mitigation:

- Semi-rigid copper-jacketed cables clamped to an optical bench.
- Automated sub-micron 3-axis stage positioners with integrated pressure indicators.

Radio Frequency Current-Voltage (RF I-V) Method

Theoretical Foundations & Mathematical Derivations

The RF I-V method covers 1 MHz to 3 GHz using a passive coaxial transmission-line test head. The complex impedance is:

Zx =

Vx
Ix

(55)

With complex calibration scaling vectors Hv(ω), Hi(ω):

Zx =

Hv(ω) · Vv
Hi(ω) · Vi

= Zref(ω) ·

Vv
Vi

(56)

Above SRF the inductance dominates. The correction formula for the true ESL:

L =

Xs +

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
ω²C |{z}

correction

(57)

Comprehensive Solved Numerical Example

At f = 10 MHz (ω ≈ 6.2832 × 10⁷
rad/s):

XC ≈ −0.005 452 4 Ω
XL ≈ 1.313 185 7 Ω
Xs = 1.3131857 − 0.0054524 = 1.307 733 3 Ω Zx = 0.01501 + j1.3077333 Ω
|Zx| ≈ 1.307 819 4 Ω, θ ≈ 89.3424◦

Raw (uncorrected) inductance:

Lraw =

Xs
ω

=

1.3077333
6.2832 × 10⁷
≈ 20.813 nH (error: 0.41%) | (58)

Applying the correction term:

1
ω²C

=

1
(6.2832 × 10⁷
)

2 × 2.919 × 10⁻⁶

≈ 8.678 × 10⁻¹¹ H ≈ 0.087 nH | (59)
L = 20.813 + 0.087 = 20.90 nH ✓ | (60)

Analytical Accuracy & Uncertainty Budget

Table 4: RF I-V Method – Inductance Uncertainty Budget

Error Source | Distribution | Std. Uncertainty | Sensitivity Coeff.

L Contri-bution

Residual Contact Inductance | Normal (k = 1)
±50 pH | 1.0 | ±0.050 nH
Phase Detector Gain Error | Normal (k = 2) | ±0.15% | 3.13 × 10⁻² nH/%

±0.023 nH

Low-Loss Cap Cal Drift | Rectangular | ±0.02 pF | 8.20 × 10⁻² nH/pF

±0.002 nH

Transformer Thermal Drift | Triangular | ±12 ppm/
| | ◦C | 4.50 × 10⁻¹¹ H/ppm
±0.010 nH
Combined Uc | Normal
(k = 1)
— | — | ±0.056 nH

Formal Gauge R&R Framework

Mitigation Protocols:

- Micrometer clamping slides: lead alignment within ±50 µm.
- Calibrated pre-loaded springs: constant contact force 8.0 N ± 0.2 N.

Resonant Cavity / Perturbation Method

Theoretical Foundations & Mathematical Derivations

When a low-loss capacitor is inserted into a high-Q coaxial cavity resonator, it perturbs the cavity boundary conditions, shifting the resonant frequency and Q factor.

The input impedance of a shorted coaxial transmission line of length h:

Zin = jZc tan(βh), β =

ω
c

(61)

At cavity resonance, ZDUT + Zin = 0. Equating imaginary parts and noting that 1
ωC → 0
at high RF frequencies:
ωL + Zc tan
ωh
c
= 0 | (62)

Solving for the true series inductance:

L = −

Zc
ω

tan
ωh
c
(63)

The ESR is extracted from the quality factor shift:

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
PDUT
ωWs

=⇒ R = K · ∆

1
Q
(64)

Comprehensive Solved Numerical Example

Cavity parameters: Zc = 50 Ω, h = 0.15 m, Q0 = 1200, designed for f0 = 500 MHz.

The transcendental equation with θ = 5 × 10⁻¹⁰ω:

41.80 θ + 50 tan(θ) = 0 =⇒ tan(θ) = −0.836 θ | (65)

Root (fundamental quarter-wave mode): θ ≈ 2.0933 rad.

Perturbed resonant frequency:

f =

10⁹ × 2.0933
π
≈ 666.32 MHz | (66)

The 20.90 nH ESL shifts the cavity from 500.00 MHz to 666.32 MHz.

Reconstruction:

ω = 2π × 666.32 × 10⁶ ≈ 4.1866 × 10⁹
rad/s | (67)
βh ≈ 2.0933 rad | (68)

L = −

50
4.1866 × 10⁹

tan(2.0933) = −1.1943 × 10⁻⁸ × (−1.7500) ≈ 20.90 nH ✓ (69)

Analytical Accuracy & Uncertainty Budget

Table 5: Resonant Cavity – Inductance Uncertainty Budget

Error Source | Distribution | Std. Uncertainty | Sensitivity Coeff. | L Contri- bution
Cavity Length Expansion ∆h | Normal (k = 1) | ±5 µm | 1.40 × 10⁻⁷ H/m | ±0.007 nH
NA Peak Search Resolution | Normal (k = 2) | ±100 Hz | 3.10 × 10⁻¹⁷ H/Hz | ≈ 0.000 nH
Zc Machining Variance | Rectangular | ±0.05 Ω | 4.20×10⁻¹⁰ H/Ω | ±0.021 nH
Coupler Loading Perturbation | Triangular | ±0.10% | 1.50 × 10⁻² nH/% | ±0.015 nH
Combined Uc | Normal
(k = 1)
— | — | ±0.027 nH

Formal Gauge R&R Framework

Mitigation Protocols:

- Micrometer depth stop: insertion depth 3.00 mm ± 0.01 mm.
- Pneumatic collet actuators: clamping force 15.0 N ± 0.1 N.

Time Domain Reflectometry / Transmission (TDR/TDT) Method

Theoretical Foundations & Mathematical Derivations

TDR injects an ultra-fast voltage step into a 50 Ω coaxial path shunt-loaded by the DUT. The Laplace-domain reflection coefficient, assuming R ≪ Z0:

Γ(s) ≈

sL − Z0
sL + Z0

(70)

For a unit-step input Vinc(s) = V0 s

, the inverse Laplace transform yields:

vmeas(t) = 2V0 e

−

Z0
L

t
- u(t) | (71)

The inductance is extracted from the exponential time constant τ :

τ =

L
Z0
=⇒ L = Z0 · τ | (72)

For non-ideal (finite rise-time) step excitation, the integration method is used:

L = 2Z0

Z t2

t1

ρ(t) dt | (73)

Comprehensive Solved Numerical Example

With V0 = 1.0 V and Z0 = 50 Ω:

τ =

L
Z0

=

20.90 × 10⁻⁹
50
= 418.0 ps | (74)

vmeas(t) = 2.0 · e

−t/418.0 ps V | (75)

The oscilloscope tracks the decay from 2.0 V to 2.0/e ≈ 0.735 76 V, giving tτ = 418.0 ps:

L = 50 × 418.0 × 10⁻¹² = 2.090 × 10⁻⁸ H = 20.90 nH ✓ | (76)

Integration method verification:

Area = L
2Z0

=

2.090 × 10⁻⁸
100
= 209.0 ps | (77)
L = 2Z0 · Area = 2 × 50 × 209.0 × 10⁻¹² = 20.90 nH ✓ | (78)

Analytical Accuracy & Uncertainty Budget

Table 6: TDR Method – Inductance Uncertainty Budget

Error Source | Distribution | Std.
Uncertainty

Sensitivity
Coeff.

L Contri-bution

Oscilloscope Timing
Jitter

Normal
(k = 1)
| ±500 fs | 1.20 × 10⁻¹ nH/ps | ±0.060 nH

Step Amplitude
Fluctuations
Normal (k = 2) | ±0.50% | 4.20 × 10⁻² nH/% | ±0.011 nH

CPW Z0 Machining
Tolerance
Rectangular | ±0.25 Ω | 4.20×10⁻¹⁰ H/Ω | ±0.105 nH

Time Gating Window
Drift
Triangular | ±2.0 ps | 5.00 × 10⁻² nH/ps | ±0.100 nH
Combined Uc | Normal
(k = 1)
— | — | ±0.158 nH

Formal Gauge R&R Framework

Mitigation Protocols:

- Calibrated SMA torque wrenches: 0.90 N m ± 0.05 N m.
- Vacuum-assisted pick-and-place arms: lead alignment within ±10 µm.

Metrological Comparison Matrix

Table 7: Side-by-side performance of all six metrological methodologies

Method | Impedance Range
Frequency
Range

Primary Failure
Mode

GRR
Risk
Auto-Balanced Bridge (ABB) | 10 mΩ – 100 MΩ 20 Hz –
120 MHz

Op-amp loop gain
rolloff at high
frequencies causes
anomalous
negative C or
ESR

Medium

Voltage Surge
Discharge
1 mΩ – 10 Ω | Time-domain (100 kHz to 5000 kHz equiv.)

Spark gap arc
non-linearity and
digitiser jitter
degrade peak
fitting for ESR

High

VNA 2-Port
Shunt-Thru

20 µΩ – 10 Ω 100 kHz – 3 GHz

Coaxial ground
loops bypass
DUT,
overestimating
ESR

Low

(continued)

Method | Impedance
Range

Frequency
Range

Primary Failure
Mode

GRR
Risk

RF Current-Voltage (RF
I-V)
100 mΩ – 50 kΩ | 1 MHz – 3 GHz | Residual contact inductance in test-head adapter obscures true ESL

Medium

Resonant
Cavity /
Perturbation

1 mΩ – 100 mΩ 100 MHz – 1 GHz

Humidity and
thermal drift shift
baseline resonant
frequency

Medium

Time Domain
Reflectometry
(TDR)

1 mΩ – 500 Ω Transient step (10 MHz – 20 GHz equiv.)

Finite step rise
time blurs
inductive
transition peak;
gating window
errors

Low
