Gmj080305/Tdk/TDK_presentation.pptx

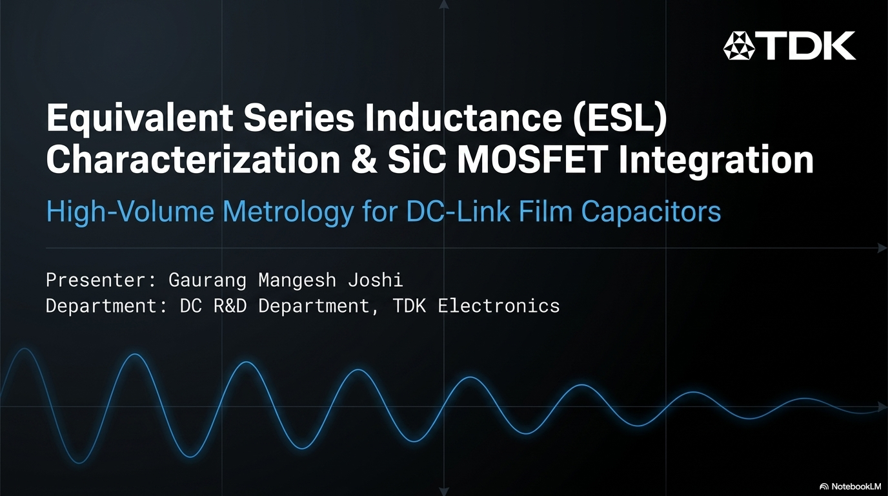
[picture p27: figure]

## Slide 2

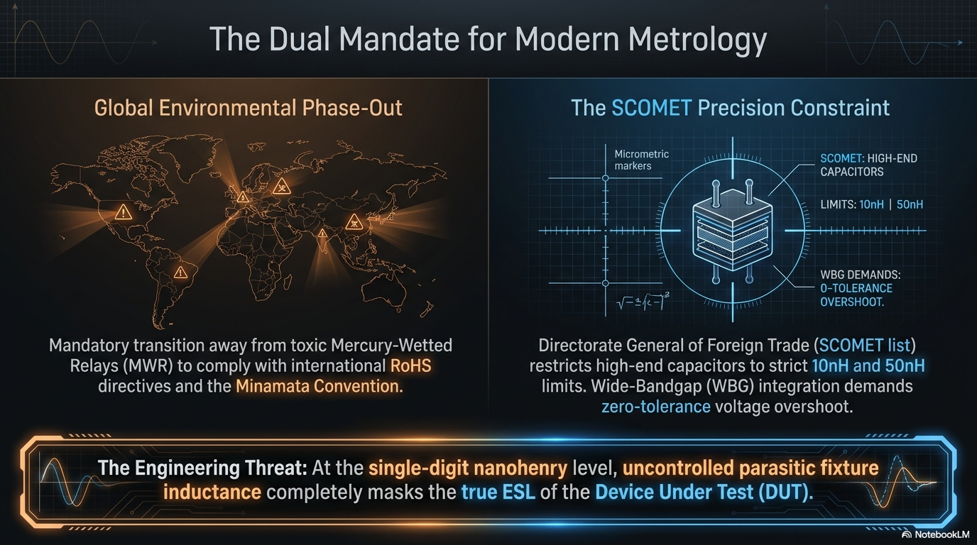
[picture p28: figure]

## Slide 3

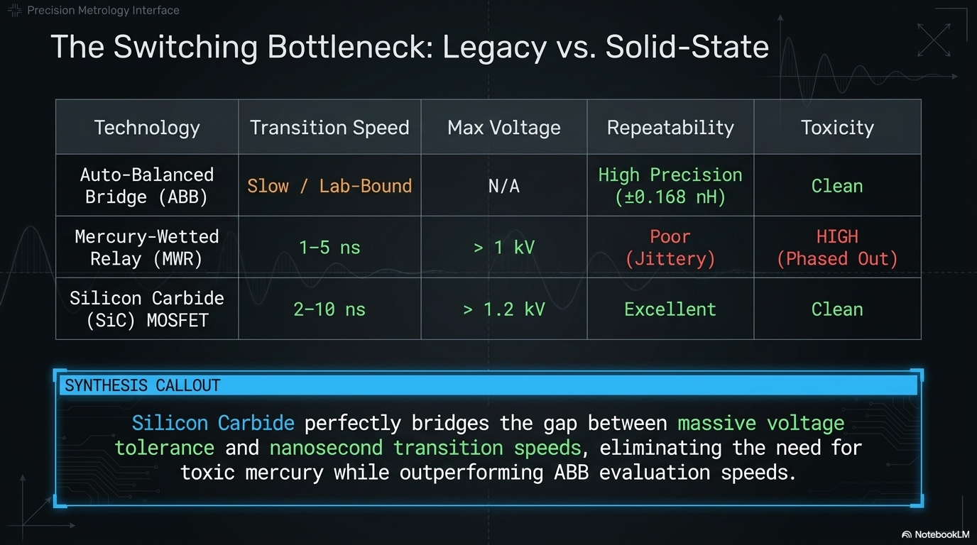
[picture p29: figure]

## Slide 4

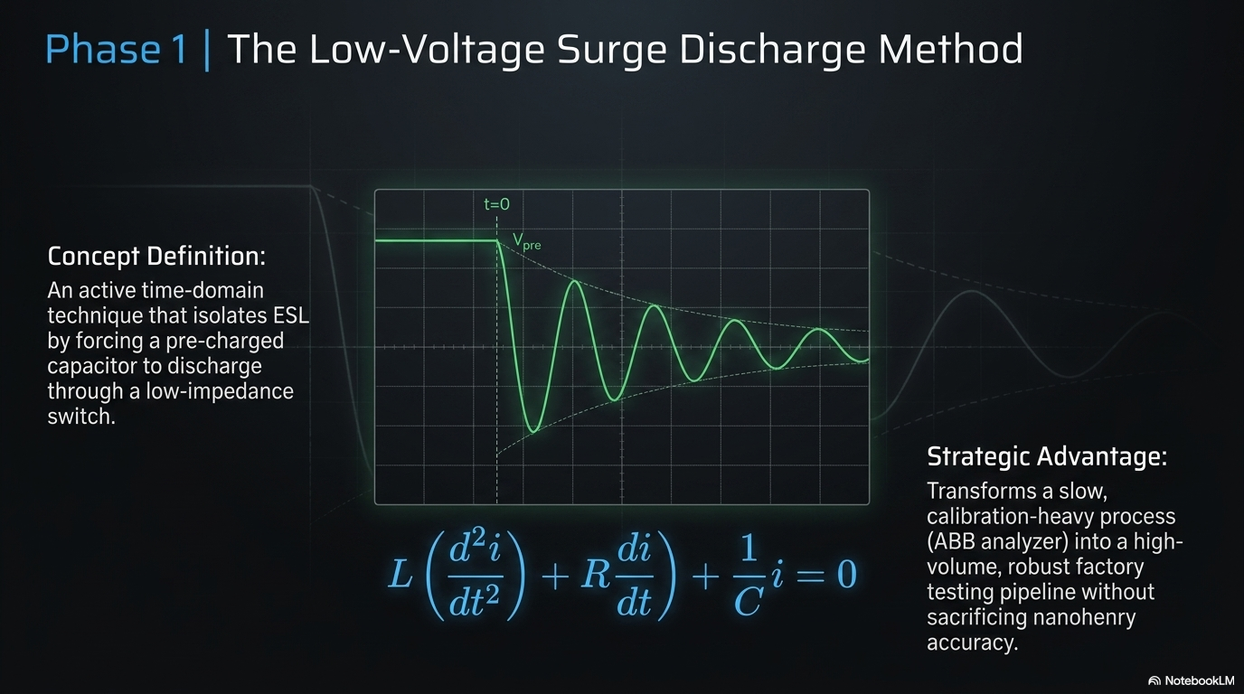
[picture p30: figure]

## Slide 5

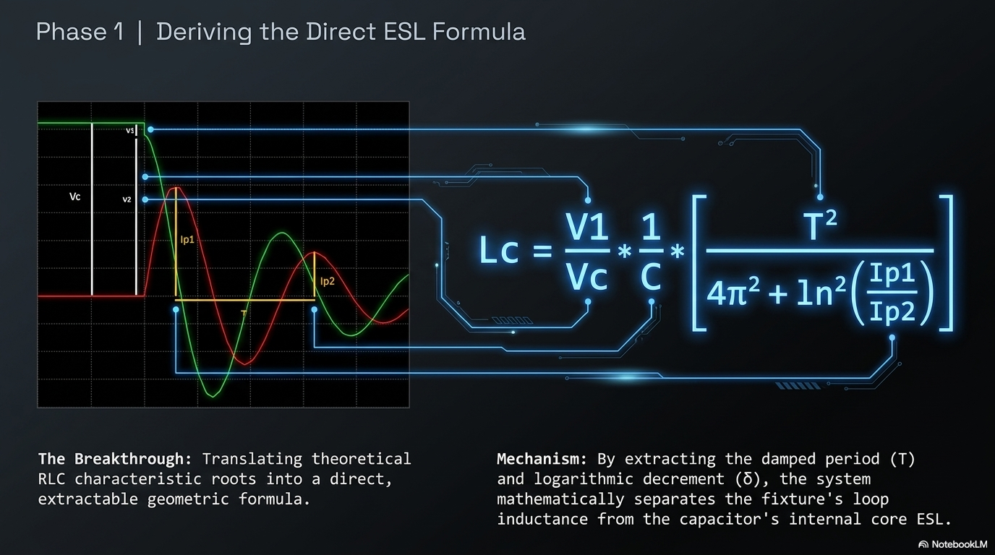
[picture p31: figure]

## Slide 6

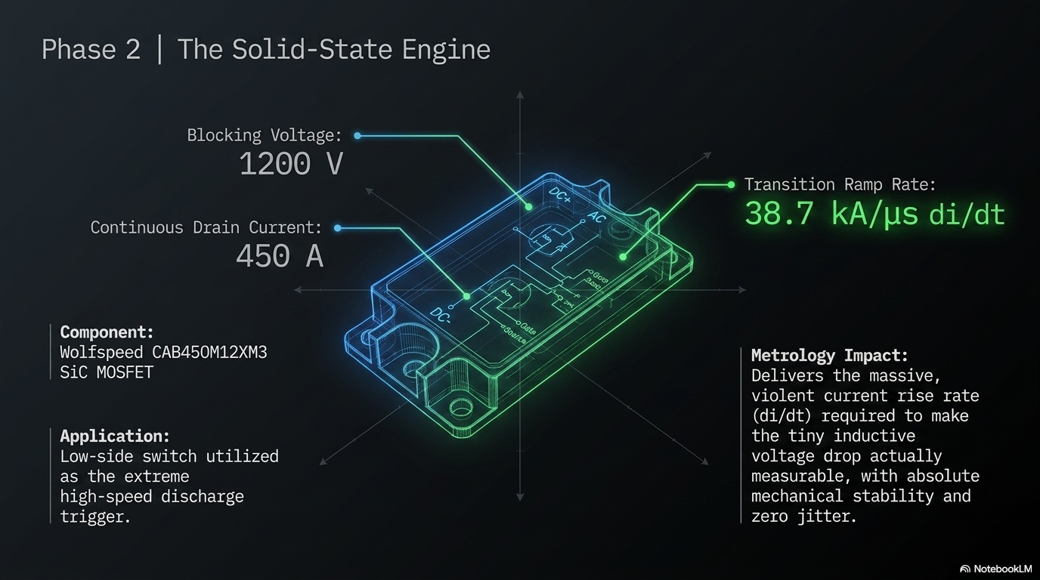
[picture p32: figure]

## Slide 7

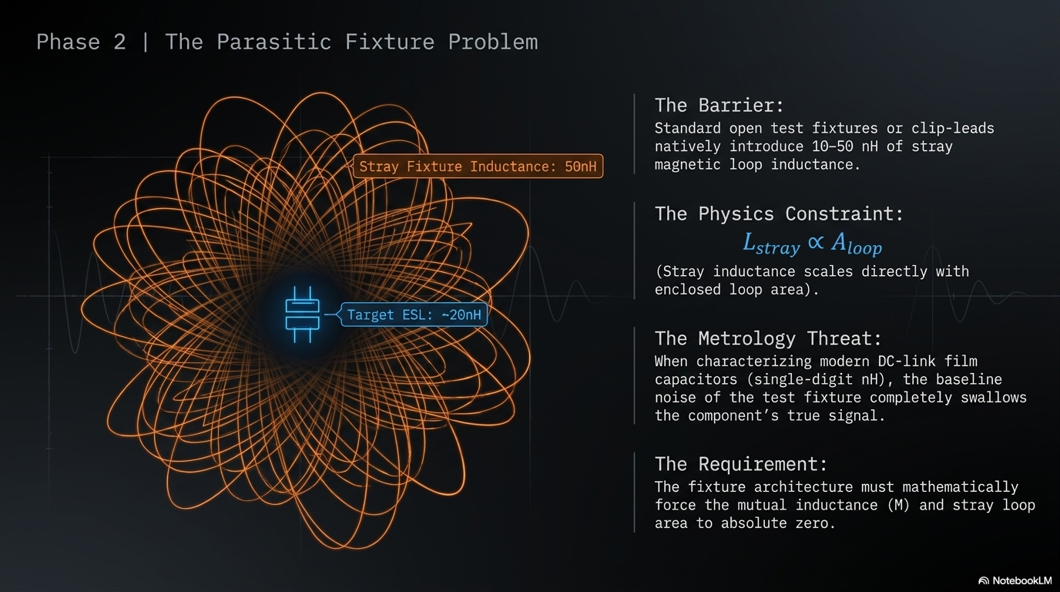
[picture p33: figure]

## Slide 8

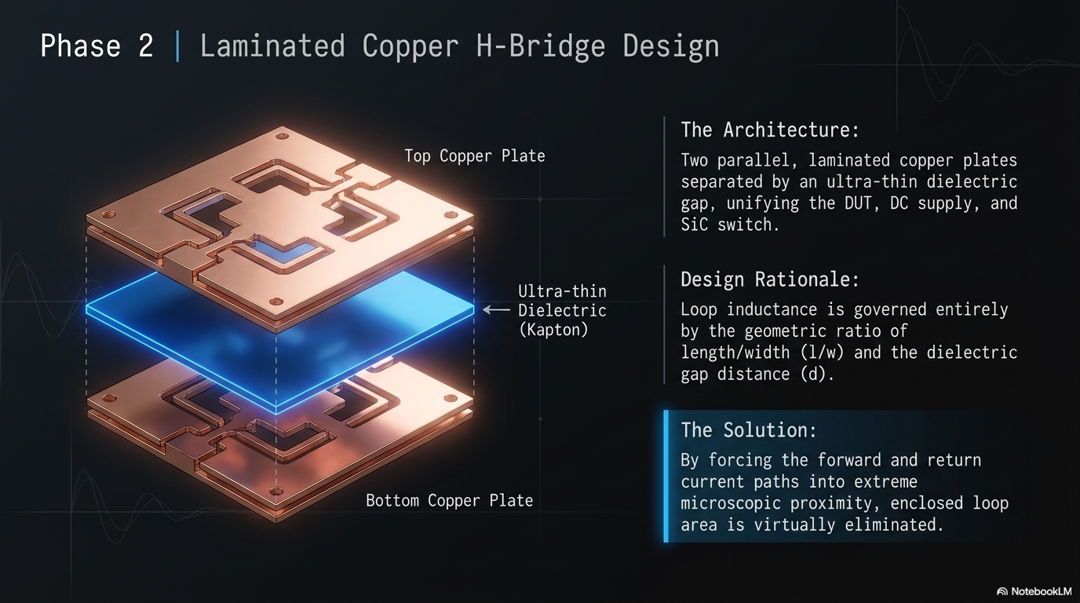
[picture p34: figure]

## Slide 9

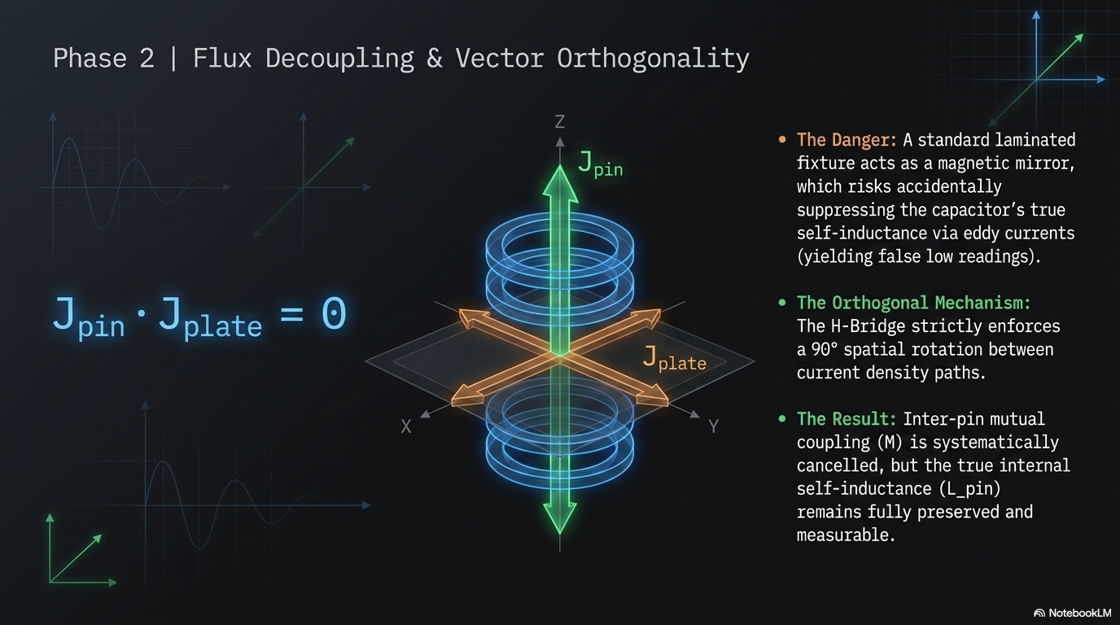
[picture p35: figure]

## Slide 10

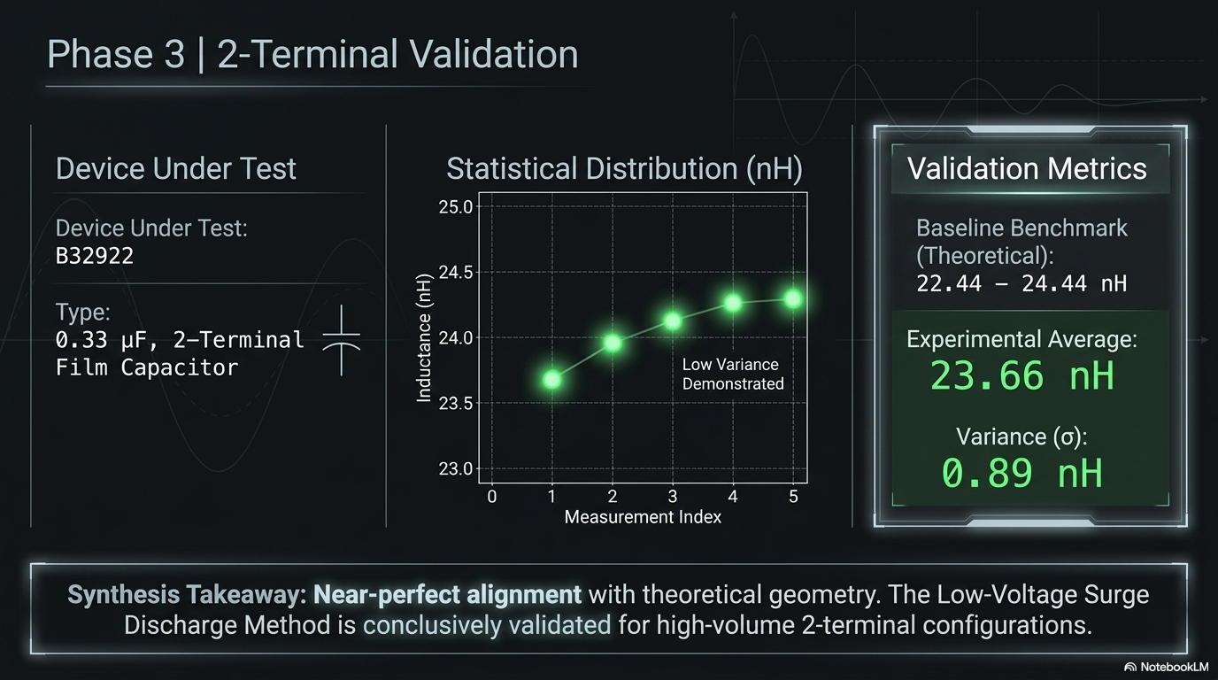
[picture p36: figure]

## Slide 11

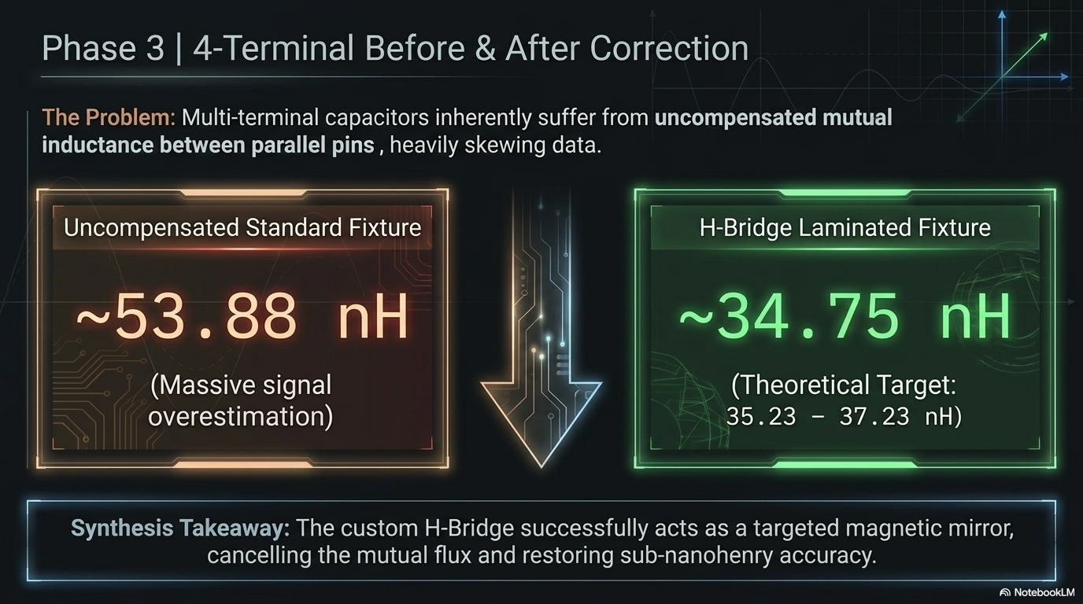
[picture p37: figure]

## Slide 12

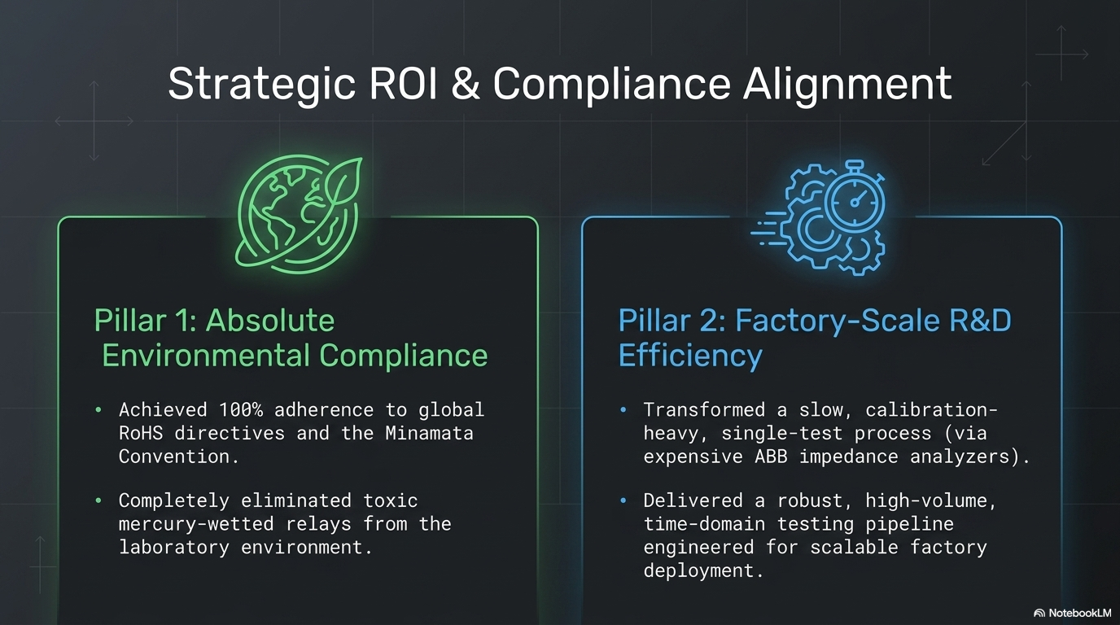
[picture p38: figure]

## Slide 13

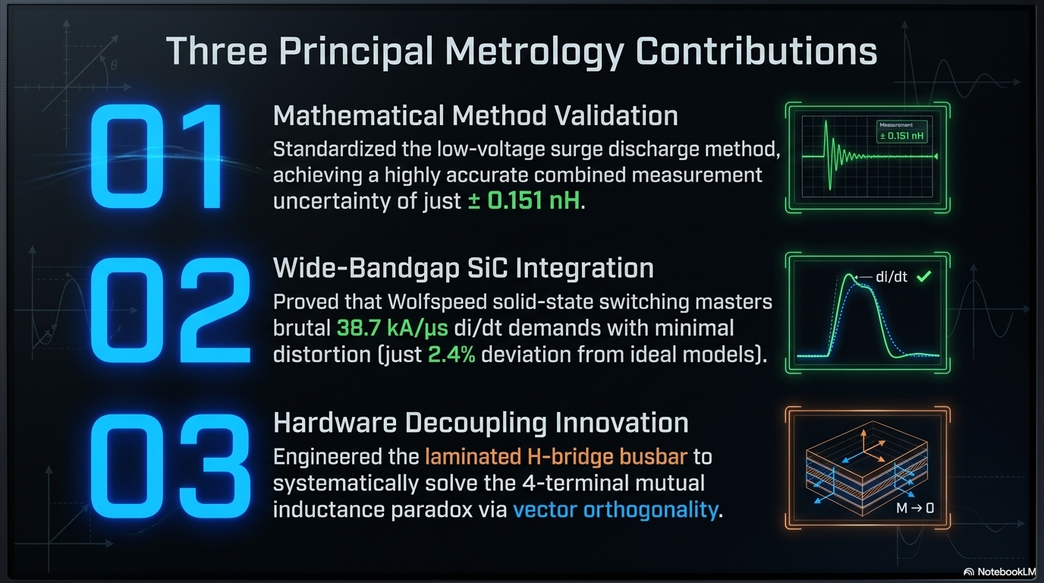
[picture p39: figure]

## Slide 14

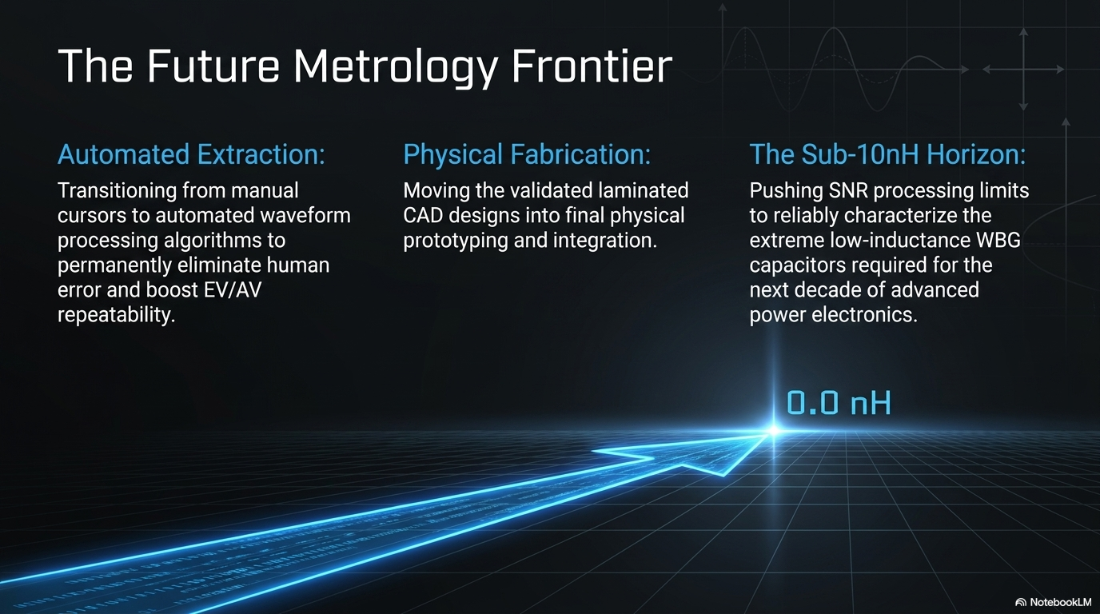
[picture p40: figure]
