Gmj080305/Tdk/copper_h_bridge.png

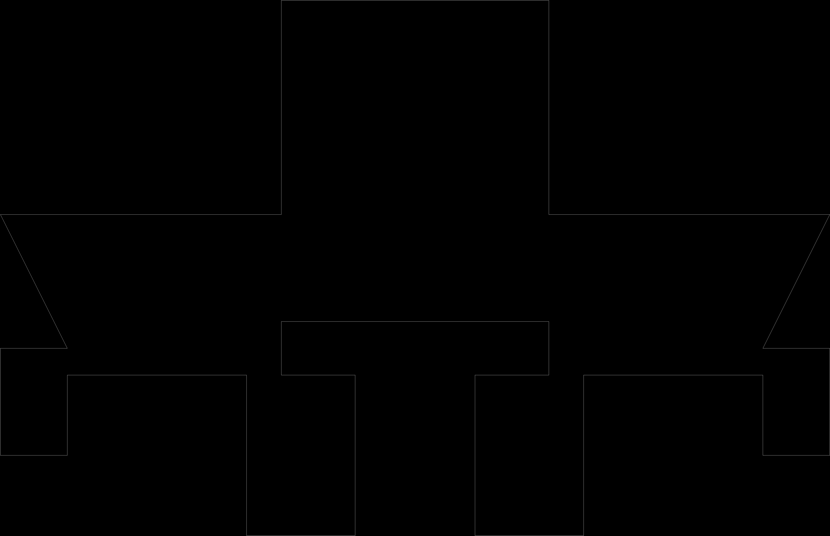
copper_h_bridge.png
