Gmj080305/Tdk/H_Bridge_Plate_1to1.dxf

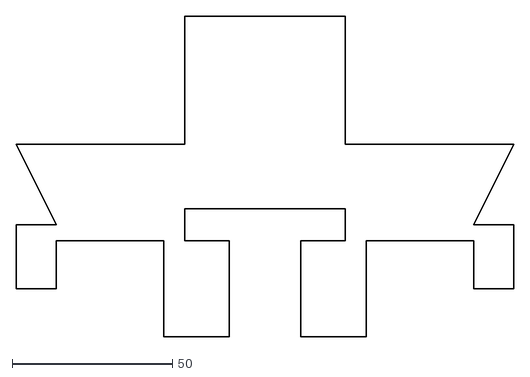
[picture p42: CAD file, 2026-06-25]
H_Bridge_Plate_1to1.dxf
155.0 x 100.0
