Gmj080305/Tdk/(commit log)

2026-06-05 Create Capacitor charge-discharge test.md
2026-06-10 luminix switch report
2026-06-12 Create IC switch setup.md
2026-06-12 Create switch simulation.md
2026-06-15 Add comprehensive business development report: SiC vs Mercury Relays for film capacitor discharge applications
2026-06-16 Create Capacitor ESL Surge-Discharge Measurement — Diagnostic Report.md
2026-06-19 Create Characterization of Equivalent Series Inductance in Multi-Terminal Power Film Capacitors.md
2026-06-24 Add detailed Markdown reports: Project1 ESL measurement and Project2 SiC switching (PoC/business)
